ultrazohm/uz_per_wolfspeed_25kw_fm3/Meeting_Minutes(TemporarilyHere)/Meeting Minutes 30.01.25.docx

Questions:

- For the 3.3V LDO, the specific model that we need is TPS7A2033PDBVR
  - But I just used a generic model TPS7A20 for the Altium schematic and footprint. Is this okay?? How will the manufactuerers know it’s the 3.3V output specific model? Through our schematic?
  - NVM i got the 3.3V version through Ultrarian Library
- Decoupling capacitor also needed for 2.5VOCM right?
- Also for the 3.3V – 5V rail increase feedback resistor
  - Calculations – R1=6k6 R2=10k but 6k6 resistors not available
  - So did 6k8 and 10k as 10k3 resistors also not available. Is this okay?

ToDos:

- Make sure all the same F capacitors are the same model
- Make sure all the same R resistors are the same model
- Final check to make sure if possible same model components are used

Meeting Minutes

Capacitance

- General rule of thumb – all ICs add like 100nF in the input
- Our power
  - 100nF and add 1uF in the input ✅ 1uF first and then the 100nF
- For all of the components
  - Add capacitace for all the components
- Change all the 0.1uF to 100nF ✅
- E96 resistor line

Feedback for Op amps

- 6k65 0.1% and 10k 0603 package size
  - On DBeaver
    - Find 0603 package size resistor, change all the parameters for 6k65 and 0.1% ✅
      - Take parameters from https://jlcpcb.com/partdetail/Yageo-RT0603BRD076K65L/C861536 ✅
    - And then it will appear on Altium ✅
  - Change the 10k resistors to 0.1% as well ✅

Clean up the connector sheet – readable ✅

Shortcut to see what everything is connected to – alt + click.

2 layer PCB or 4 layer PCB look at what is better

- 4 layer seems likely
- https://jlcpcb.com/capabilities/pcb-capabilities

Ideally, return current flows back in the same way it came – just on a different layer

Ideally current passes through all the capacitors – place vias in a way that this happens

Make sure all layers have a similar amount of copper – to prevent bending

For PCB layout, for the specific ICs, look at the data sheets for inspiration

ToDos:

- Rooms feature to layout pcb
  - For vias 10mil uaually quite big
- Ideally set the rules looking at the jlcpcb capabilities
  - Github rules for the jlc rules
    - https://github.com/ayberkozgur/jlcpcb-design-rules-stackups/tree/master/design-rules/altium
    - Import 4layer-1oz.RUL (https://github.com/ayberkozgur/jlcpcb-design-rules-stackups/blob/master/design-rules/altium/4layer-1oz.RUL) rules
- Also check all components and make sure they are available in JLCPCB/LCSC
  - Price as well
  - If not chose something similar that is available
