ultrazohm/uz_per_wolfspeed_25kw_fm3/Meeting_Minutes(TemporarilyHere)/Midterm Presentation/MidtermPresentation.docx

Thesis Topic:

Interfacing a Two-Level Silicon Carbide Inverter to a Rapid Control Prototyping Platform

Topics to Cover:

- Wolfspeed 2-Level Silicon Carbide Inverter
  - Explanation
    - 800V level
      - Background on market technology
    - Why is Wolfspeed developing this
    - Why do we want to connect Ultrazohm
- Ultrazohm
  - Very briefly as everyone is probably quite familiar with it
- Outline Goal: To interface the Wolfspeed inverter with Ultrazohm - instead of the TI controller card
- Steps Taken until now:
  - Block diagram - identifying the signals the control card is getting from the inverter in the first place
    - We don’t include RSLV_PWM, 3-phase voltage conditioning and SIN/COS signals
      - FIGURE OUT WHY!
    - For all of the signals we determines requirements (such as frequency bandwidth, voltage levels, current levels)
  - LTspice simulations of all the important signal pathways
    - To determine voltage & current levels
      - Ex. There is a bias of 1.68V in the current conditioning because of external 3.3V source
    - Fully Differential Op amps used to do differential analog signaling
      - Because current conditioning is the most important for control - WHY??
    - Defining different voltage levels needed on the interface board
  - Altium
    - Schematic design
      - Power - LDO for 3.3V level, Voltage references for 2.5V and 1.7V level - why did we not also use a voltage reference for the 3.3V level?
        - Making sure that the current budget is kept in mind and fulfilled - 5V 1A input (from the inverter - check again to make sure the correct component that is supplying this)
        - Current pull of
          - Op amp
          - Receivers/Transmitters & dual inverter
          - AND IC
          - Etc.
      - Overcurrent detection - x2 IC of 3 pairs of AND gates - so in the end there is only one signal coming out from the 6 inputs
      - OpAmps with bias
        - Adjusting feedback to the 5V TTL level of the connected analog card - CHECK AND MAKE SURE
      - Decoupling capacitors
      - Ferrite Beads
      - LEDs for indication that it is working
    - PCB Layout
      - Layout finished under review

Next Steps:

- Ordering PCB
- Soldering components - WHAT COMPONENTS WILL I HAVE TO SOLDER ON?
  - Receivers/transmitters
  - Etc.
- Signal Test PCB
  - To test the integrity of the signals
    - We will have another PCB with the connectors signals separated in such a way that we can measure it
- Hook up to Wolfspeed Inverter and coupled motor in the Lab to Test if the interface works!
