ultrazohm/uz_per_wolfspeed_25kw_fm3/Altium_HotKeys.docx

Altium Hotkeys:

- C-C – Validate
- Messages – shows you all the errors
- T-M -> suppress all the errors

During polygon placement:

- Space bar changes the orientation of the vertices
- Change corner angles using Shift + Space
  - Supported corner types:
    - 45 degrees – only use this
    - Rounded 45
    - 90 degrees
    - Rounded 90
- Right mouse button click 2 times to complete polygon
- Tab to go to polygon properties

SHIFT + F -> find similar objects

CTRL + SHIFT + Scroll to change layers

SHIFT + S to toggle transparency
