ultrazohm/uz_per_wolfspeed_25kw_fm3/TI Edge Connector/Edge_connector_check.docx

TOP

1 3 5 … 55 57 119

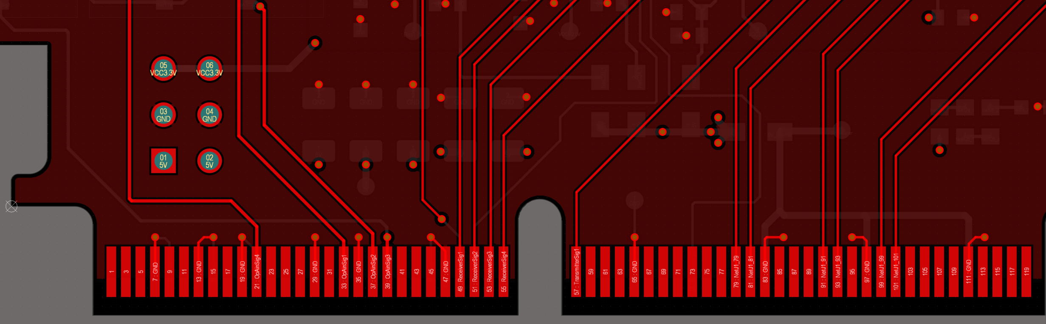
[picture p13: figure]

1 3 5 … 55 57 119

BOTTOM

120 118 … 58 56 2

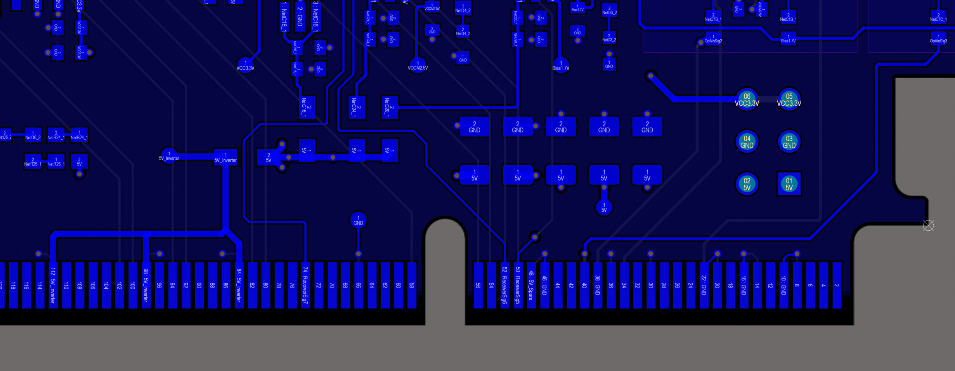
[picture p14: figure]

120 118 … 58 56 2

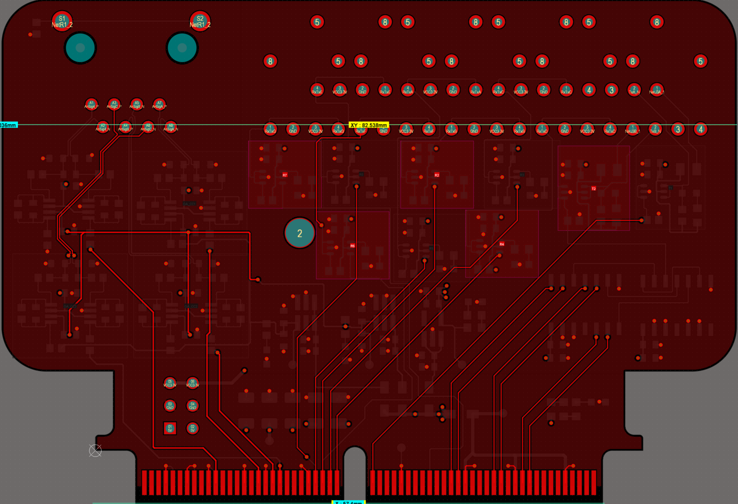
[picture p15: figure]
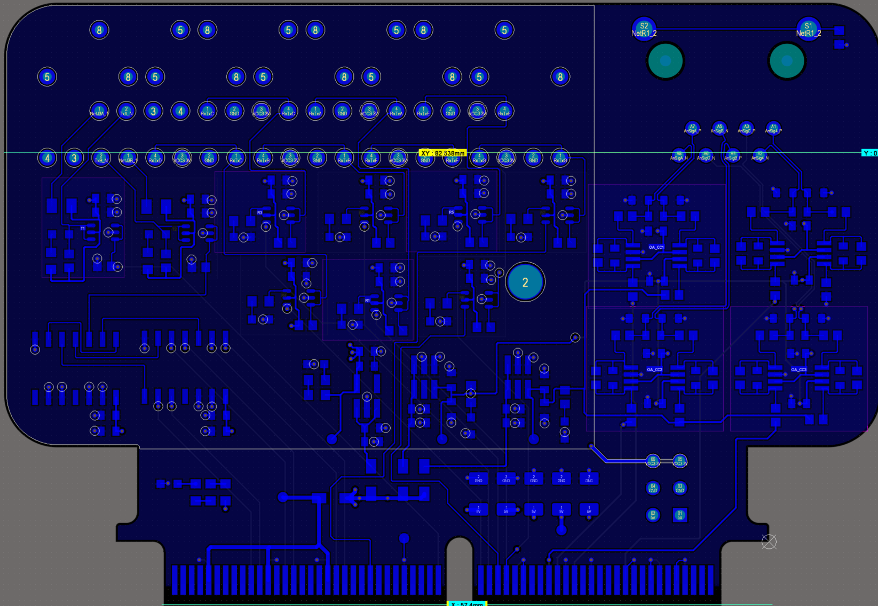
[picture p16: figure]
