ultrazohm/uz_per_wolfspeed_25kw_fm3/Meeting_Minutes(TemporarilyHere)/ToDos_for_051224.pdf

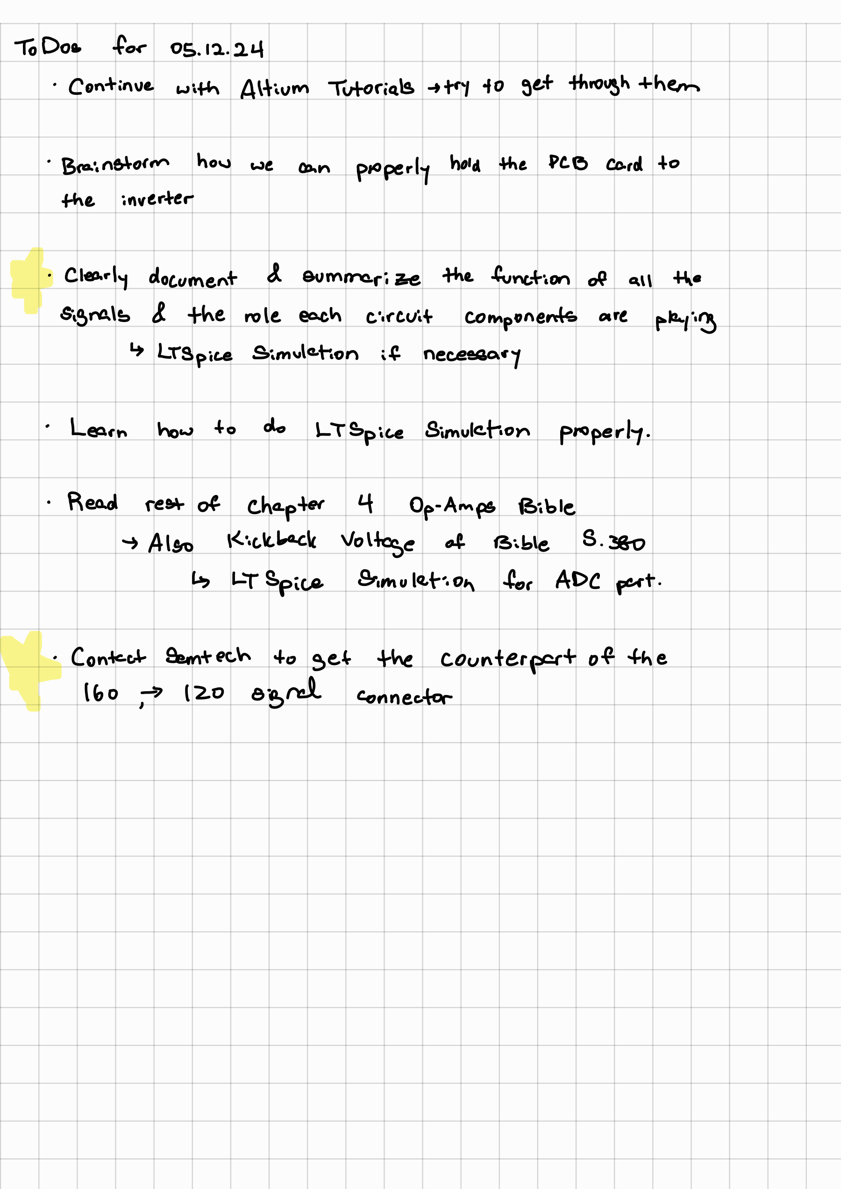
[picture p17: page 1]
