ultrazohm/uz_per_wolfspeed_25kw_fm3/Meeting_Minutes(TemporarilyHere)/ToDos_for_141124.pdf

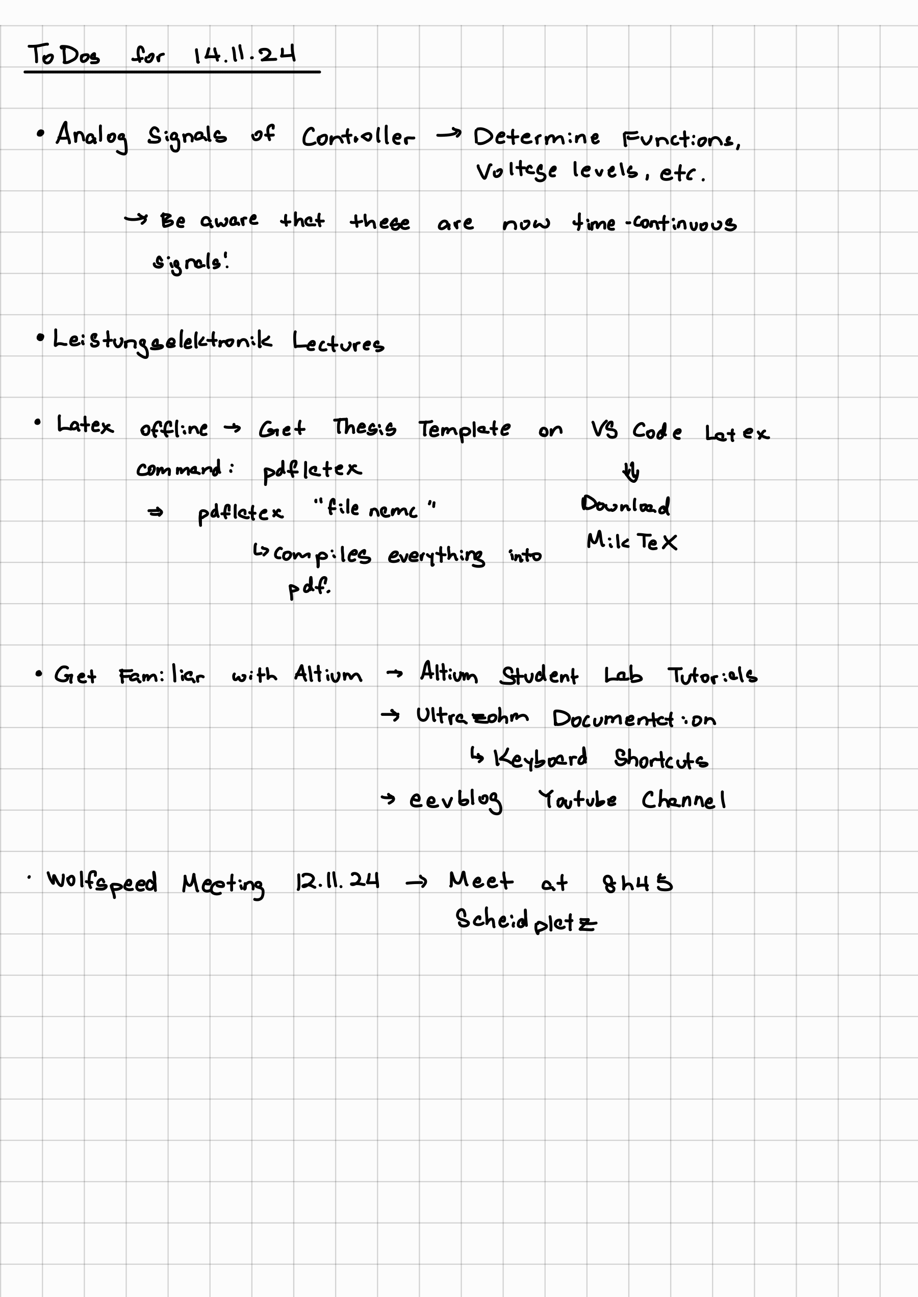
[picture p18: page 1]
