ultrazohm/uz_per_wolfspeed_25kw_fm3/Meeting_Minutes(TemporarilyHere)/ToDos_for_211124.pdf

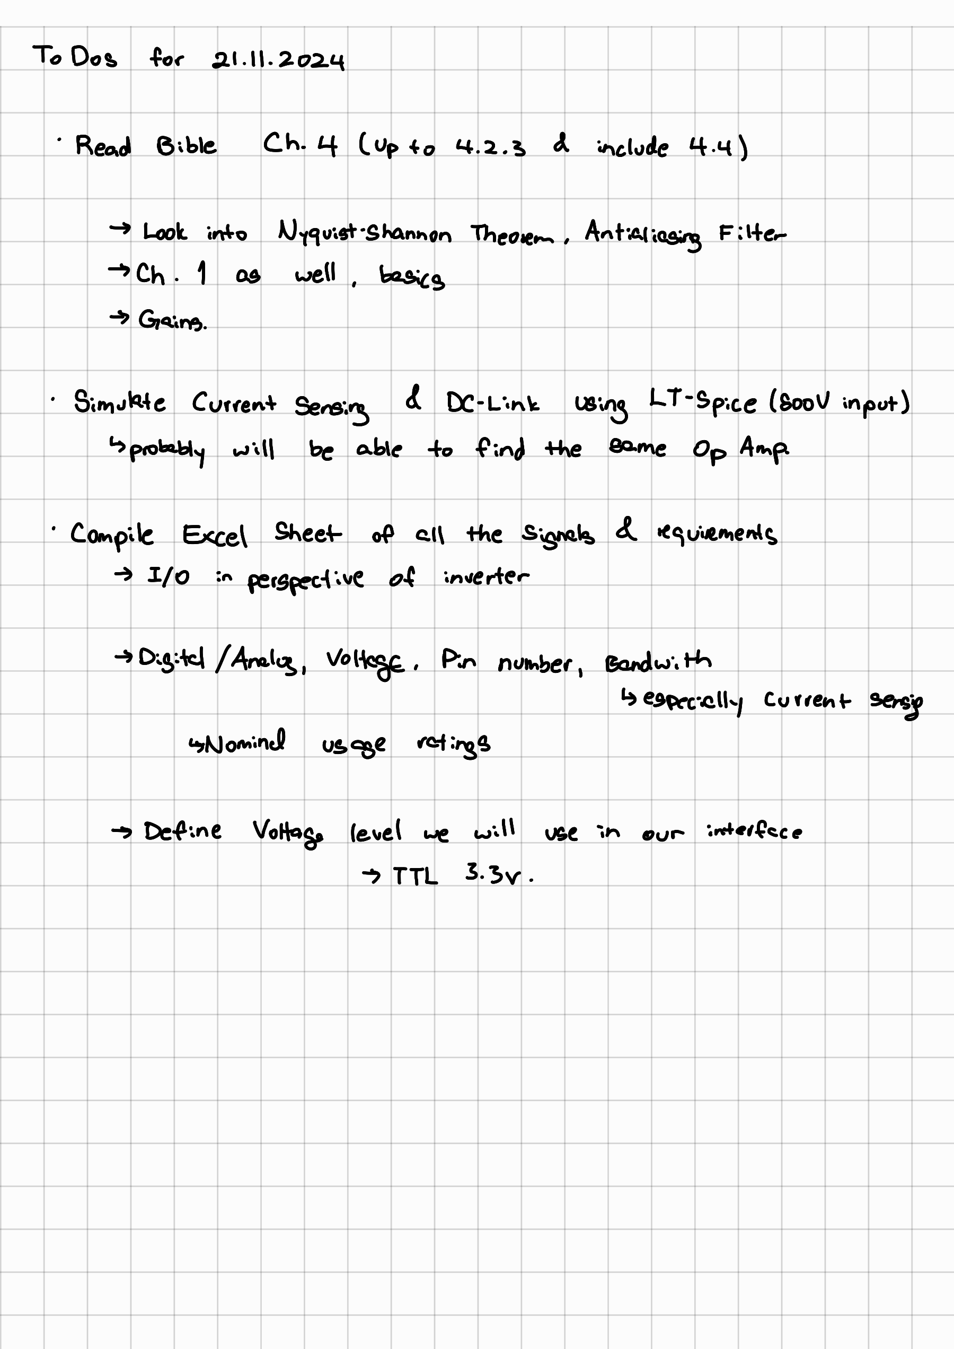
[picture p19: page 1]
