ultrazohm/uz_per_wolfspeed_25kw_fm3/Meeting_Minutes(TemporarilyHere)/ToDos_for_281124.pdf

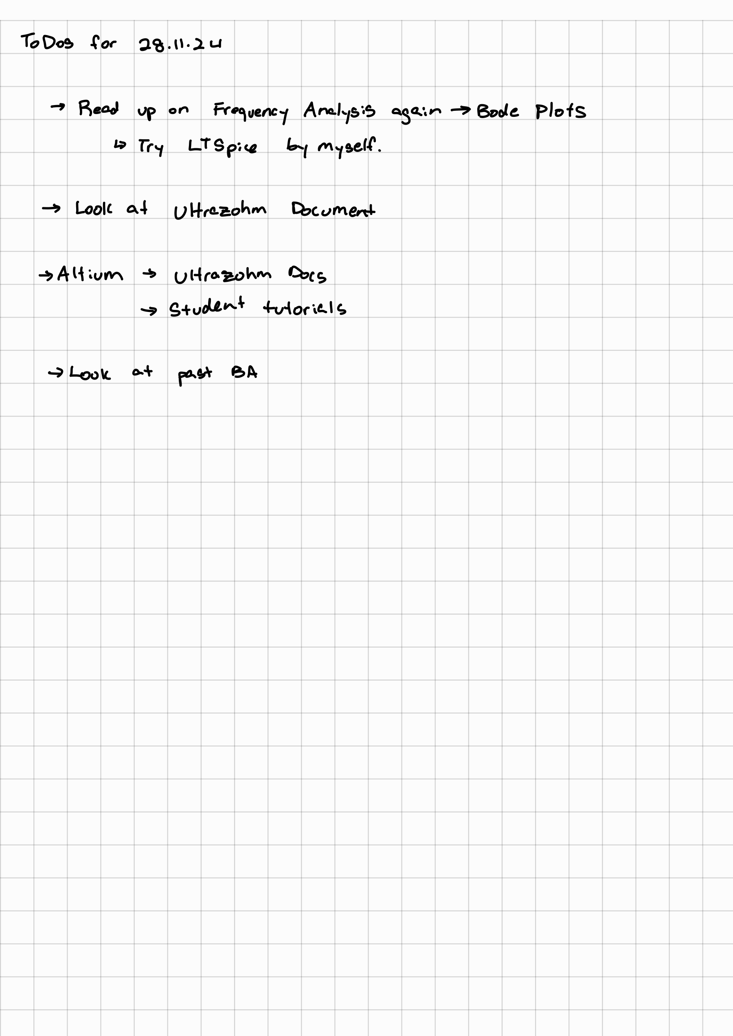
[picture p20: page 1]
