ultrazohm/uz_per_wolfspeed_25kw_fm3/Meeting_Minutes(TemporarilyHere)/InterfacePowerDesign.xlsx

Voltage Level | Purpose | Part Name | Rated Power (W) | Rated Current | Quiescent Current | Total Pulled Current
5V | Current Conditioning | THS4561DGKT Fully Differential OpAmp |  |  | 775uA | 2mA
 | Current Conditioning | THS4561DGKT Fully Differential OpAmp |  |  |  | 2mA
 | Current Conditioning | THS4561DGKT Fully Differential OpAmp |  |  |  | 2mA
 | DC Voltage Conditioning | THS4561DGKT Fully Differential OpAmp |  |  |  | 2.5mA
2.5V | VOCM | THS4561DGKT |  |  |  | 16.2nA
 | VOCM | THS4561DGKT |  |  |  | 16.2nA
 | VOCM | THS4561DGKT |  |  |  | 16.2nA
 | VOCM | THS4561DGKT |  |  |  | 16.2nA
1.65V | Bias | THS4561DGKT |  |  |  | 368nA
 | Bias | THS4561DGKT |  |  |  | 368nA
 | Bias | THS4561DGKT |  |  |  | 368nA
3.3V | Optical Reciever1 |  |  |  | 10mA | max. 25mA | High Level Supply Current: max 6.3mA at 5.25Vcc
 | Optical Reciever2 |  |  |  |  | max. 25mA
 | Optical Reciever3 |  |  |  |  | max. 25mA
 | Optical Reciever4 |  |  |  |  | max. 25mA
 | Optical Reciever5 |  |  |  |  | max. 25mA
 | Optical Reciever6 |  |  |  |  | max. 25mA
 | Optical Reciever7 |  |  |  |  | max. 25mA
 | Dual Inverter1 |  |  |  | 10u | max 16mA -> high level output current at V_cc =3V
 | Dual Inverter2 |  |  |  |  | max 16mA | I_cc max 10 uA
 | Dual Inverter3 |  |  |  |  | max 16mA
 | Dual Inverter4 |  |  |  |  | max 16mA
 | Dual Inverter5 |  |  |  |  | max 16mA
 | Dual Inverter6 |  |  |  |  | max 16mA
 | Dual Inverter7 |  |  |  |  | max 16mA
 | Receiver Circuit 1
 | Receiver Circuit 2
 | Receiver Circuit 3
 | Receiver Circuit 4
 | Receiver Circuit 5
 | Receiver Circuit 6
 | Receiver Circuit 7
 | Optical Transmitter 1 |  |  |  | 33mA Transmitter + inverter | max. 80mA (continuous forward current I_Fdc)
 | Optical Transmitter 2 |  |  |  |  | max. 80mA
 | Dual Inverter 1 |  |  |  |  | max 16mA
 | Dual Inverter 2 |  |  |  |  | max 16mA
 | AND Gate Overcurrent1 |  |  |  |  | 20.1u
 | AND Gate Overcurrent2 |  |  |  |  | 10.2u
