ultrazohm/uz_per_wolfspeed_25kw_fm3/Altium/Project Outputs for uz_per_wolfspeed_25kw_FM3/Rev04/BOM_JLC/BOM_JLC_uz_per_wolfspeed_25kw_FM3_jlc_Rev04.xlsx

Name | Designator | Footprint | LCSC Part Number
10 uF | C1, C2, C3, C4, C5 | C_1206 | C13585
56 pF | C6A, C6B, C6C, C12A, C12B, C12C, C48, C54 | C_0603 | C39148
100 pF | C7A, C7B, C7C, C9A, C9B, C9C, C49, C51 | C_0603_TE | C14858
2.2 nF | C8A, C8B, C8C, C50 | C_0603 | C93190
100 nF | C10A, C10B, C10C, C11A, C11B, C11C, C13A, C13B, C13C, C13D, C13E, C13F, C13G, C15A, C15B, C28, C29, C30, C31, C37, C38, C41, C42, C45, C46, C52, C53, C55, C57, C59, C61, C62 | C_0603 | C14663
1 µF | C14A, C14B, C14C, C14D, C14E, C14F, C14G, C16A, C16B, C32, C33, C34, C35, C36, C39, C40, C43, C44, C47, C56, C58, C60, C63 | C_0603 | C29936
C0603C104K3RACTU | C17, C18 | FP-C0603C-CF-IPC_B
CL10C560JB8NNNC | C19, C21, C22, C24, C25, C27 | FP-C0603C-CF-IPC_B
C0603C472K3RAC7867 | C20, C23, C26 | FP-C0603C-CF-IPC_B
150060RS75000 | D1A, D1B, D1C, D1D, D1E, D1F, D1G, D3, D4, D5, D6 | WL-SMCW_0603 | C2286
150060GS75000 | D2A, D2B | WL-SMCW_0603 | C965804
LED Red | D7 | LEDM2012X80N
LTC6992CS6-2#TRMPBF | IC1 | SOT95P280X100-6N | C581035
HSEC8-TI-160-01-XX-DV-A-BL-CARD | J1 | HSEC8-TI-160-SAMTEC-Connector
HFBR-2521Z | J2A, J2C, J2E | HFBRx5XX
HFBR-1521Z | J3A | HFBRx5XX
600Ω | L1, L2, L3, L4 | WE-CBF_0805_High Current | C98308
0R | R1 | RES 0603_1608 | C21189
10k | R2A, R2B, R2C, R7A, R7B, R7C, R8A, R8B, R8C, R8D, R8E, R8F, R8G, R11A, R11B, R13A, R13B, R33, R38, R39, R41, R42 | RES 0603_1608 | C860067, C25804
6k65 | R3A, R3B, R3C, R5A, R5B, R5C, R34, R36 | RES 0603_1608 | C861536
49R9 | R4A, R4B, R4C, R6A, R6B, R6C, R28, R35, R37 | RES 0603_1608 | C160046
680R | R9A, R9B, R9C, R9D, R9E, R9F, R9G, R12A, R12B, R26, R27, R29, R30, R31, R32 | R_0603_N | C23228
56R | R10A, R10B | RES_2012X06N | C17437
ERJ-3EKF49R9V | R14, R15, R19, R20, R21, R22, R23, R24, R25 | FP-MCR03-IPC_B
110R | R16, R18 | R_0603_TE | C705717
887R | R17 | R_0603_TE | C47115921
220R | R40 | RES 0603_1608
68k | R43 | RES 0603_1608
182k | R44 | RES 0603_1608 | C203368
976k | R45 | RES 0603_1608 | C162980
MMBT3904 | T1 | SOT95P280X145-3N | C20526
THS4561IDGKT | U1A, U1B, U1C, U10 | SOP65P490X110-8N | C2860980
Dual Inverter | U2A, U2B, U2C, U2D, U2E, U2F, U2G, U3A, U3B, U11 | SN74LVC2GU04DCKR | C116660
TLV3502AID | U4, U5, U6 | FP-D0008A-IPC_B
TPS7A2033PDBVR | U7 | DBV0005A-IPC_A | C2862740
REF35170QDBVR | U8 | DBV0006A-IPC_A | C20345634
REF35250QDBVR | U9 | DBV0006A-IPC_A | C6265005
SN74HCS08DR | U12, U13 | SOIC127P600X175-14N | C2868021
SN74LVC1G74DCTR | U14 | MSOP-8 | C840104
R-RJ45R10P-B000 | X1 | R-RJ45R10P-B000 | C386758
2.54-2*3 | X2, X3 | SAMTEC_TSW-103-05-G-D | C5116479
