ultrazohm/uz_per_wolfspeed_25kw_fm3/Altium/step/assembly/Clamp.SLDPRT

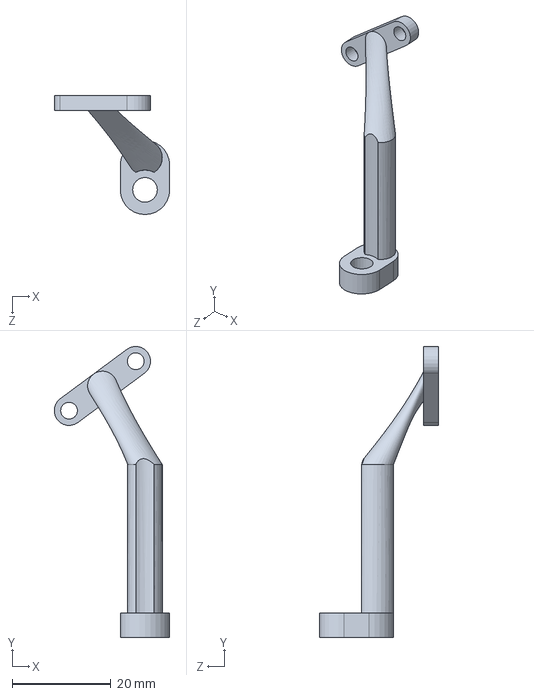
[picture p21: CAD file, 2026-07-08]
Altium/step/assembly/Clamp.SLDPRT
23.4 x 58.9 x 24.1 mm
