ultrazohm/uz_per_wolfspeed_25kw_fm3/Altium/step/stl/BothClamps.3mf

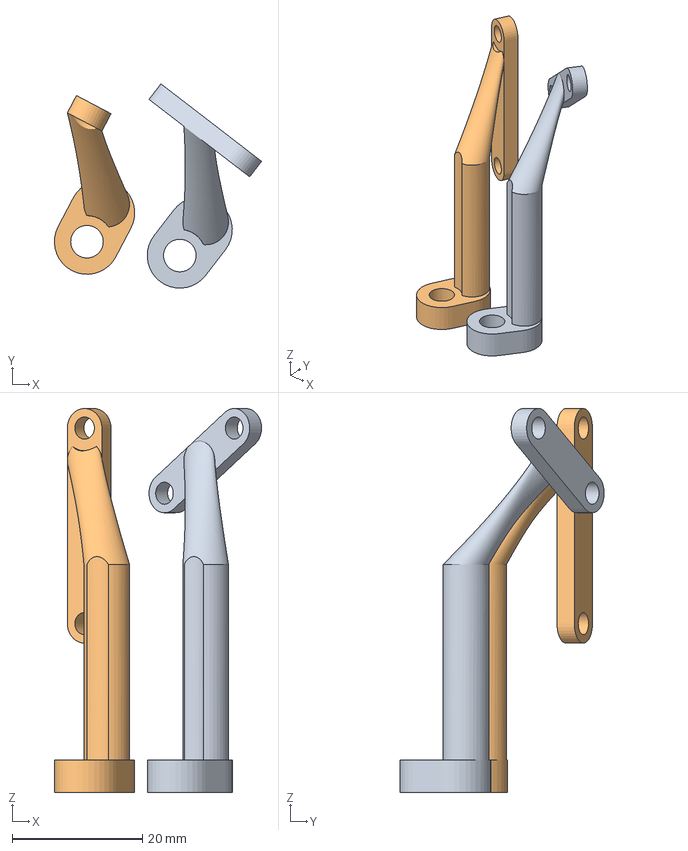
[picture p22: CAD file, 2026-07-08]
Altium/step/stl/BothClamps.3mf
31.8 x 31.3 x 58.9 mm
Clamp.STL
Clamp_long - Kopie.STL
