ultrazohm/uz_per_wolfspeed_25kw_fm3/PCB_Mounting_3d/PCB_Mounting_plus2mm.step

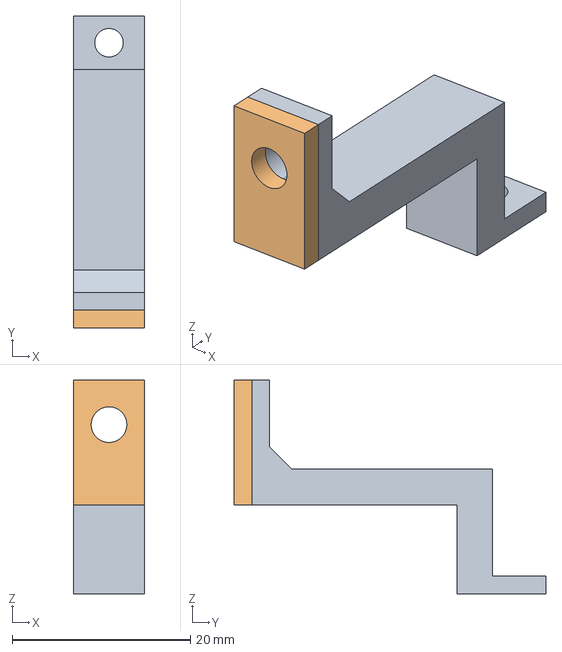
[picture p23: CAD file, 2026-03-10]
PCB_Mounting_3d/PCB_Mounting_plus2mm.step
8.00 x 35.0 x 24.0 mm
PCB_Mounting
