ultrazohm/uz_per_wolfspeed_25kw_fm3/Altium/step/assembly/Clamp_long - Kopie.SLDPRT

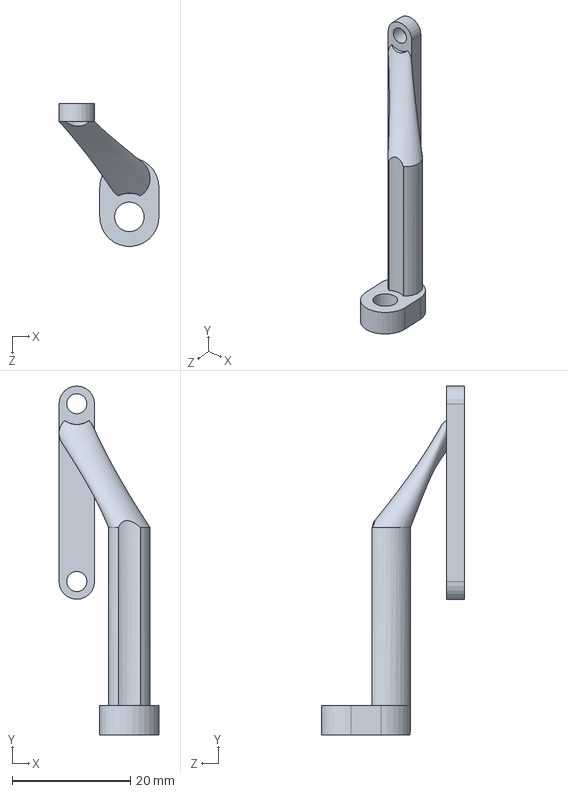
[picture p24: CAD file, 2026-07-08]
Altium/step/assembly/Clamp_long - Kopie.SLDPRT
16.9 x 58.9 x 24.1 mm
