ultrazohm/uz_per_wolfspeed_25kw_fm3/Altium/step/stl/Clamp.STL

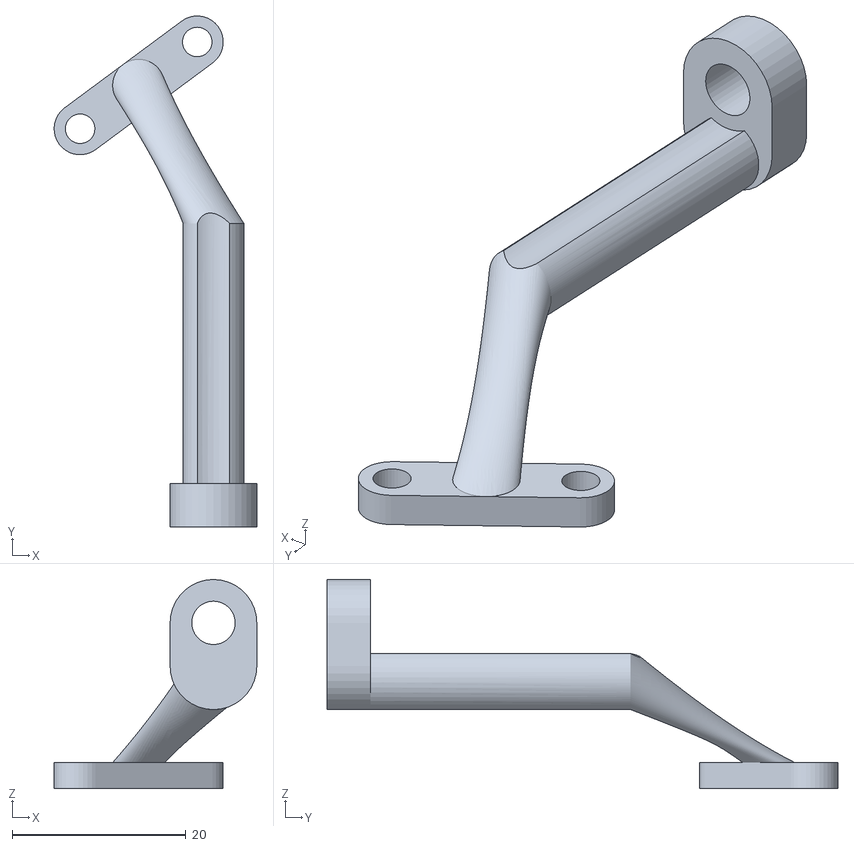
[picture p25: CAD file, 2026-07-08]
Altium/step/stl/Clamp.STL
23.4 x 58.9 x 24.1
