ultrazohm/uz_per_wolfspeed_25kw_fm3/PCB_Mounting_3d/PCB_Mounting.STEP

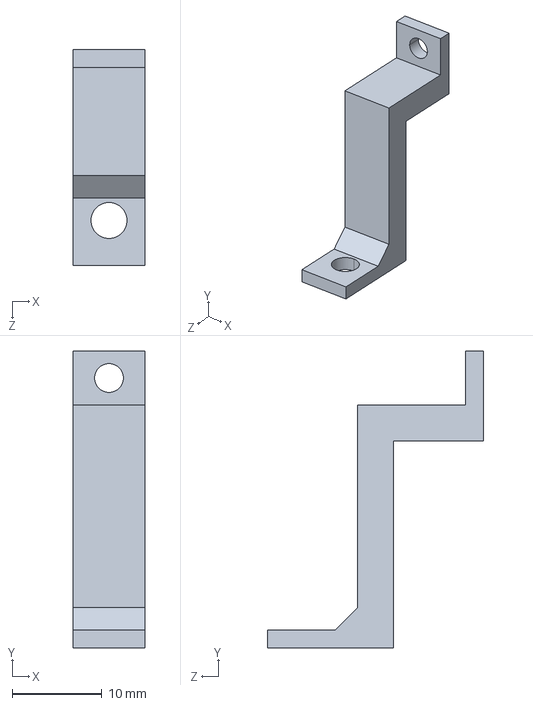
[picture p26: CAD file, 2026-01-27]
PCB_Mounting_3d/PCB_Mounting.STEP
8.00 x 33.0 x 24.0 mm
