ultrazohm/uz_per_wolfspeed_25kw_fm3/(list of files, cad)

Other CAD files:
Altium/step/stl/Clamp_long - Kopie.STL
PCB_Mounting_3d/PCB_Mounting.step.STL
PCB_Mounting_3d/PCB_Mounting_TEST.SLDPRT
PCB_Mounting_3d/PCB_Mounting_plus2mm.FCStd
PCB_Mounting_3d/PCB_Mounting_plus2mm.STL
