ultrazohm/uz_per_wolfspeed_25kw_fm3/Meeting_Minutes(TemporarilyHere)/LabAnalogSignalTEST_13.03.2025.docx

Analog Singal Test

- Soldered on: VDC voltage conditioning path with fully differential op amp
- On PCB test board: analog input signal incoming from the “inverter” coming through pin 100 (due to the Verschiebung due to differences in schematics/footprint

Things to keep in mind:

- For the fully differential op amp, make sure not to use too much solder paste as the pads are very close together
  - In the first bake we had shorted pathways

Test 1

Issue:

- No 2.5V Common Mode, Common mode displaying to be 5V - BAD
- 5/3.3 = 1.515151 Gain can be seen – GOOD!

Trouble Shooting

- Looked at the board under the microscope
  - For the OpAmp, 5V and 2.5V CM pads were connected

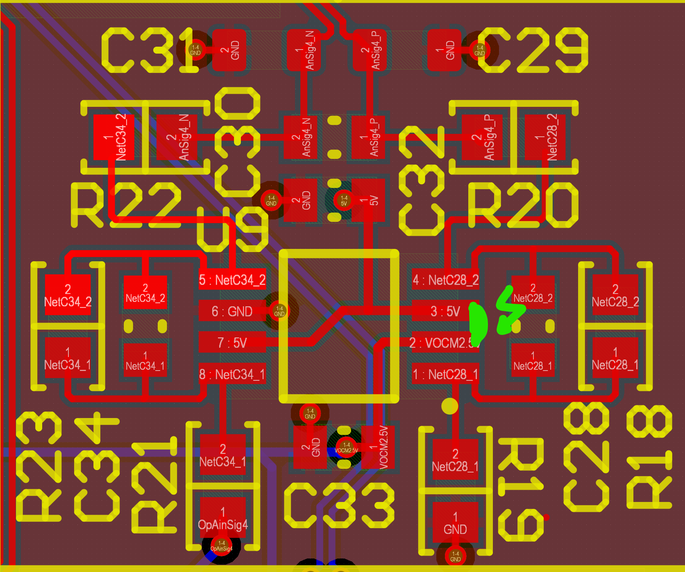
[picture p27: figure]

- Using heat gun, and solder wick tried to remove the excess solder
- Did not work – Accidentally burnt the op amp – one leg fell off

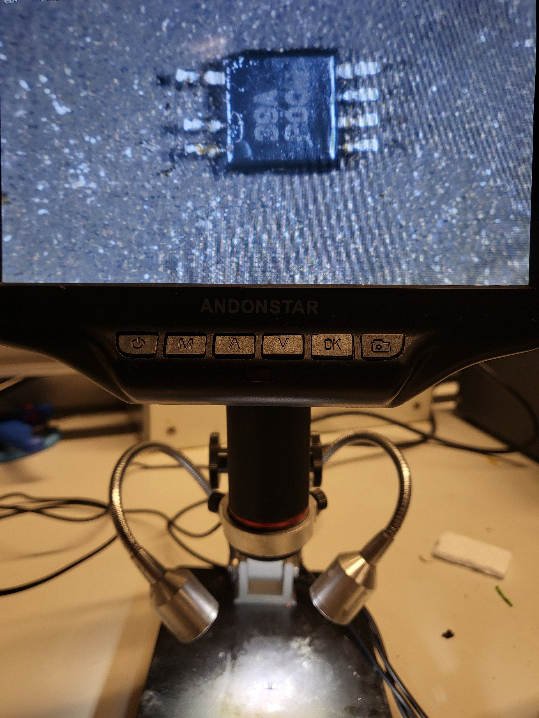
[picture p28: figure]

Soldered on a new Op Amp

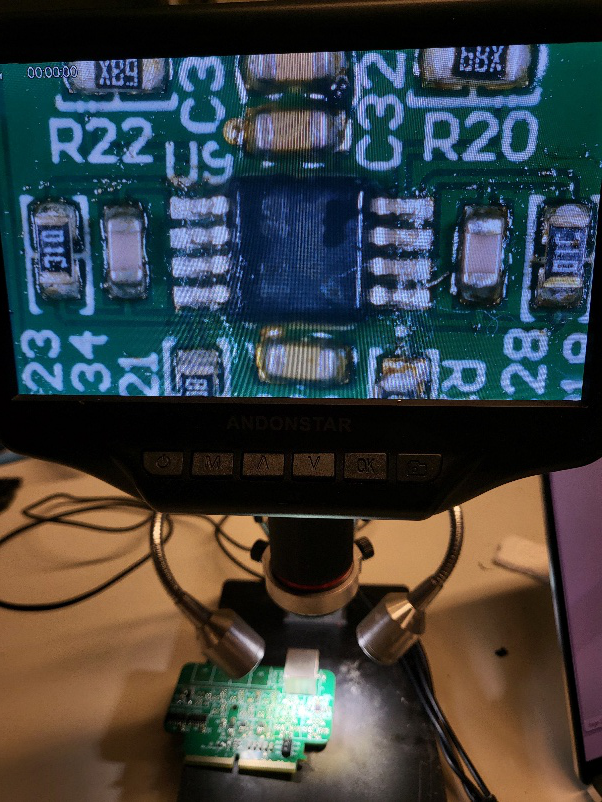
[picture p29: figure]

Test 2:

Setup

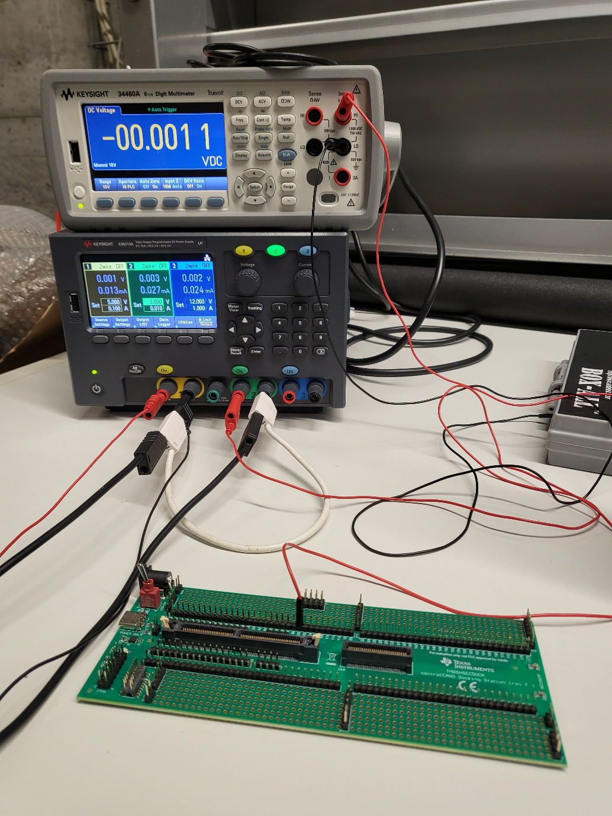
[picture p30: figure]

Multimeter on top

DC Power Supply on the bottom

PCB test board

We want to test the VDC Analog Signal

- Input of 2V at 0.010A at pin 100 (due to the footprint issue)
- 5V supply at 0.1A directly into the board itself

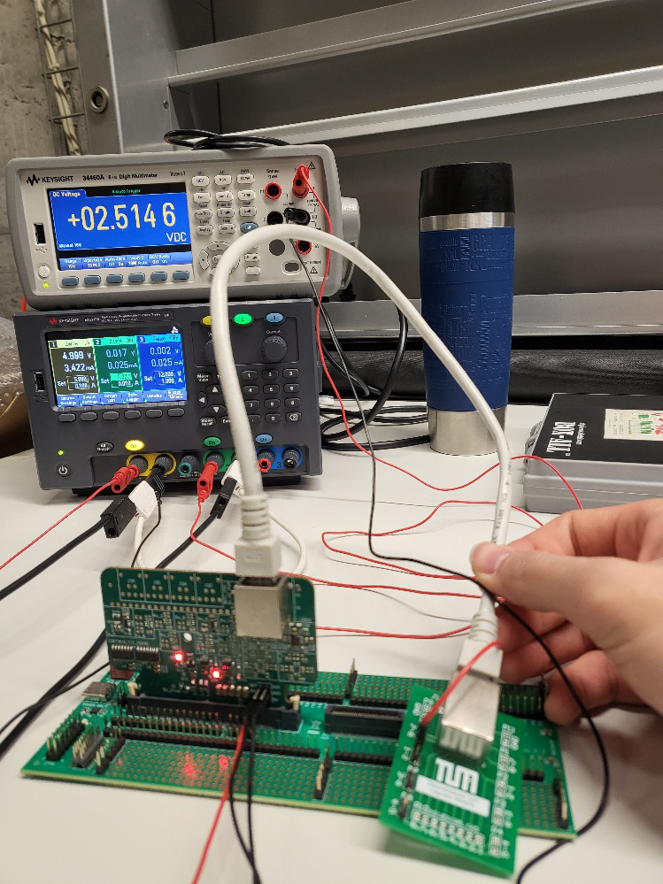
[picture p31: figure]

Ethernet port breakout board – pins 1 and 2 were for the VDC voltage conditioning differential signal

In picture above, measuring only with 5V supply to the board, no analog signal going though

- 2.5V is displayed for both output ethernet pins – GOOD!
- One pin set to GND, other set to breakout board
- For oth pins 2.5V when the analog signal has no current

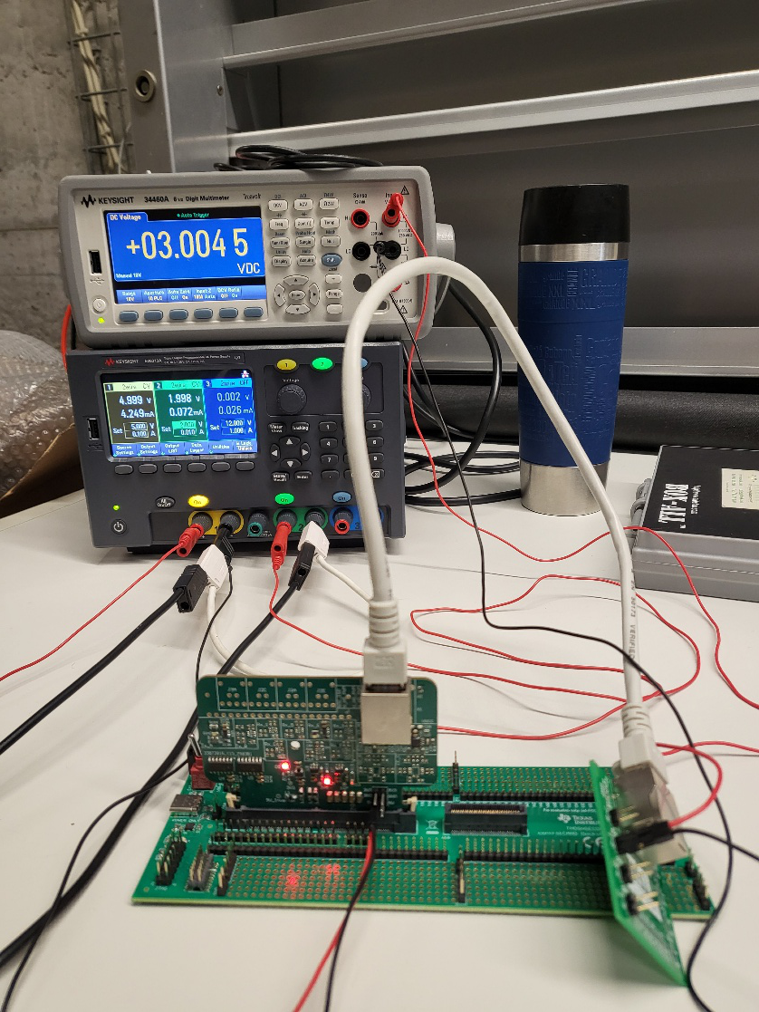
[picture p32: figure]

Measuring the differential signal with the analog signal on (can see on green light in the power supply

For 1.998V input, we get output of 3V

- Gain = 1.501....
- Expected gain : 5V/3.3V = 1.5151515.....

Input signal voltage (V) | Differential output (V) | Positive output (V) | Negative output (V)
0 | 24.5m | 2.513 | 2.489
1.004 | 1.510 | 3.256 | 1.746
2.005 | 3.014 | 4.008 | 0.9949
2.504 | 3.765 | 4.384 | 0.619
3.003 | 4.516 | 4.759 | 0.2432
3.503 | 4.923 | 4.952 | 28.55mV
4.004 | 4.922 | 4.951 | 29.03mV
4.503 | 4.921 | 4.951 | 29.51mV

Current Conditioning (fully differential op amp with 1.7V input bias)

Pin 88 for analog signal – DOUBLE CHECK!

Without any analog signal supplied (only 5V supply for op amp)

Expected: both input and output pins are at common mode 2.5V – right??

Reality:

Negative output pin

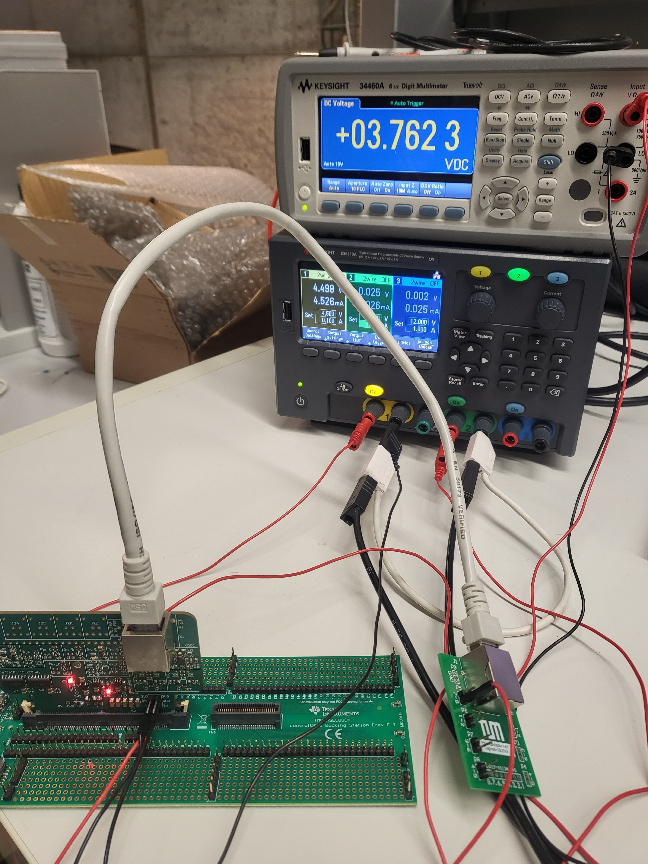
[picture p33: figure]

Positive output pin

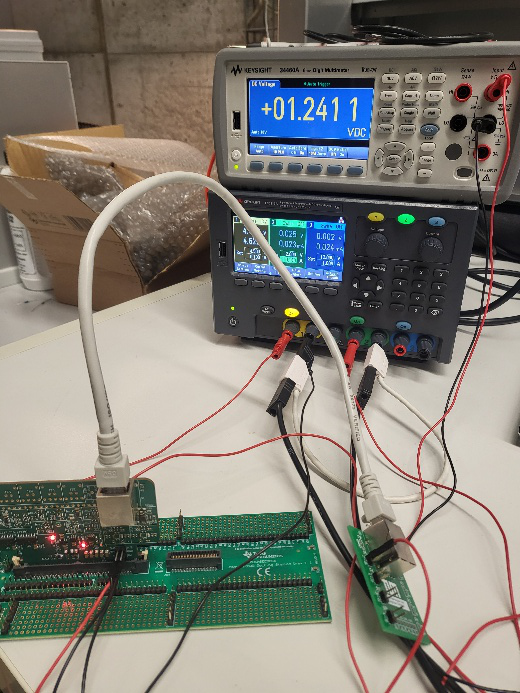
[picture p34: figure]

Differential

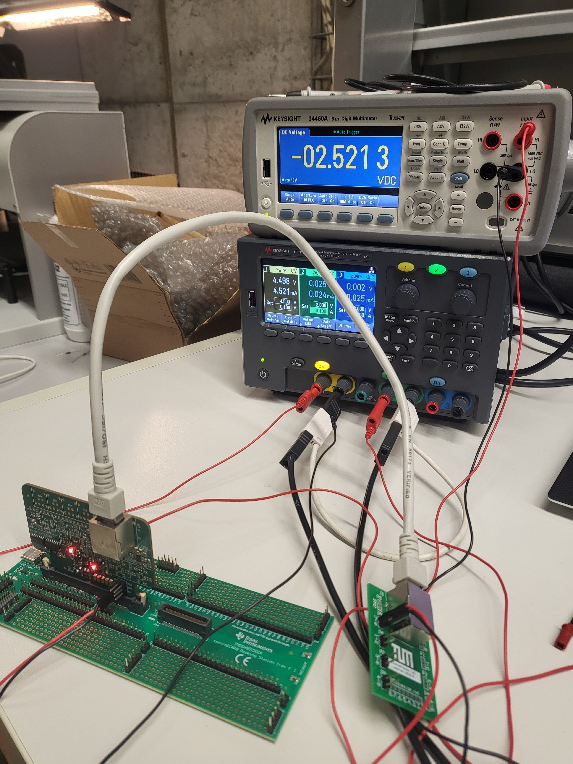
[picture p35: figure]

With Analog signal – 1.998V -0.005mA

Negative output pin

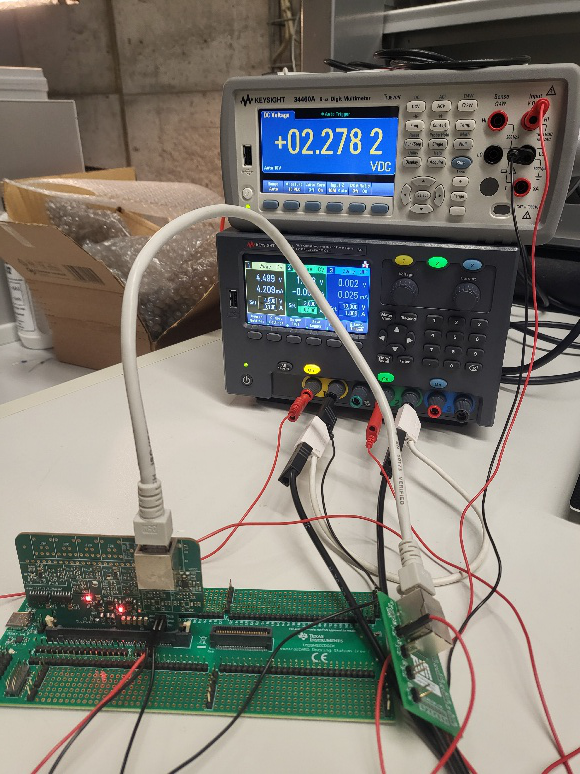
[picture p36: figure]

Positive output pin

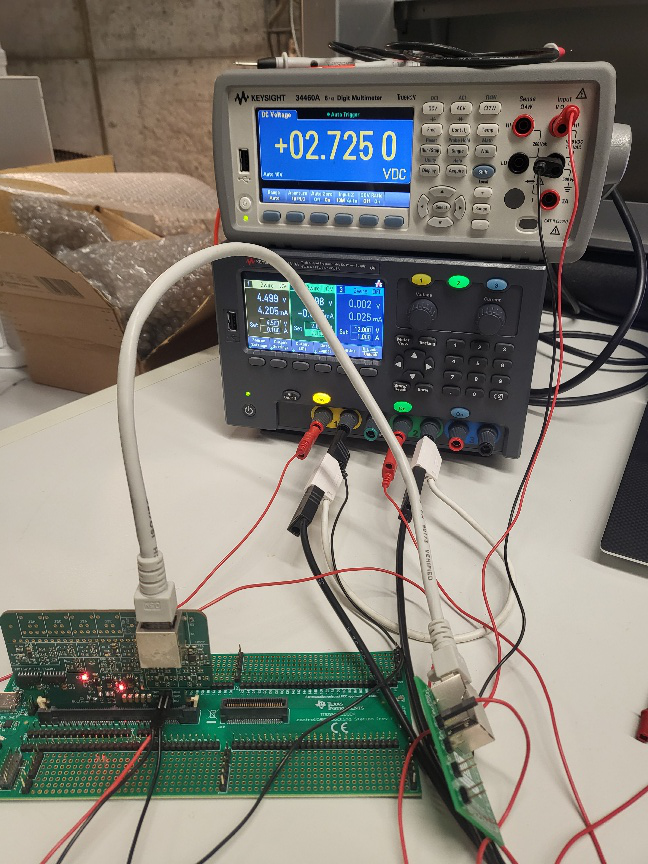
[picture p37: figure]

Differential

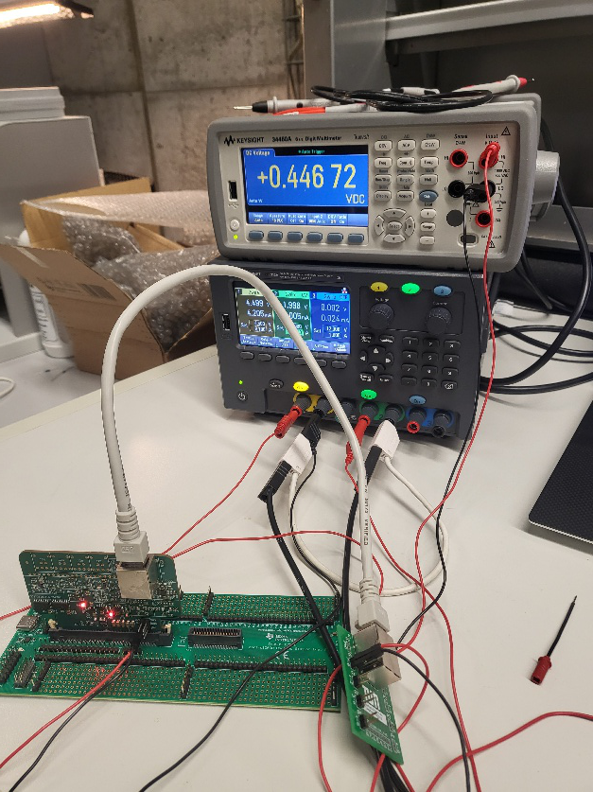
[picture p38: figure]

Gain: 0.446/1.998 = 0.2232 - wrong

Expected Gain:

I DUNNO THINK ABOUT THIS – input signal has 1.7V bias as well so we have to input 1.7V to get the zero value in the differential output!

Table

Input signal voltage (V) | Differential output (V) | Positive output (V) | Negative output (V)
0 | 2.52 | 1.240 | 3.763
1.703 | 0.00452 | 2.503 | 2.499
1.804 | 0.155 | 2.579 | 2.424
1.905 | 0.306 | 2.655 | 2.348
2.005 | 0.457 | 2.730 | 2.273
2.105 | 0.608 | 2.805 | 2.198
2.203 | 0.756 | 2.879 | 2.123
2.303 | 0.907 | 2.955 | 2.048
2.404 | 1.057 | 3.030 | 1.973
2.504 | 1.208 | 3.105 | 1.897
2.604 | 1.359 | 3.181 | 1.822
2.704 | 1.510 | 3.256 | 1.747
2.803 | 1.658 | 3.330 | 1.672
2.903 | 1.809 | 3.406 | 1.597
3.003 | 1.959 | 3.481 | 1.522
3.103 | 2.110 | 3.556 | 1.446
3.203 | 2.261 | 3.632 | 1.371
3.303 | 2.412 | 3.707 | 1.296
3.502 | 2.711 | 3.857 | 1.146
4.004 | 3.464 | 4.233 | 0.769
4.503 | 4.216 | 4.609 | 0.393
5.002 | 4.924 | 4.954 | 30.3mV
