ultrazohm/uz_per_wolfspeed_25kw_fm3/Wolfspeed Inverter Files/CRD25DA12N-FMC_Schematic/CRD25DA12N-FMC V1.1 (07-2023) - Schematic.pdf

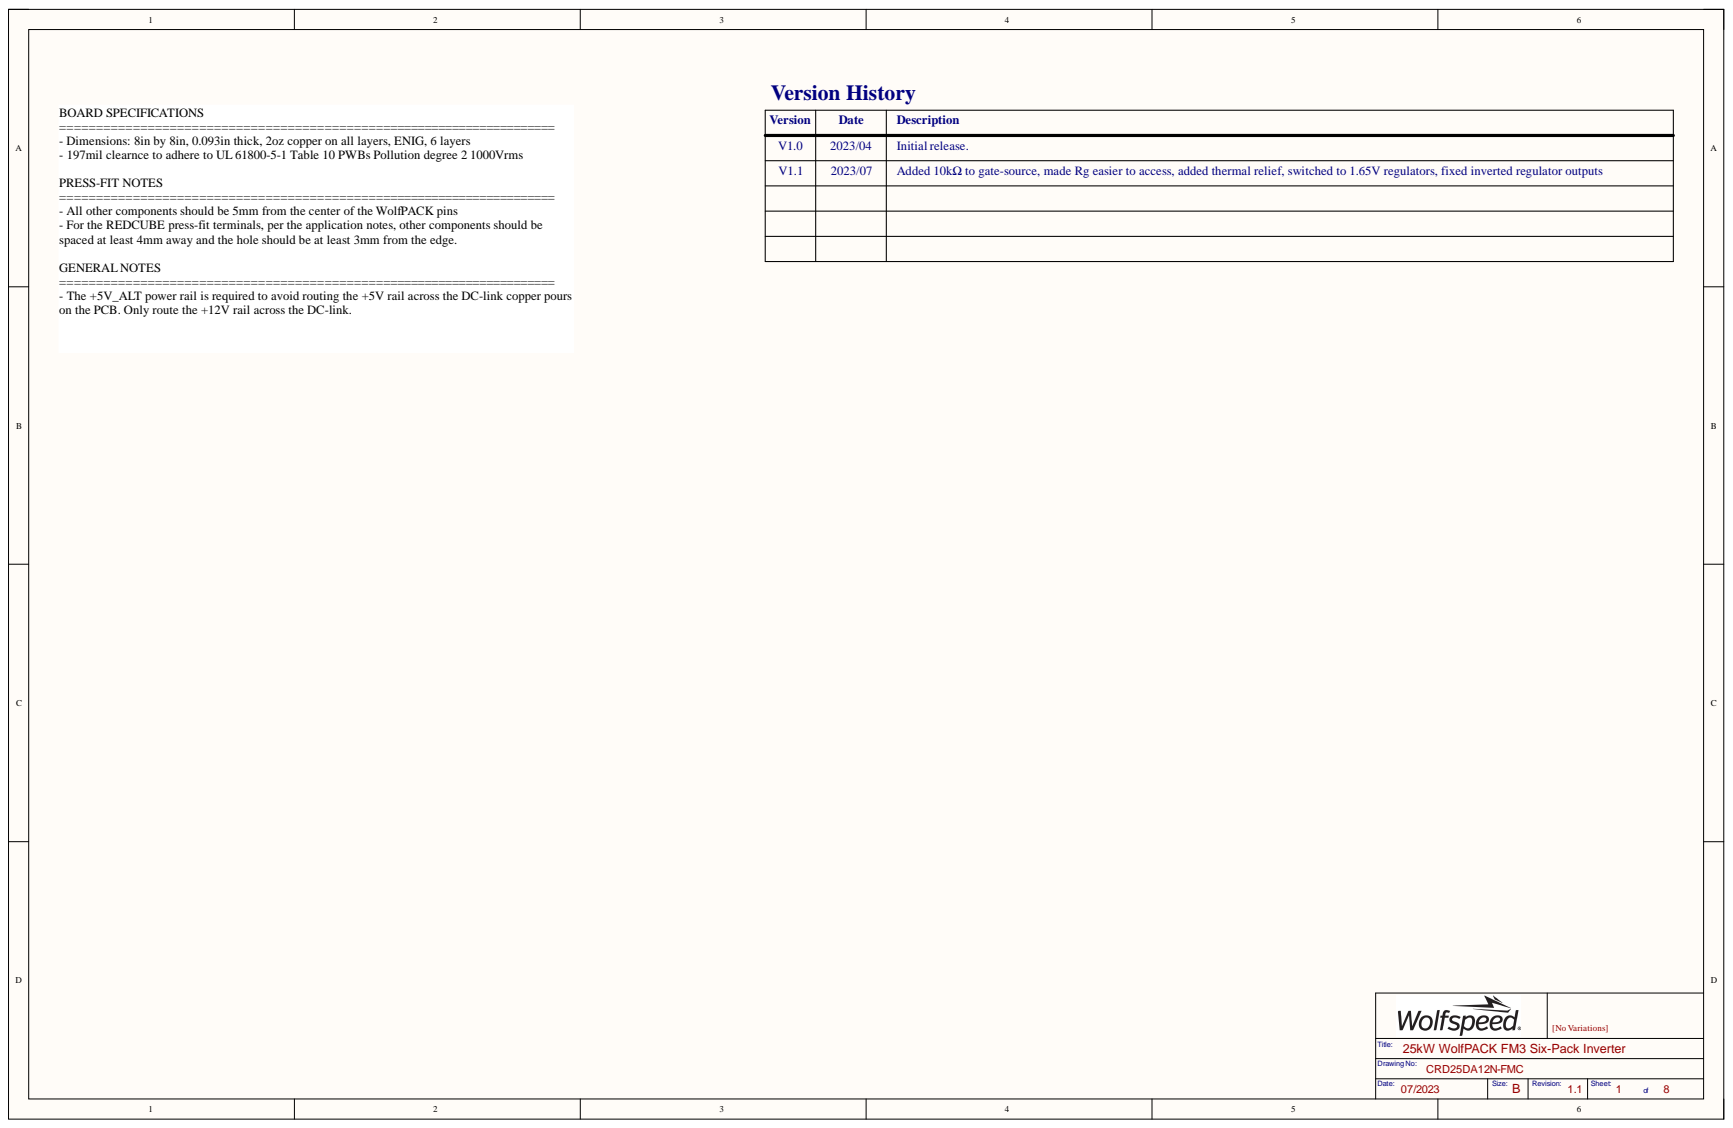
[picture p39: page 1]

BOARD SPECIFICATIONS
- Dimensions: 8in by 8in, 0.093in thick, 2oz copper on all layers, ENIG, 6 layers
- 197mil clearnce to adhere to UL 61800-5-1 Table 10 PWBs Pollution degree 2 1000Vrms

V1.0 | 2023/04 | Initial release.

PRESS-FIT NOTES
- All other components should be 5mm from the center of the WolfPACK pins
- For the REDCUBE press-fit terminals, per the application notes, other components should be
spaced at least 4mm away and the hole should be at least 3mm from the edge.

V1.1 | 2023/07 | Added 10kΩ to gate-source, made Rg easier to access, added thermal relief, switched to 1.65V regulators, fixed inverted regulator outputs

GENERAL NOTES
- The +5V_ALT power rail is required to avoid routing the +5V rail across the DC-link copper pours
on the PCB. Only route the +12V rail across the DC-link.

Title:
25kW WolfPACK FM3 Six-Pack Inverter

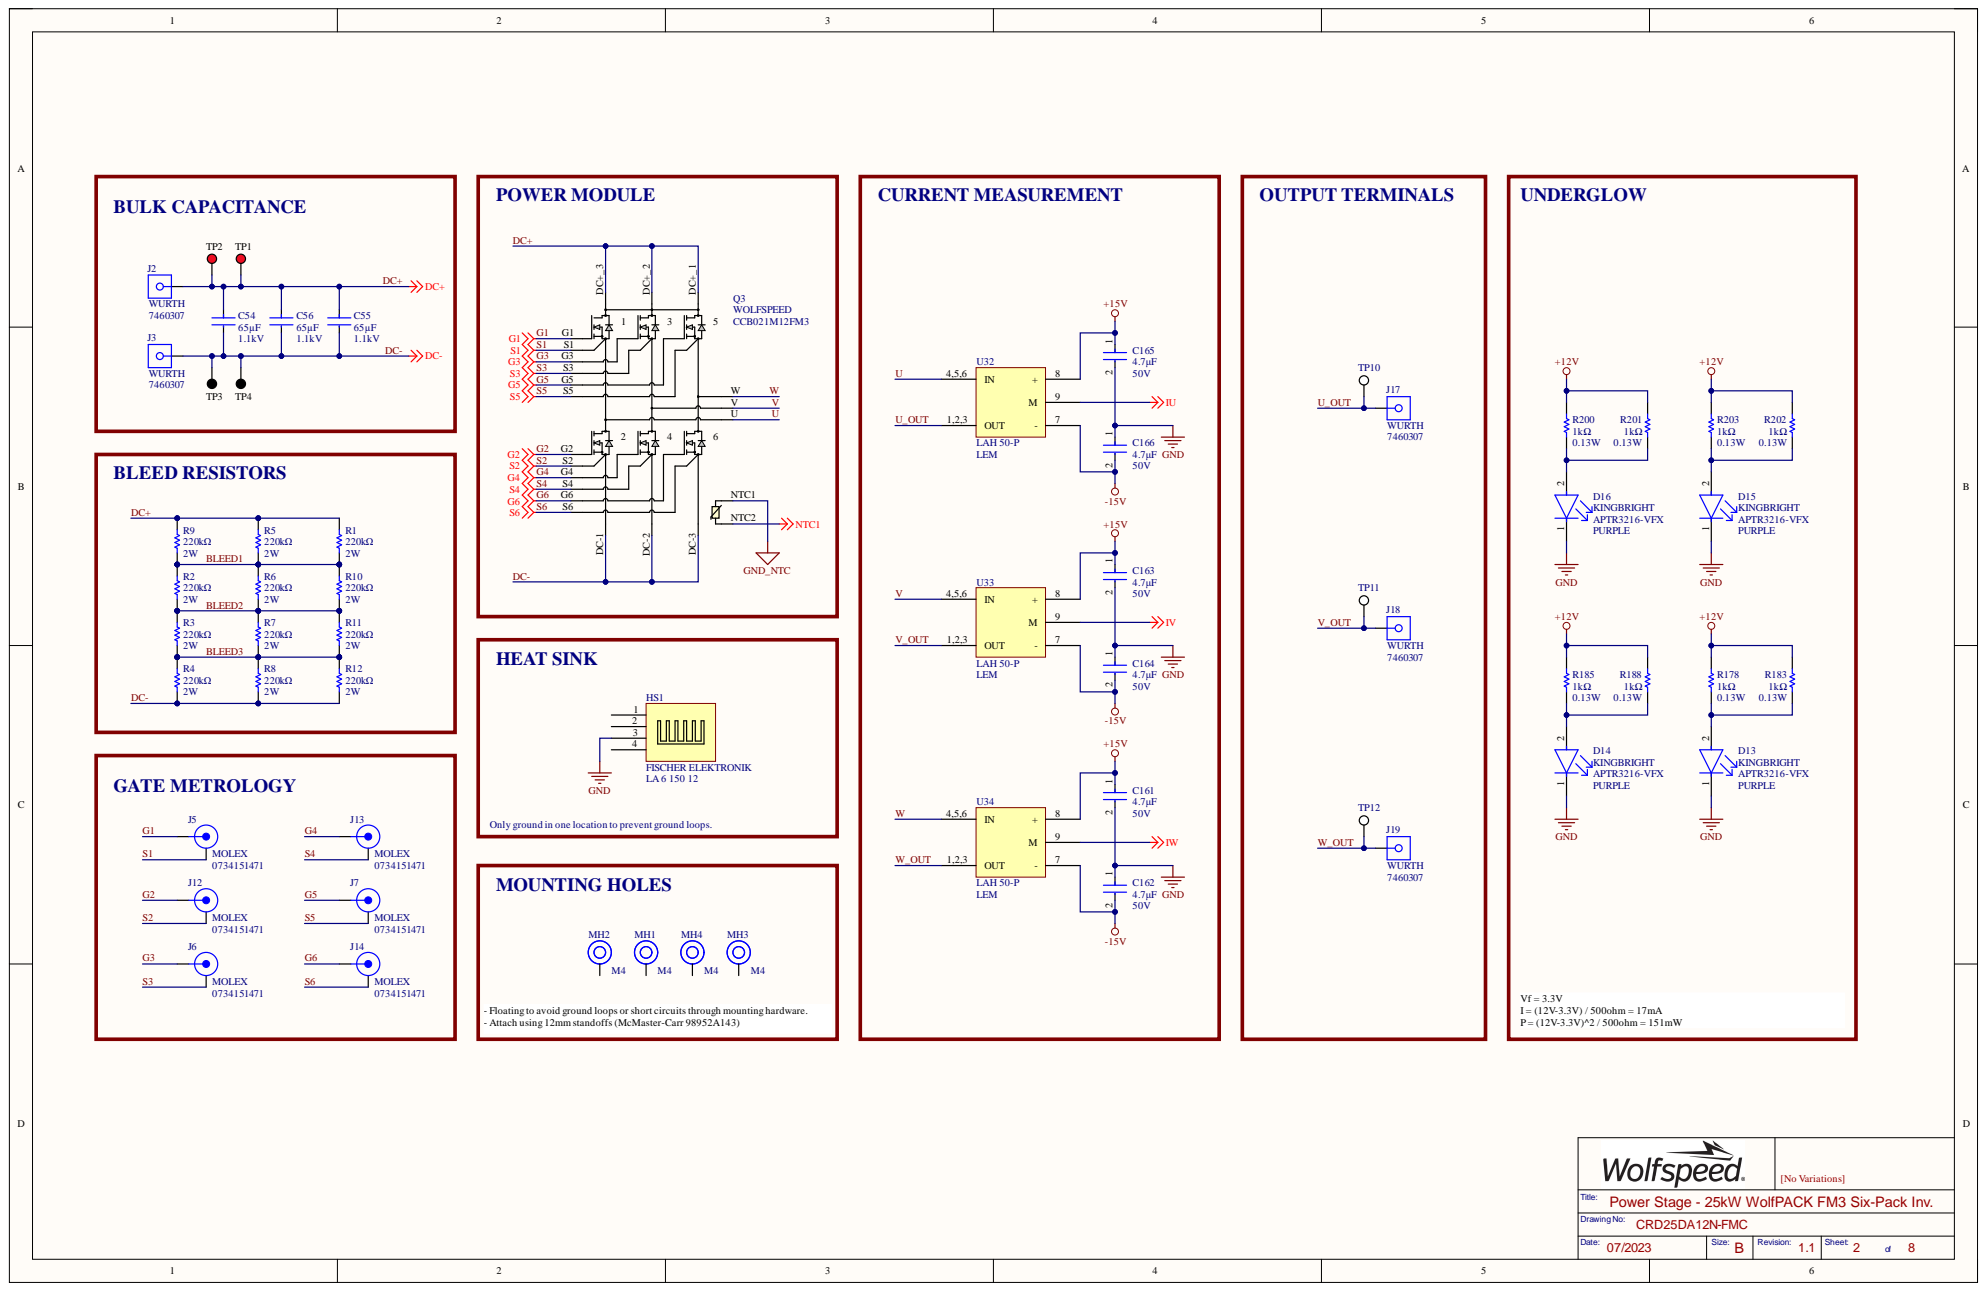
[picture p40: page 2]

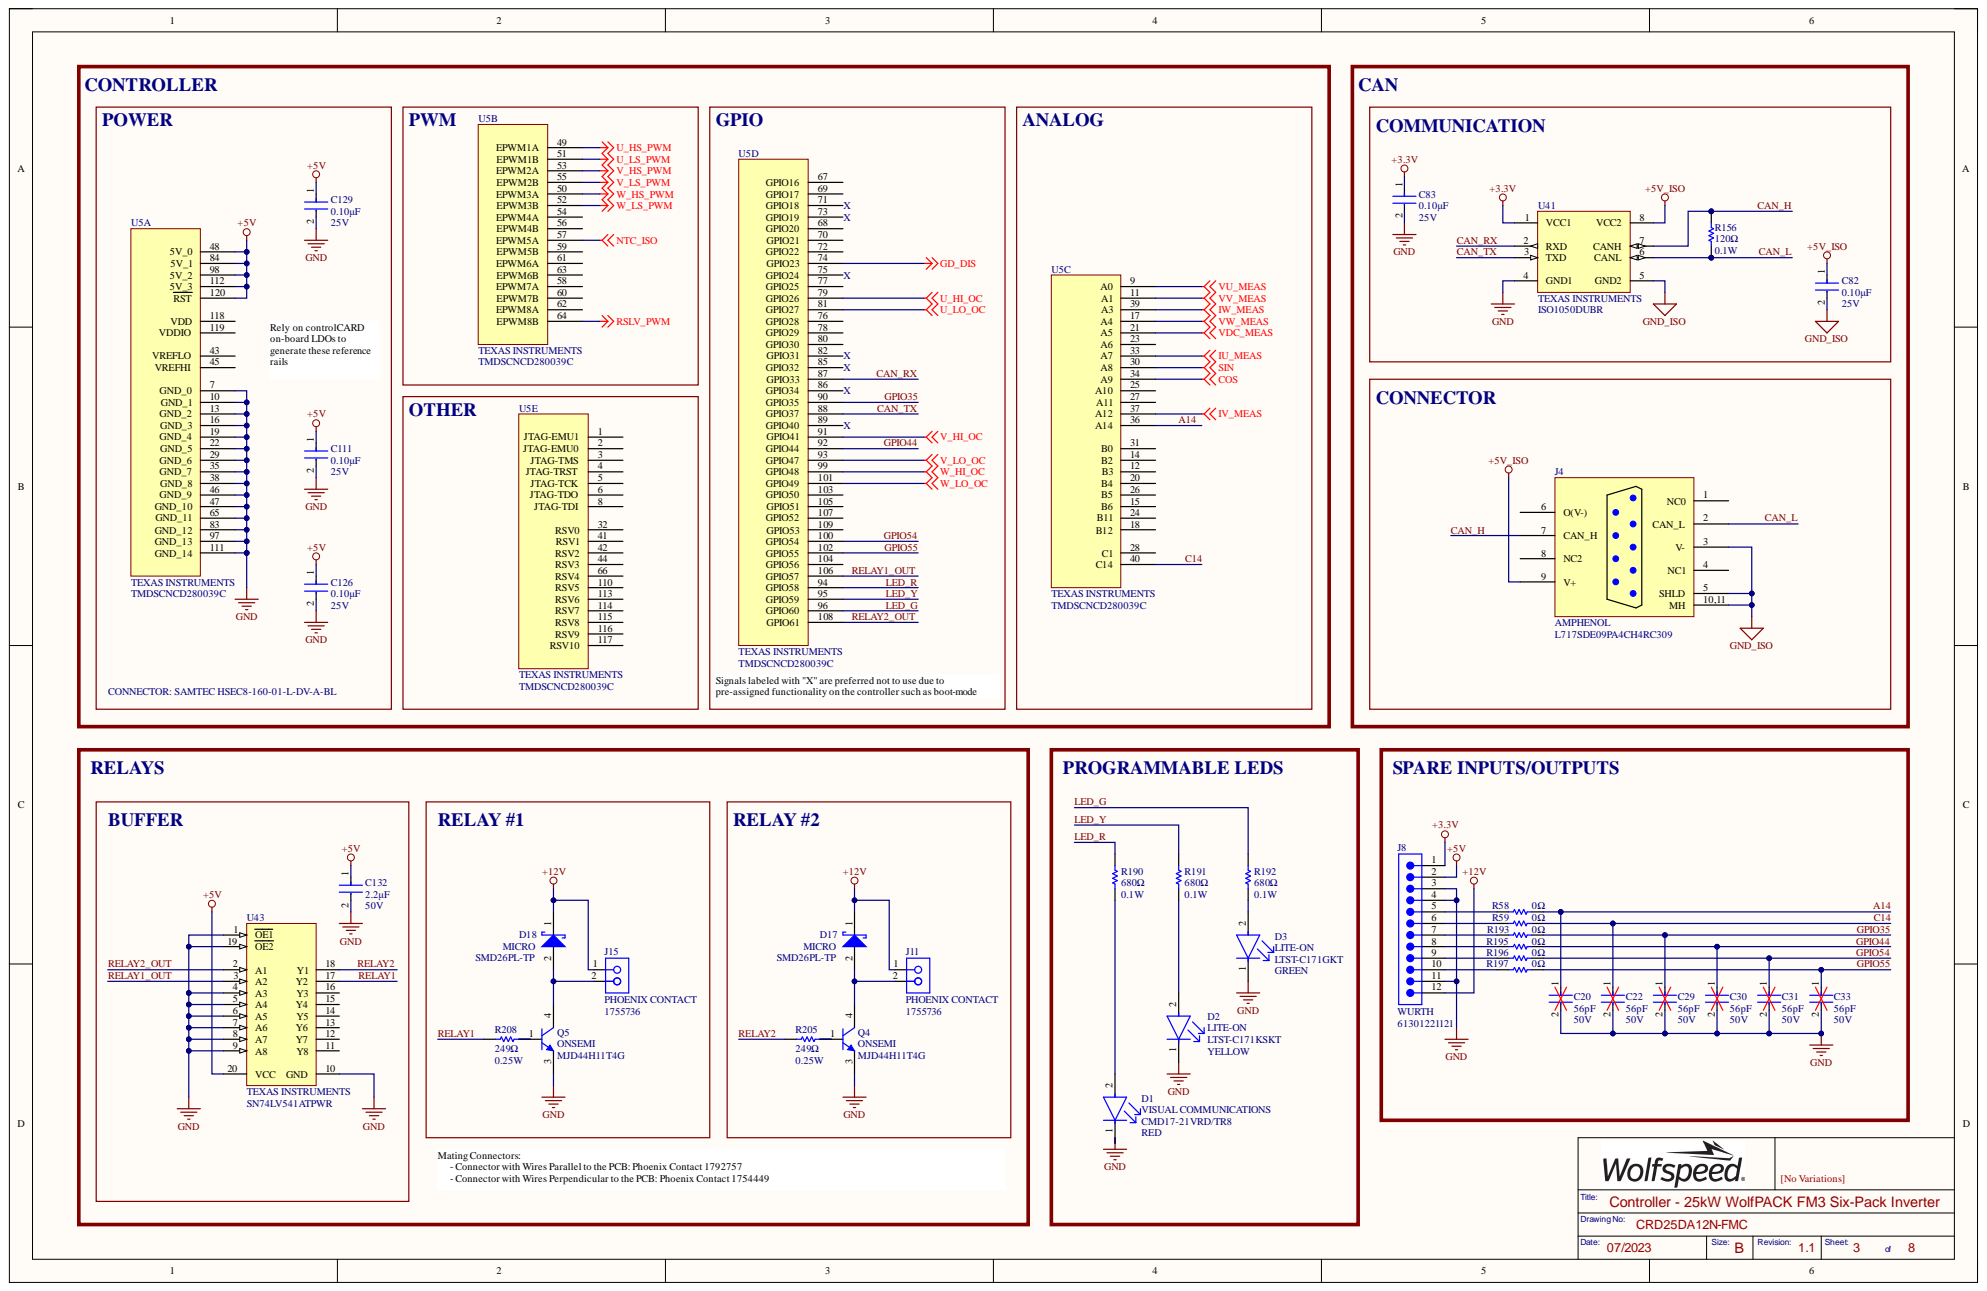
[picture p41: page 3]

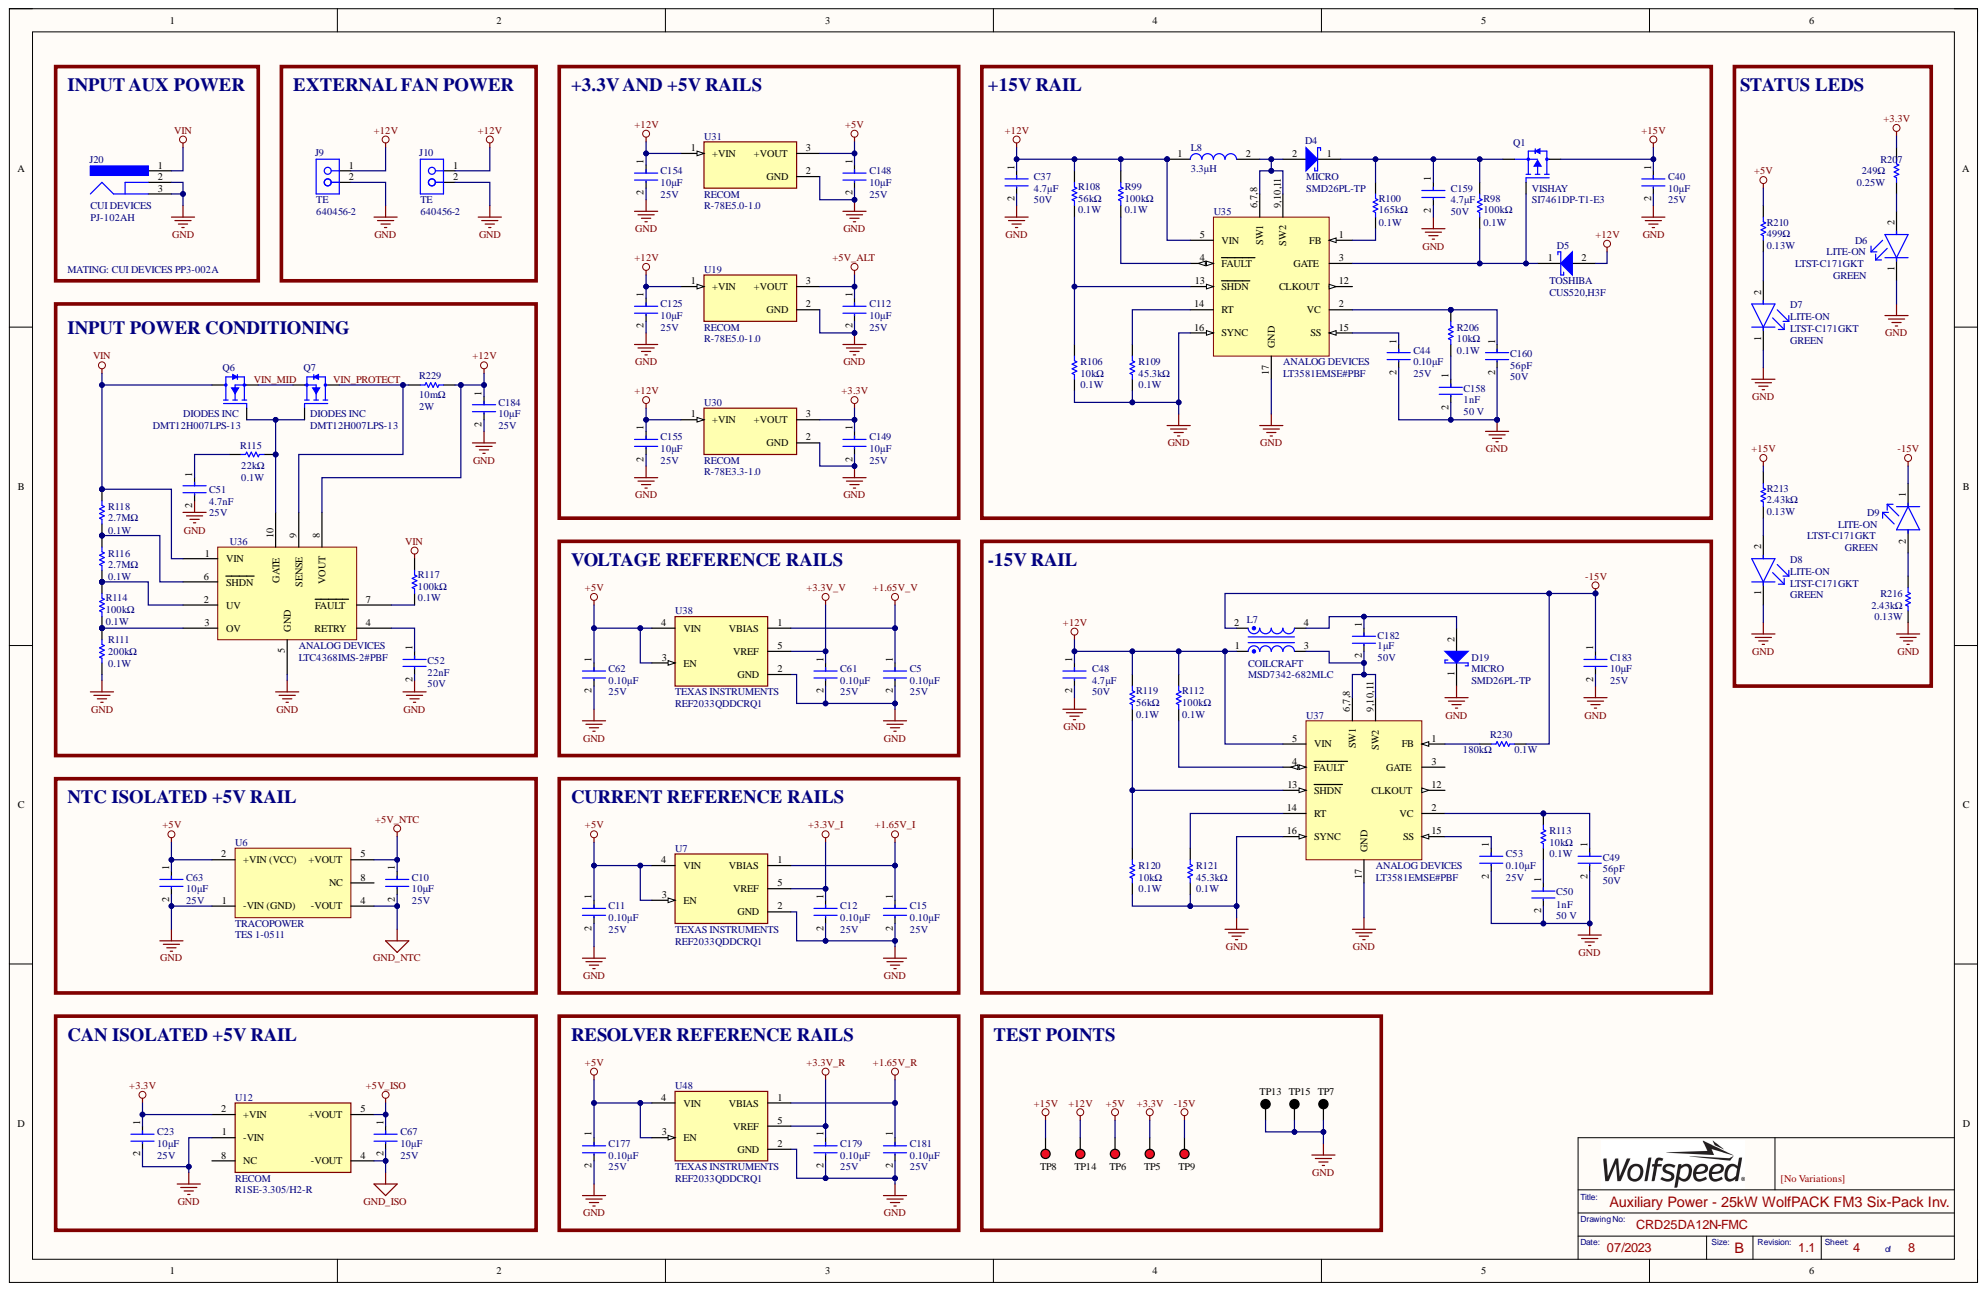
[picture p42: page 4]

R 1 1 4 | 2
1 0 0 k Ω | | 4

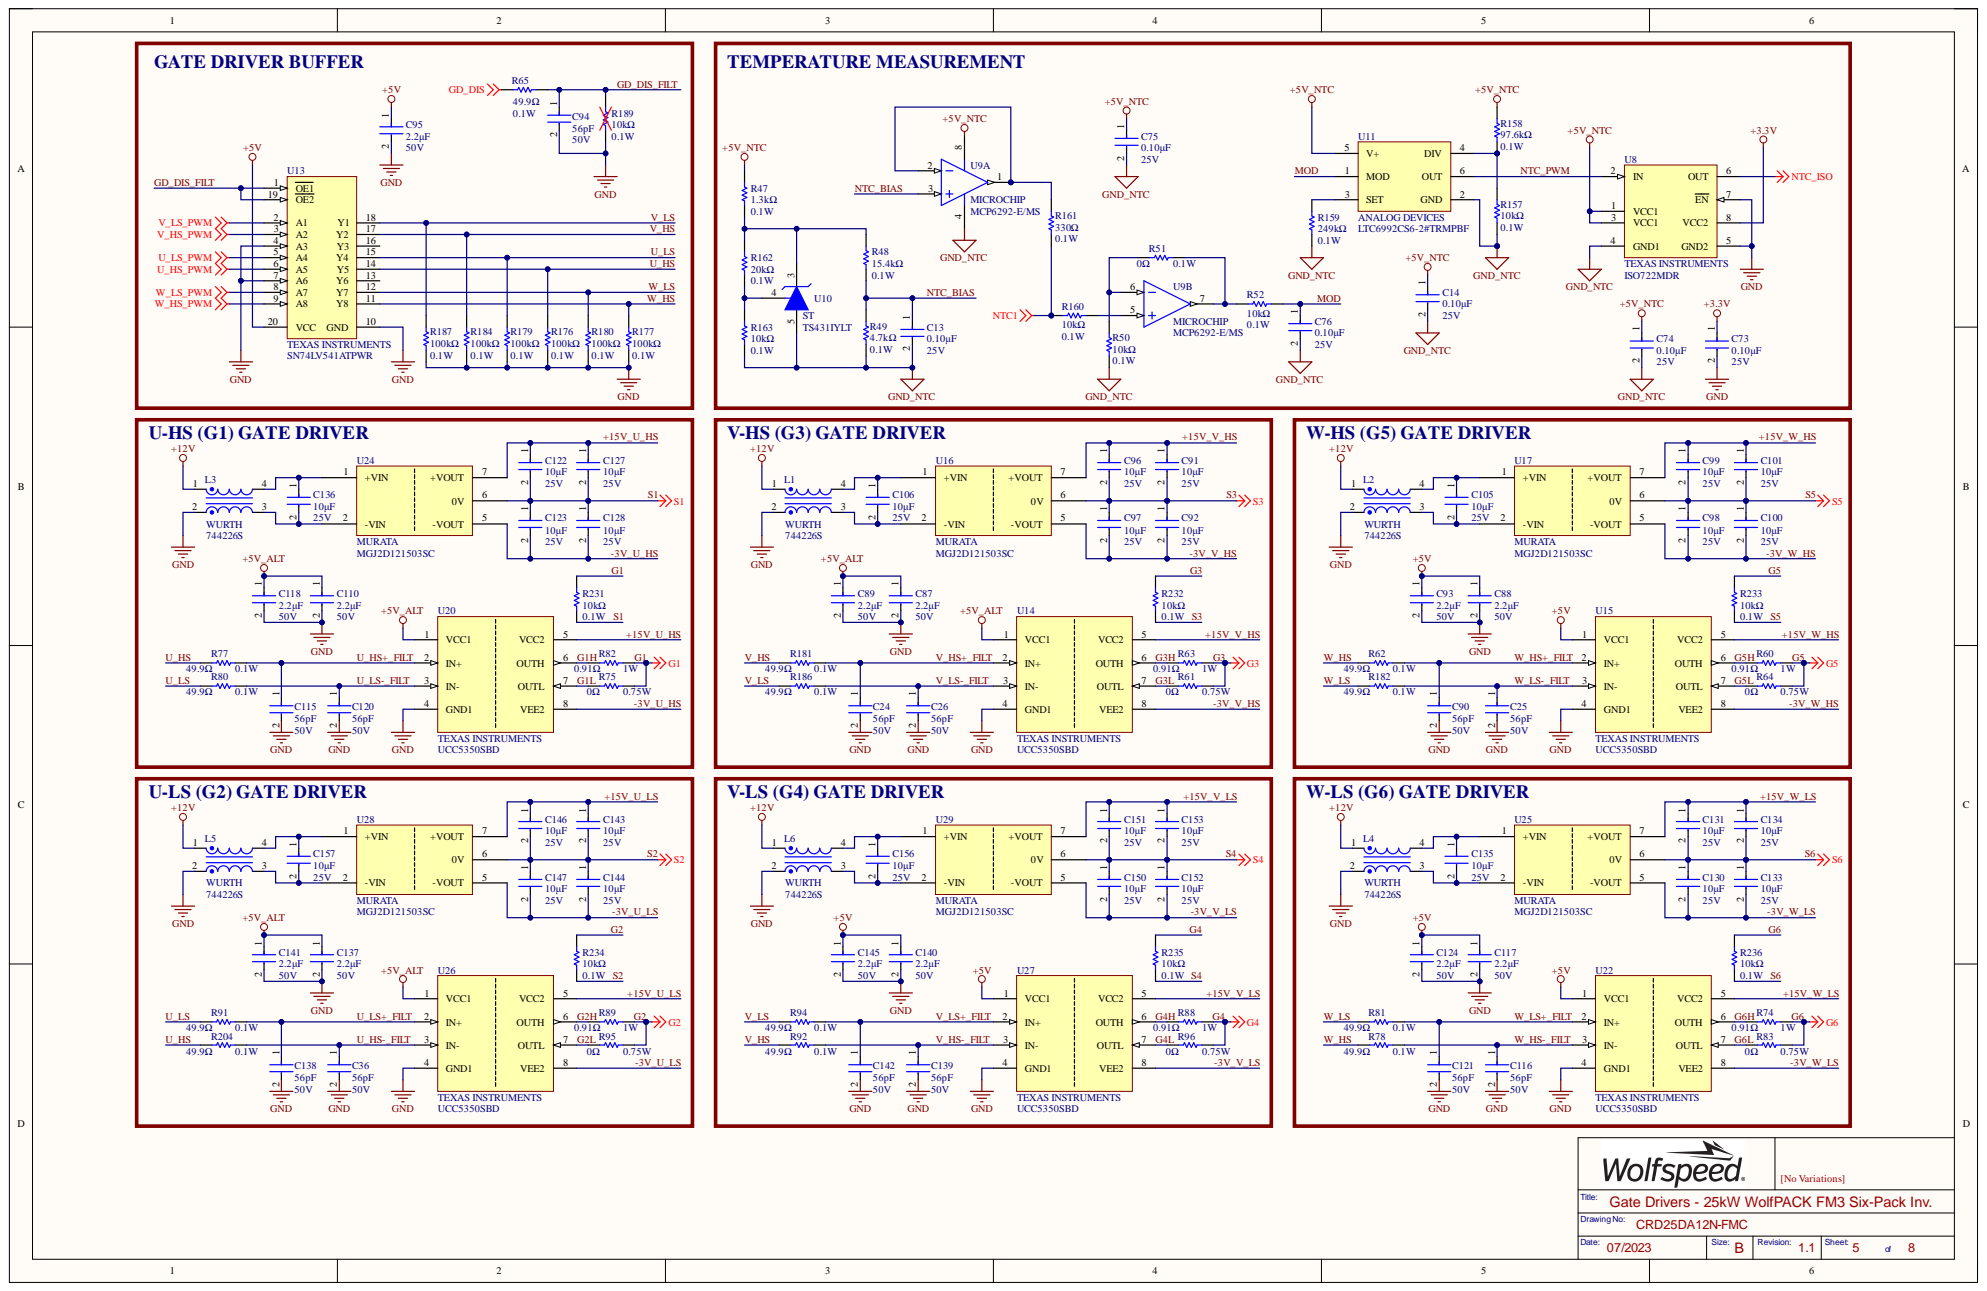
[picture p43: page 5]

Title:
Gate Drivers - 25kW WolfPACK FM3 Six-Pack Inv.

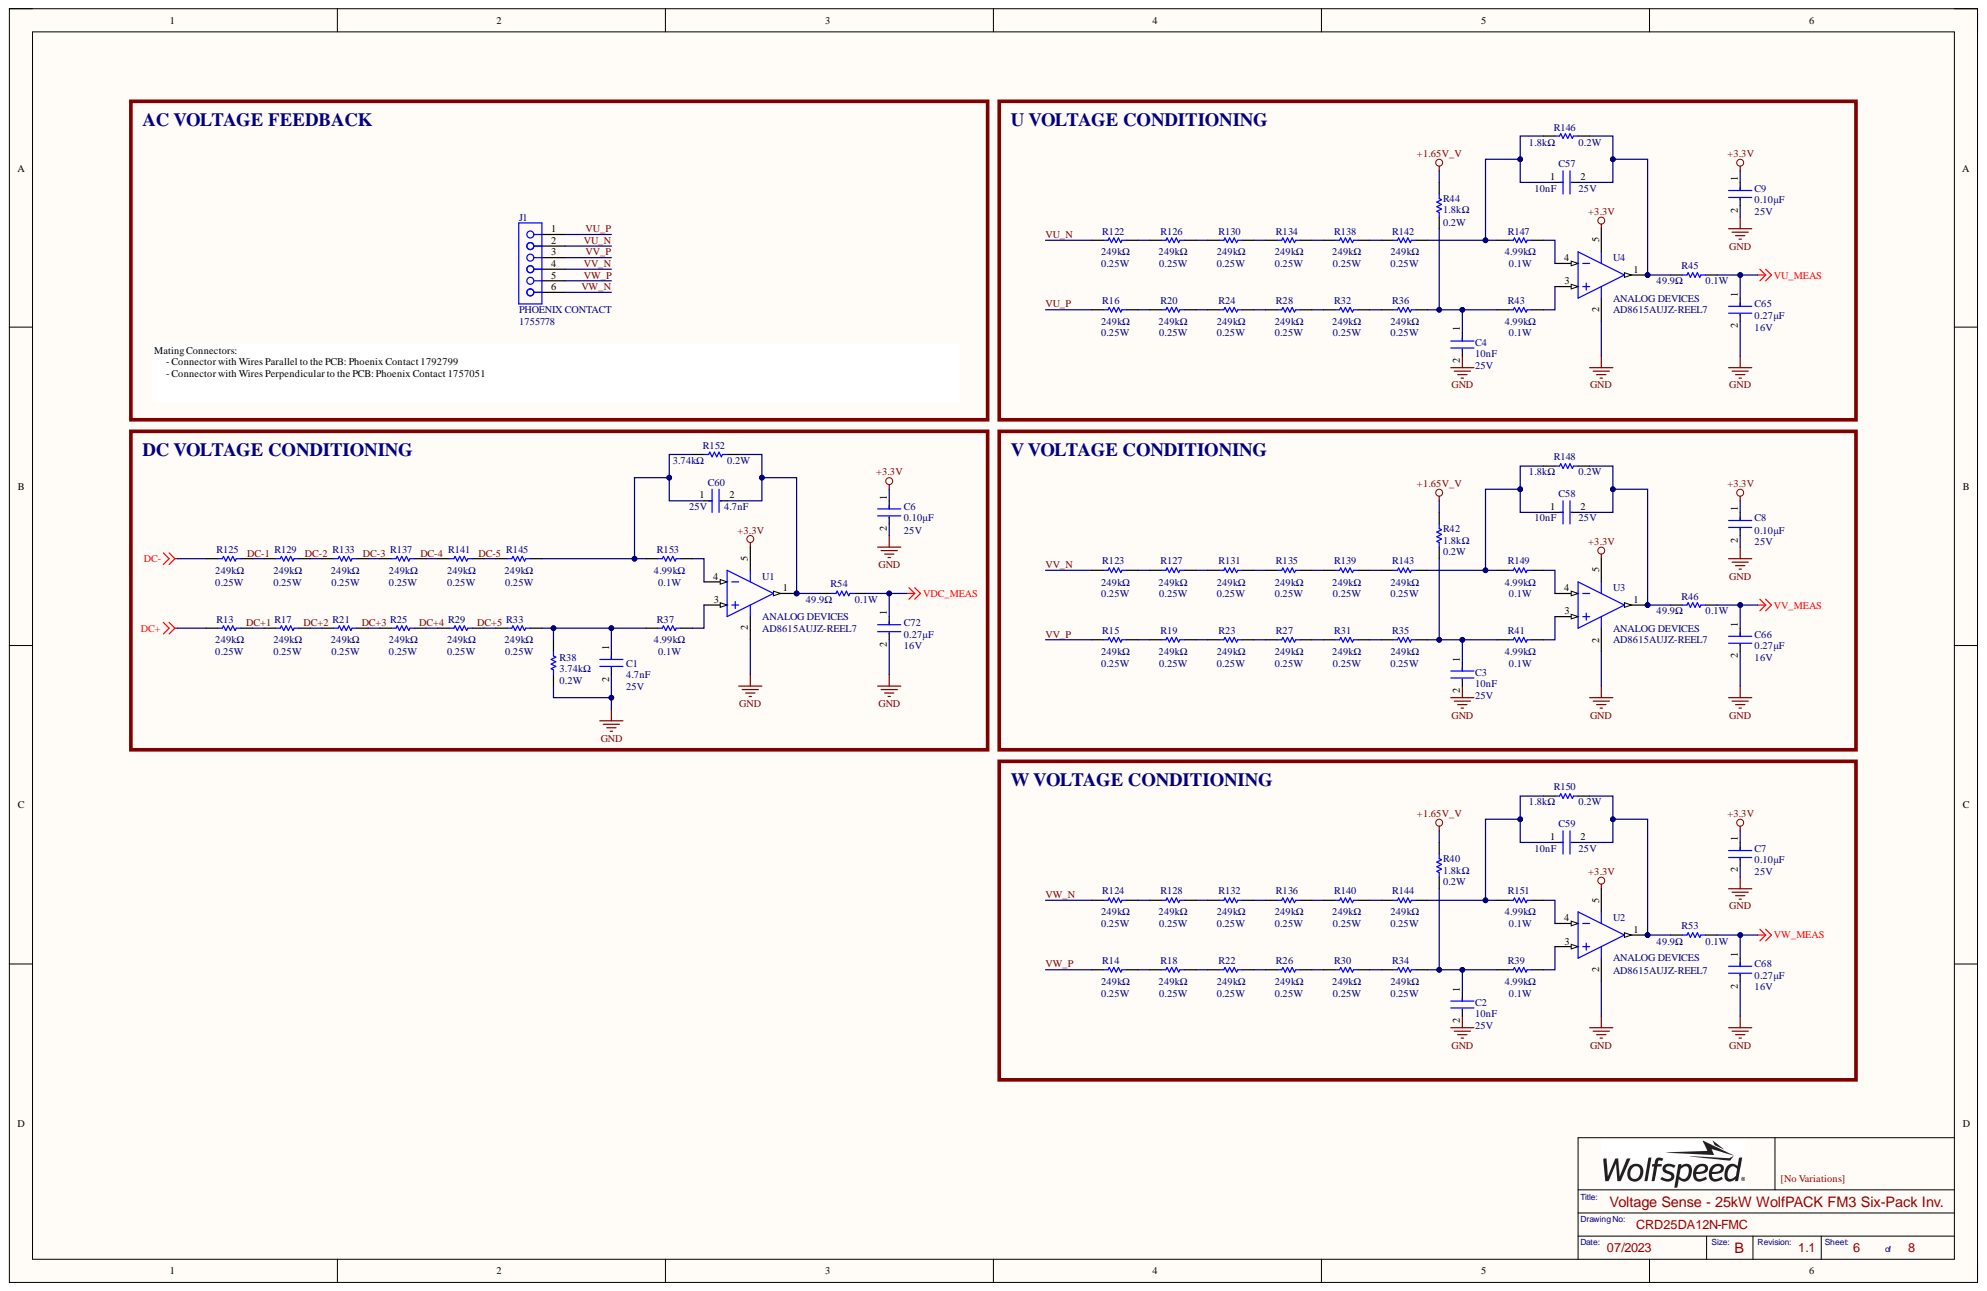
[picture p44: page 6]

MatingConnectors:
- Connector with Wires Parallel to the PCB: Phoenix Contact 1792799
- Connector with Wires Perpendicular to the PCB: Phoenix Contact 1757051

Title:
Voltage Sense - 25kW WolfPACK FM3 Six-Pack Inv.

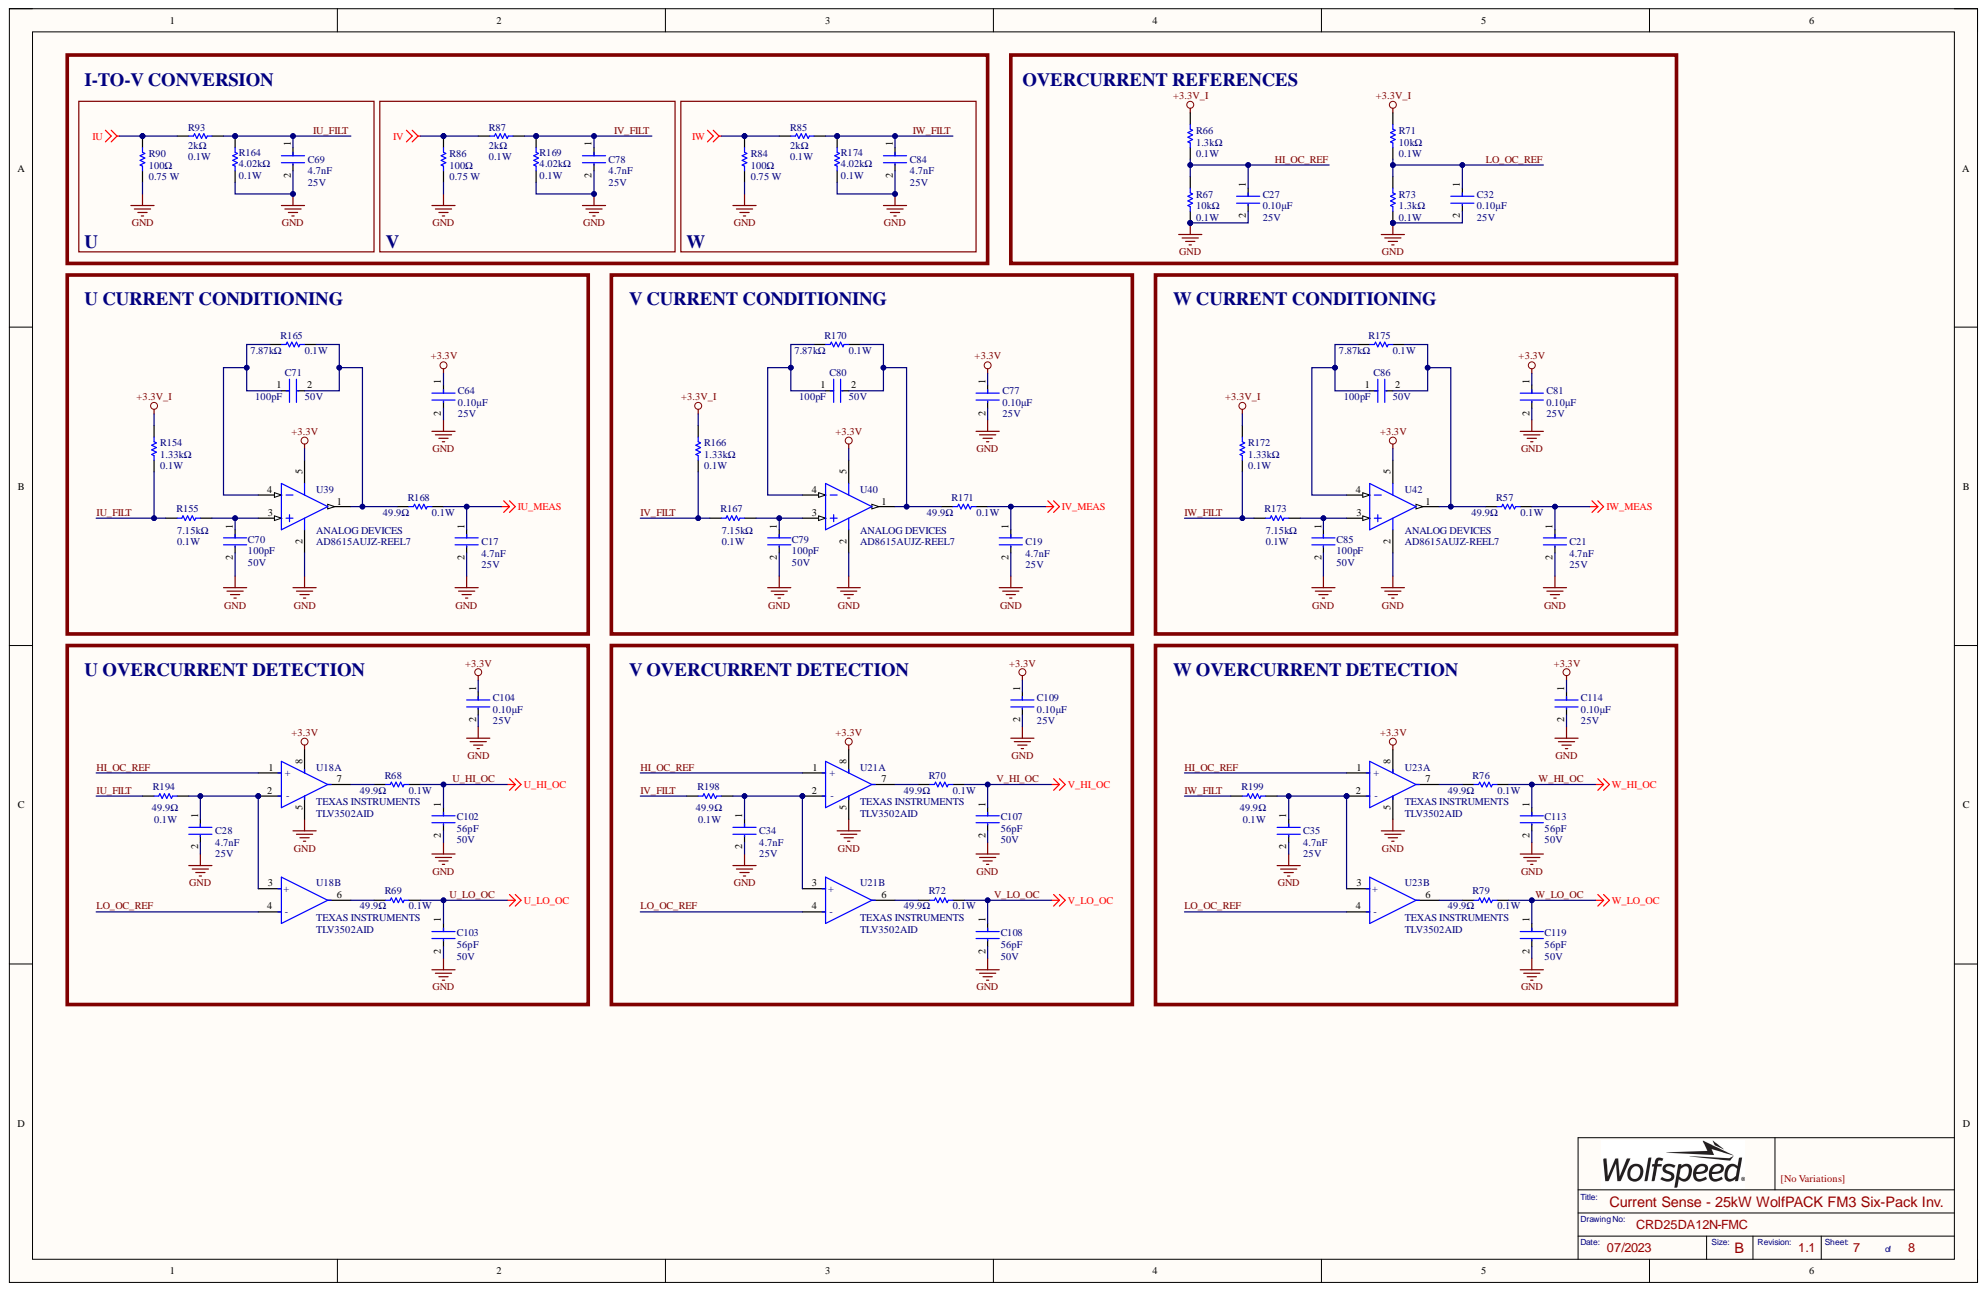
[picture p45: page 7]

Title:
Current Sense - 25kW WolfPACK FM3 Six-Pack Inv.

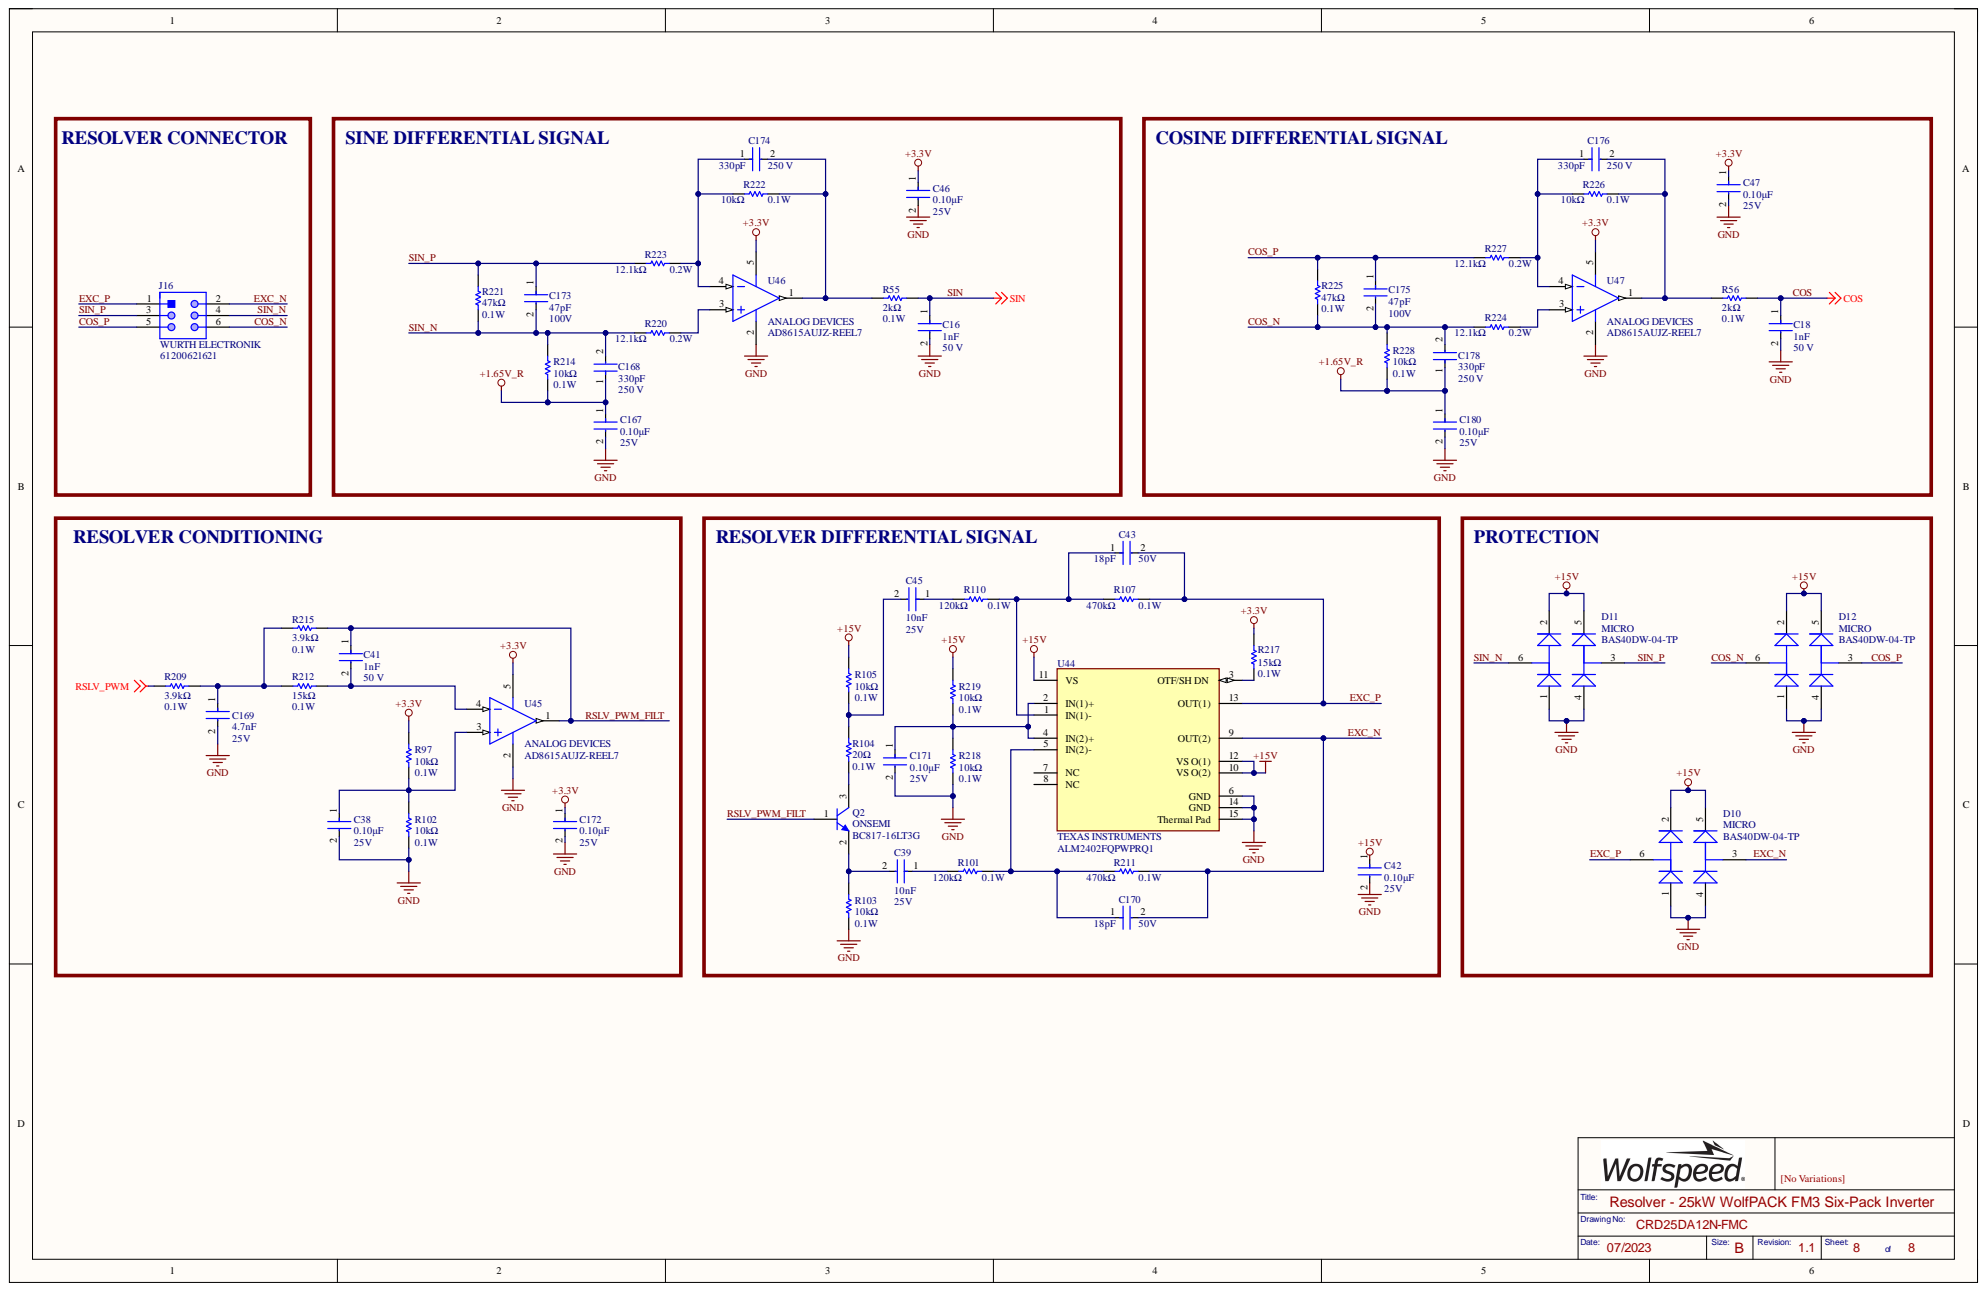
[picture p46: page 8]

IN(1)- 1 | EXC_N

Title:
Resolver - 25kW WolfPACK FM3 Six-Pack Inverter
