ultrazohm/uz_per_wolfspeed_25kw_fm3/Wolfspeed Inverter Files/CRD25DA12N-FMC_Schematic/CRD25DA12N-FMC V1.2 (01-2024) - Schematic.pdf

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
D | D
C | C
B | B
A | A

Title:

Date: | Revision:

Drawing No:

of Sheet: 01/2024 | 1.2 | 1 | 8

### CRD25DA12N-FMC

## 25kW WolfPACK FM3 Six-Pack Inverter

B Size:

[No Variations]

## BOARD SPECIFICATIONS

## - Dimensions: 8in by 8in, 0.093in thick, 2oz copper on all layers, ENIG, 6 layers

## PRESS-FIT NOTES

## - All other components should be 5mm from the center of the WolfPACK pins

- For the REDCUBE press-fit terminals, per the application notes, other components should be spaced at least 4mm away and the hole should be at least 3mm from the edge.

## GENERAL NOTES

- The +5V_ALT power rail is required to avoid routing the +5V rail across the DC-link copper pours on the PCB. Only route the +12V rail across the DC-link.

# Version History

V1.0 | 2023/04 | Initial release.
V1.1 | 2023/07
Version | Date | Description
V1.2 | 2024/01

Added 10kΩ to gate-source, made Rg easier to access, added thermal relief, switched to 1.65V regulators, fixed inverted regulator outputs

RELAY1 controlled by GPIO44; GPIO57 routed to spare pin connector; Updated spare connector pinout to reflect GPIO changes; Moved DC-DC converters from controller for easier insert/remove; Reduced mounting hole annular ring; Moved components hidden by heat sink to topside; Silkscreen & copper pour clean up; Added option to float heatsink; Fixed resolver excitation circuit; Design rule improvements; Removed thermal relief from press-fit pins since no soldering; Improved pin notations in footprint silkscreens; Switched +/-15V regulation circuit to LM5157QRTERQ1; Added top

## layer copper islands to DC+/- terminals of module for improved thermals

Reduced number of unique BOM items by changing the following: 1) LED resistors, 2) input power conditioning resistors & RETRY capacitor, 3)

## NTC isolated supply

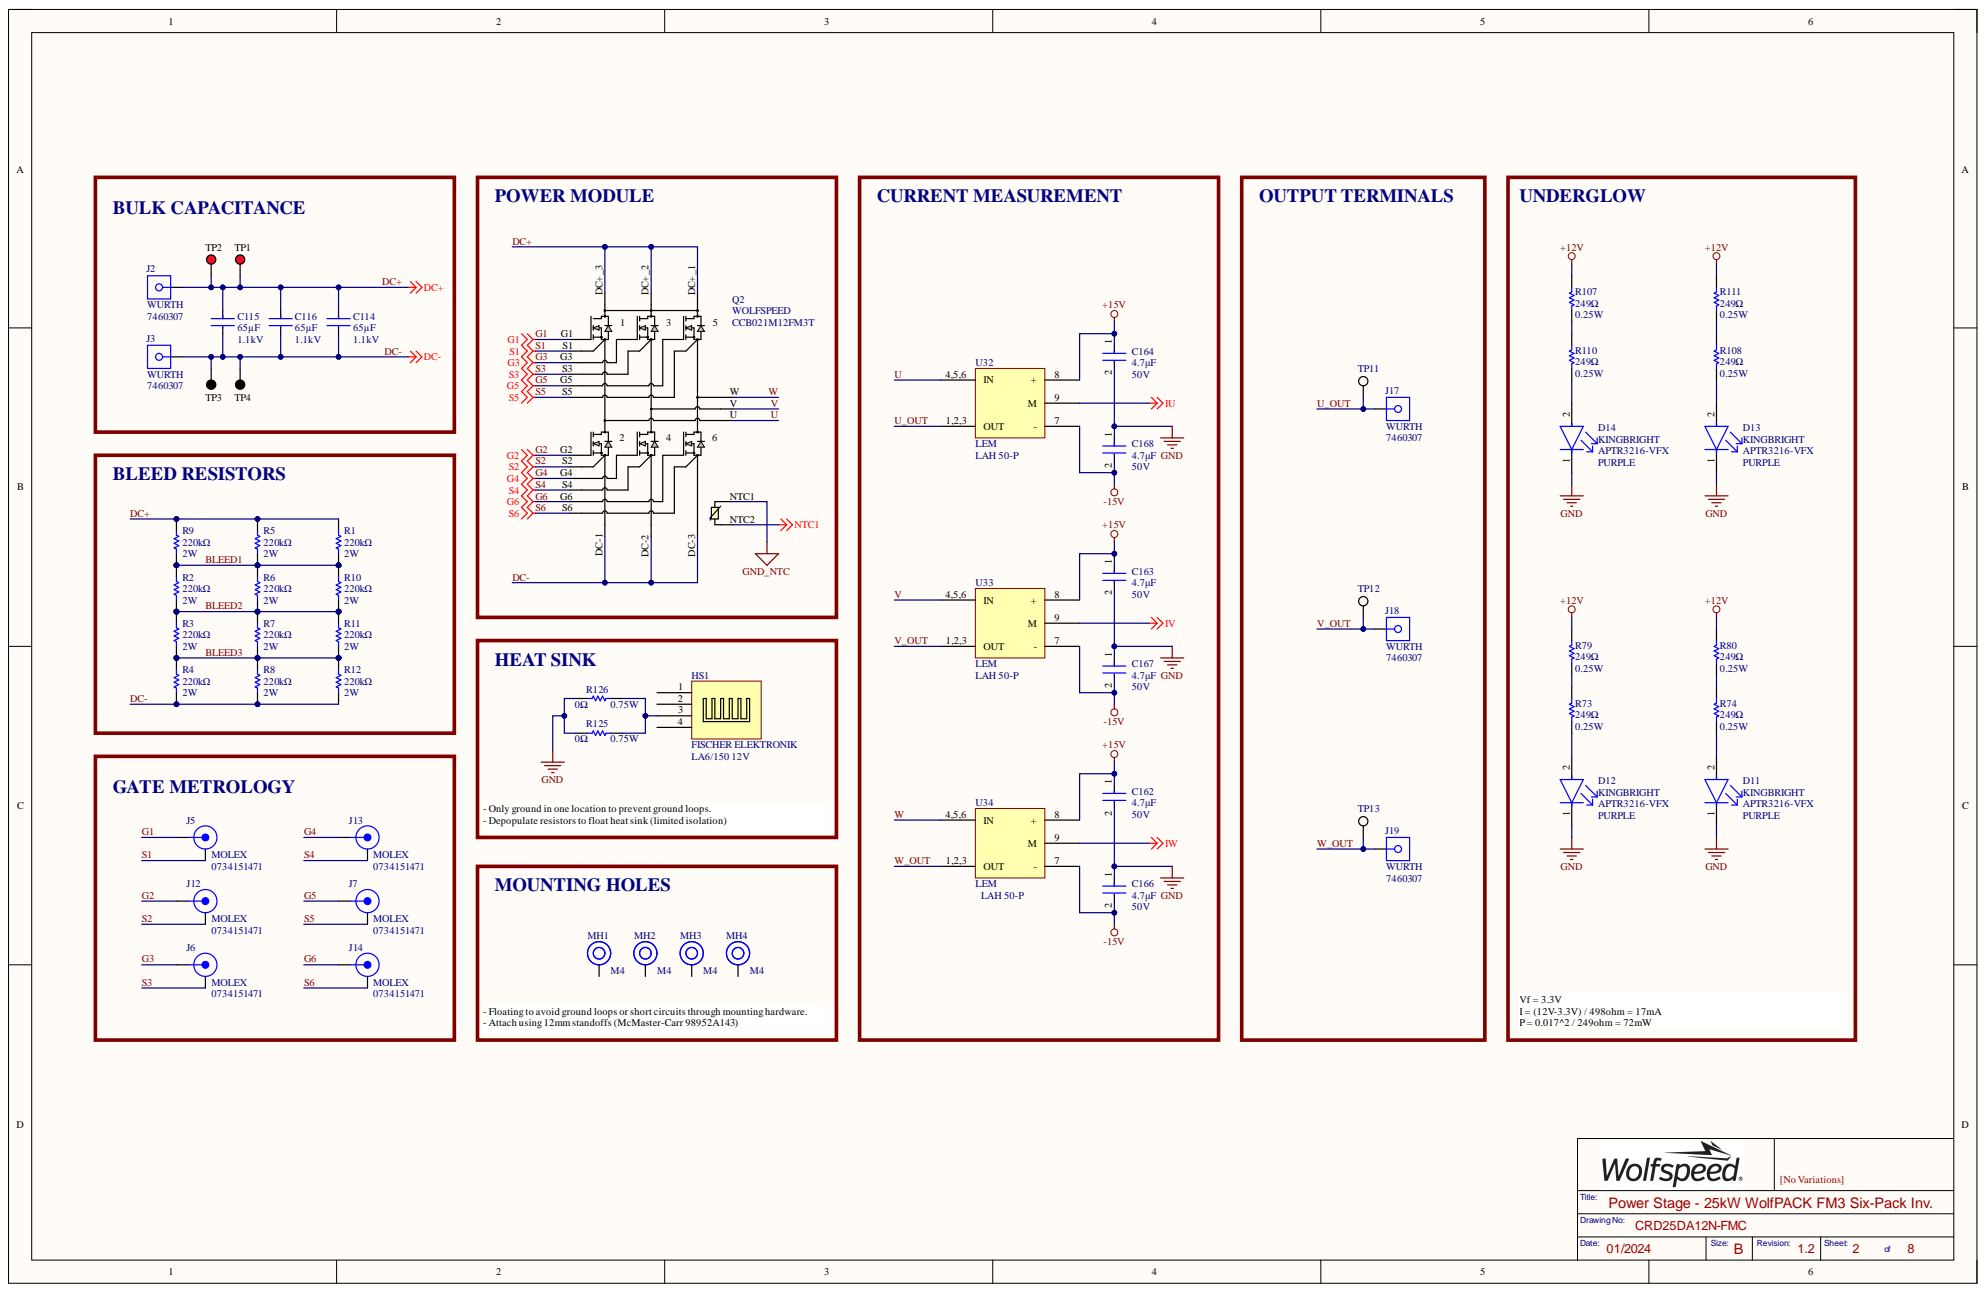
[picture p47: page 2]

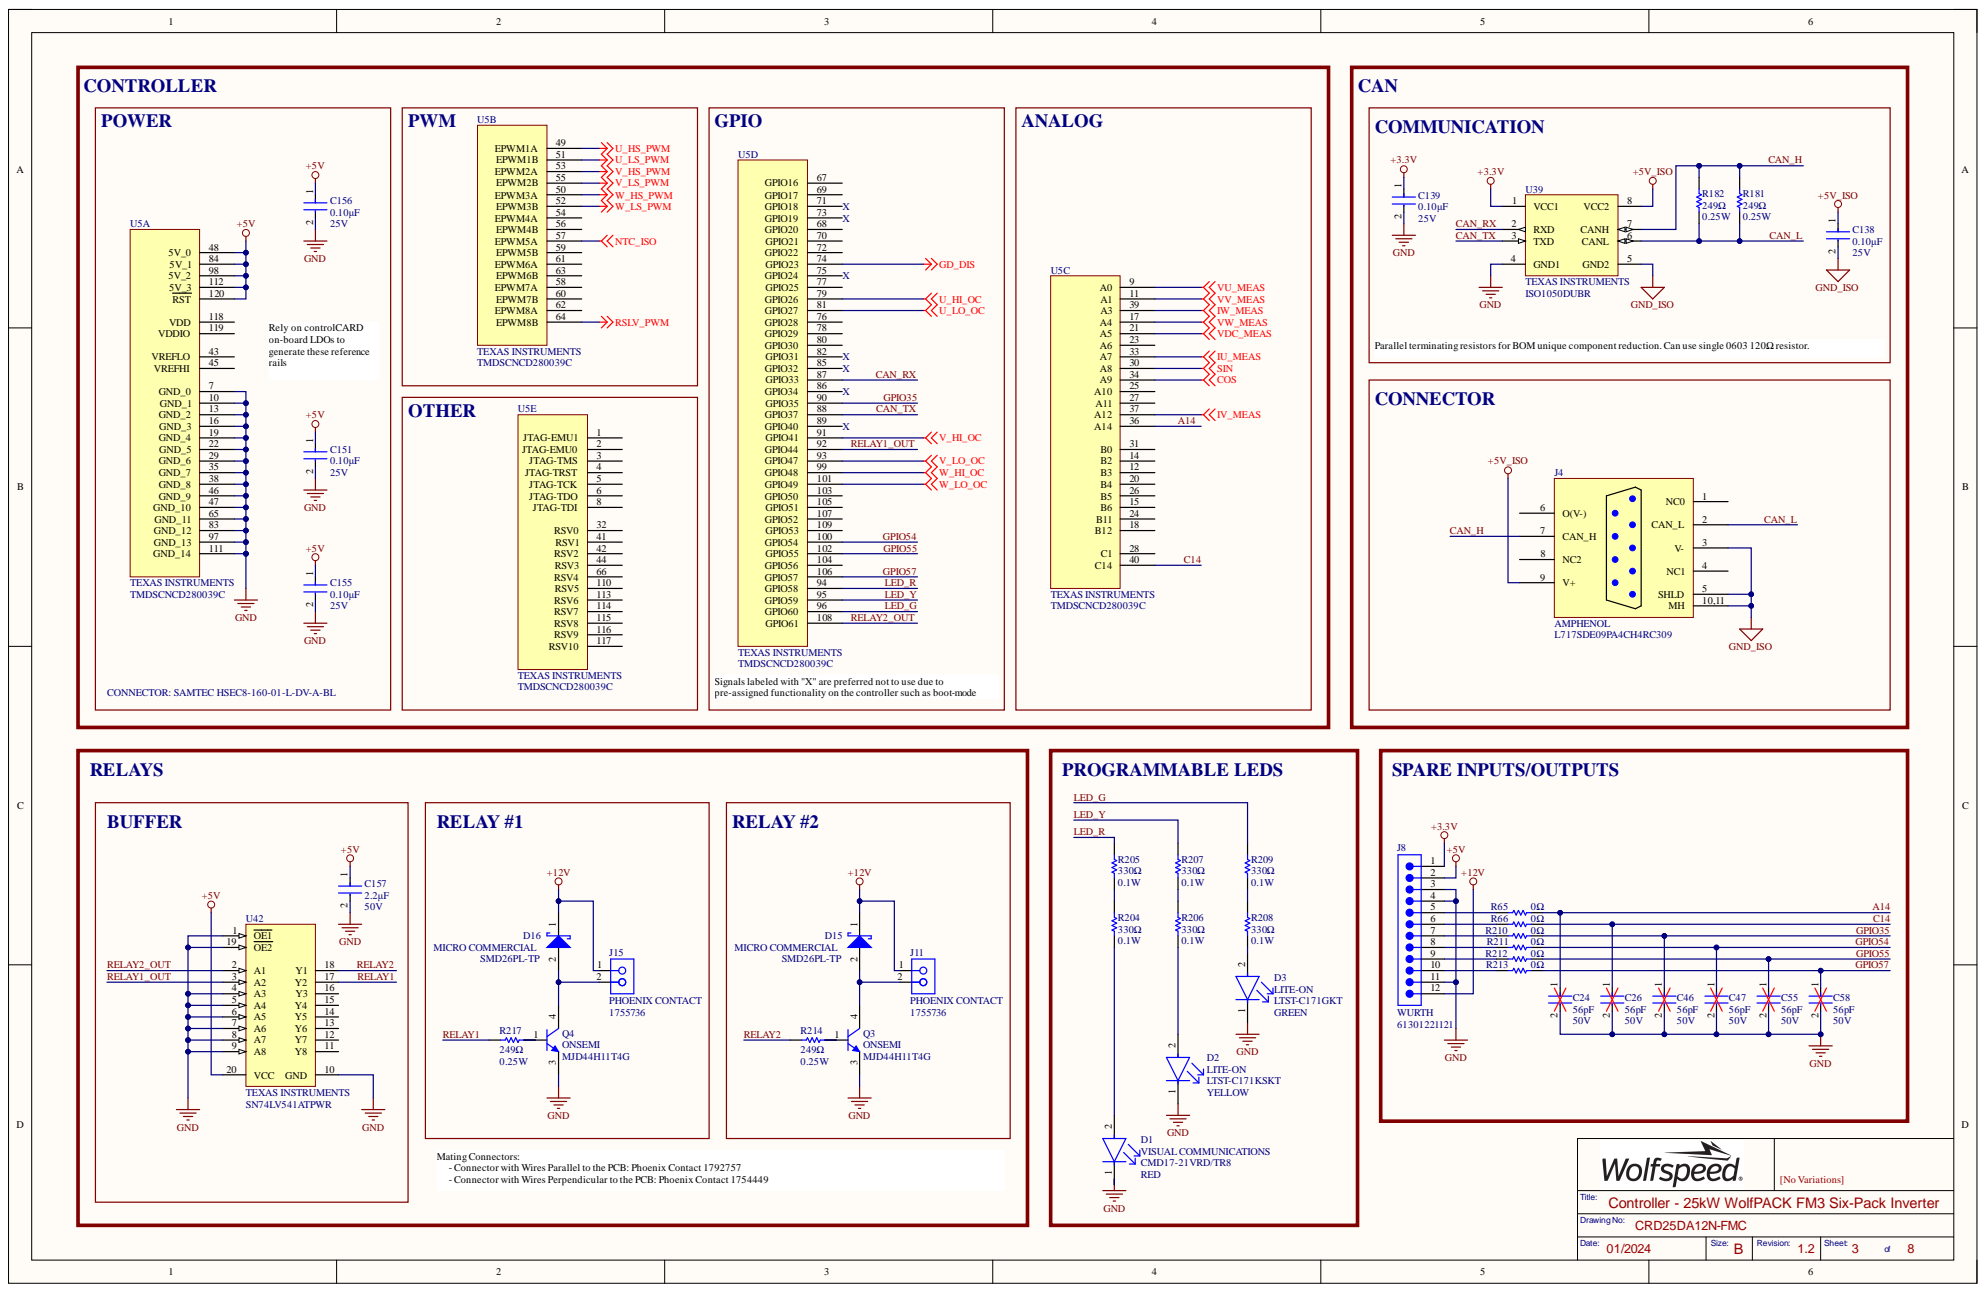
[picture p48: page 3]

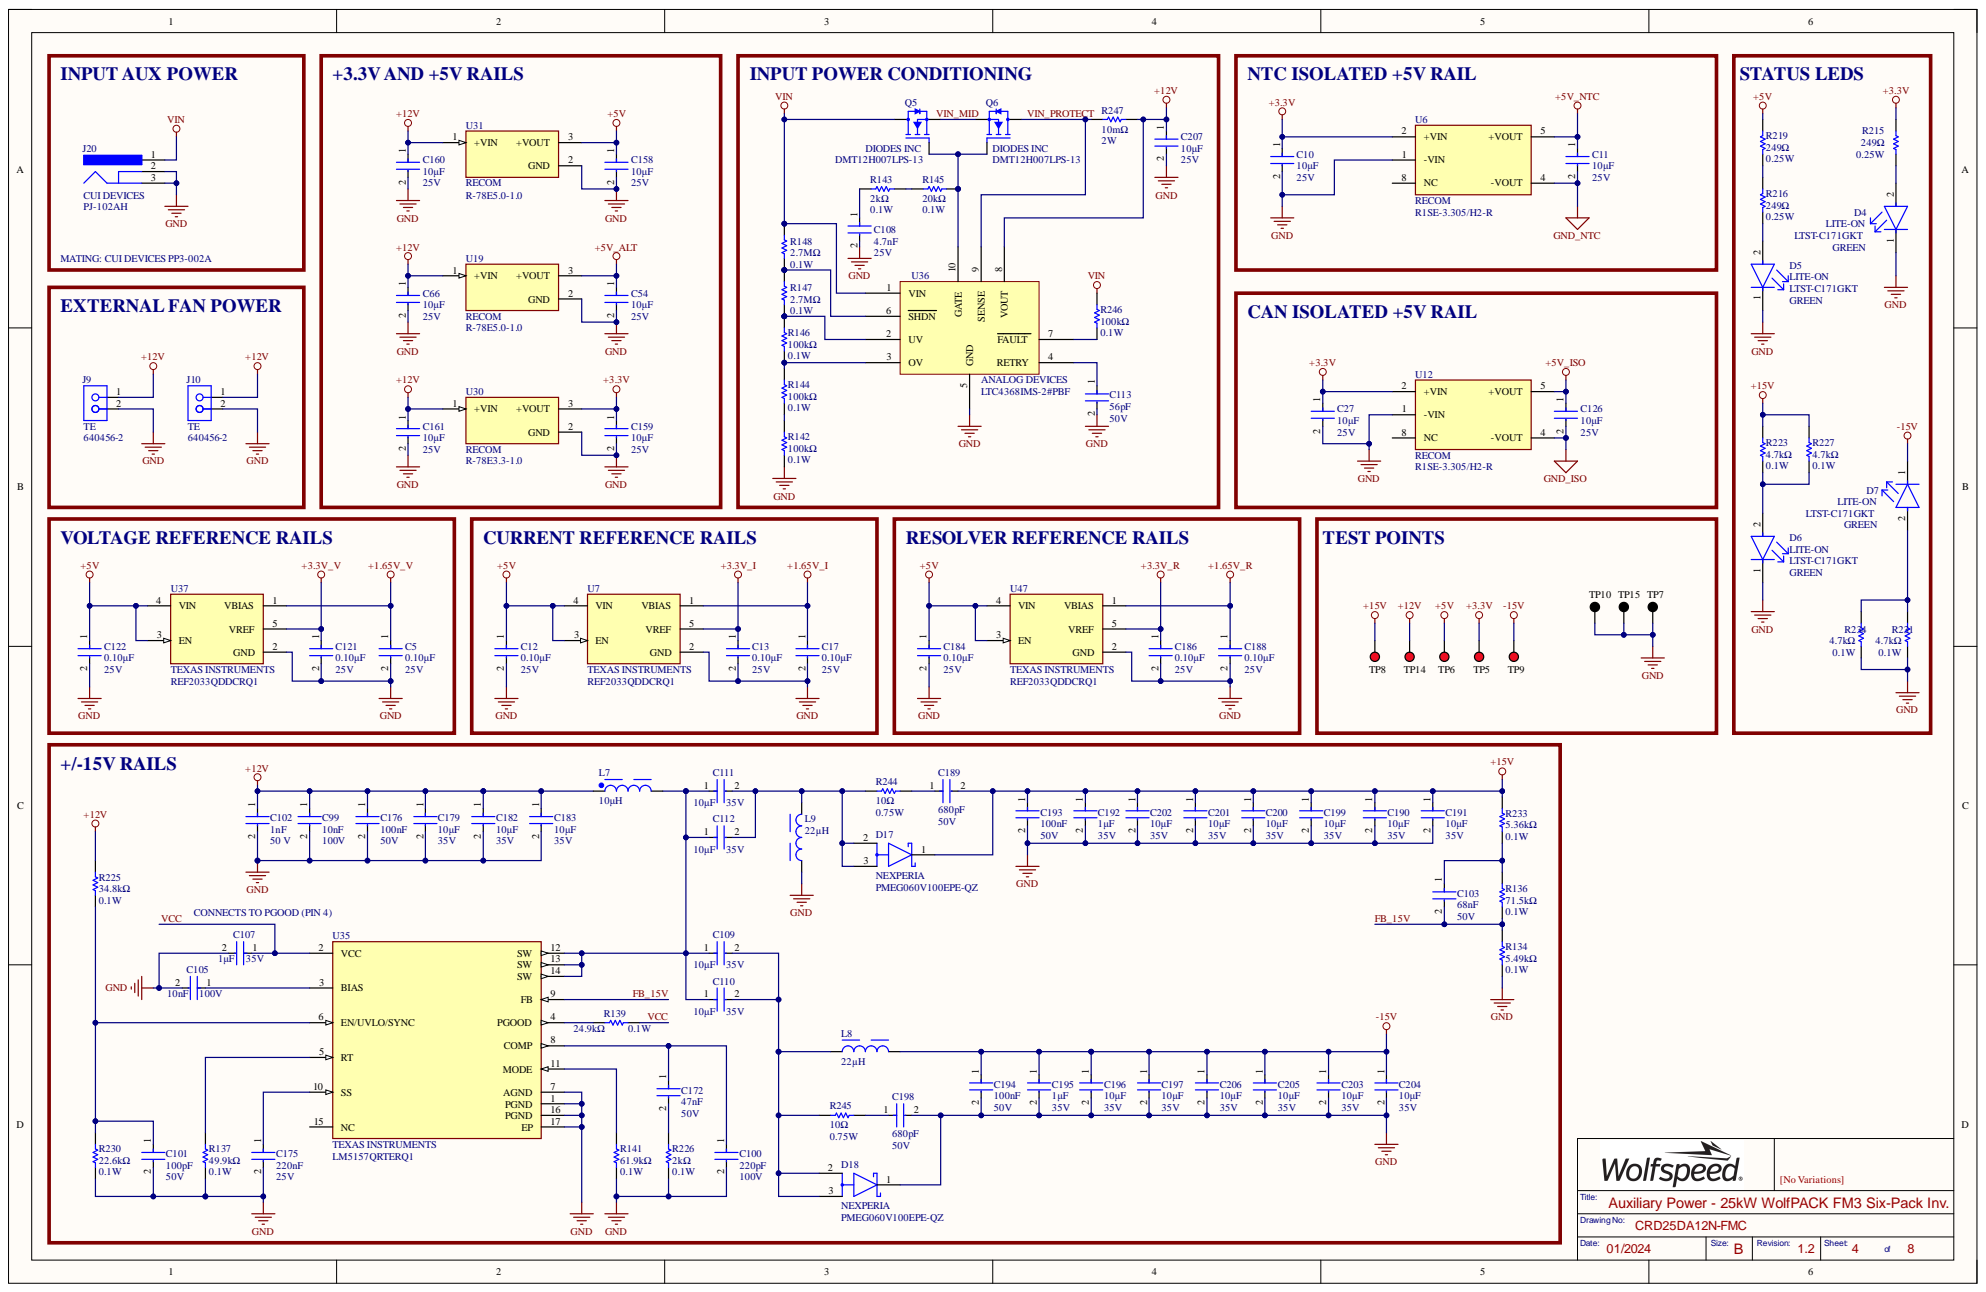
[picture p49: page 4]

CONNECTS TO PGOOD (PIN 4)

Title:
Auxiliary Power - 25kW WolfPACK FM3 Six-Pack Inv.

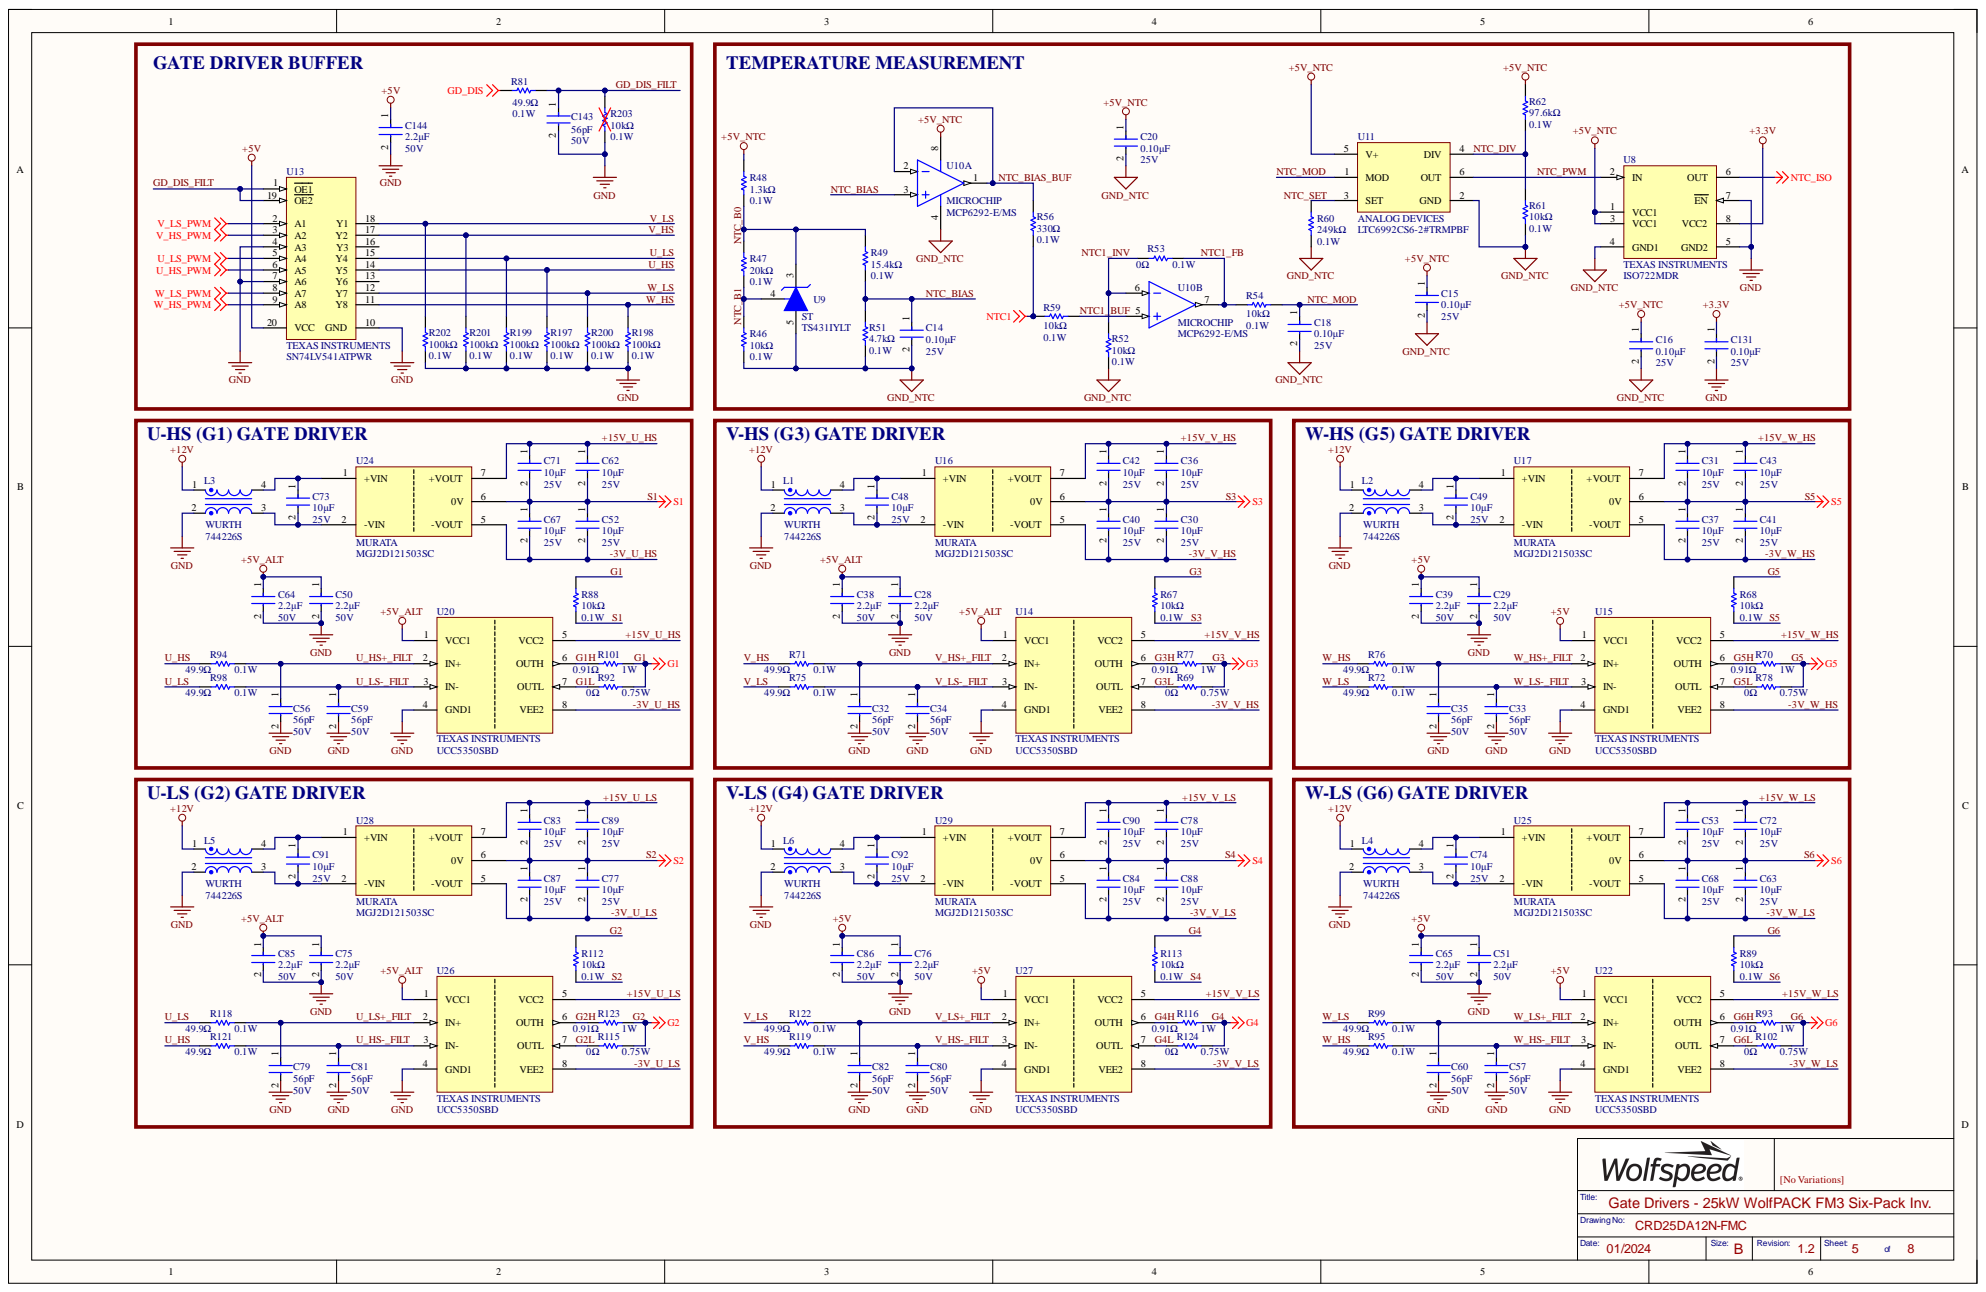
[picture p50: page 5]

+5V_NTC

A7 8 A8 9 VCC 20

Title:
Gate Drivers - 25kW WolfPACK FM3 Six-Pack Inv.

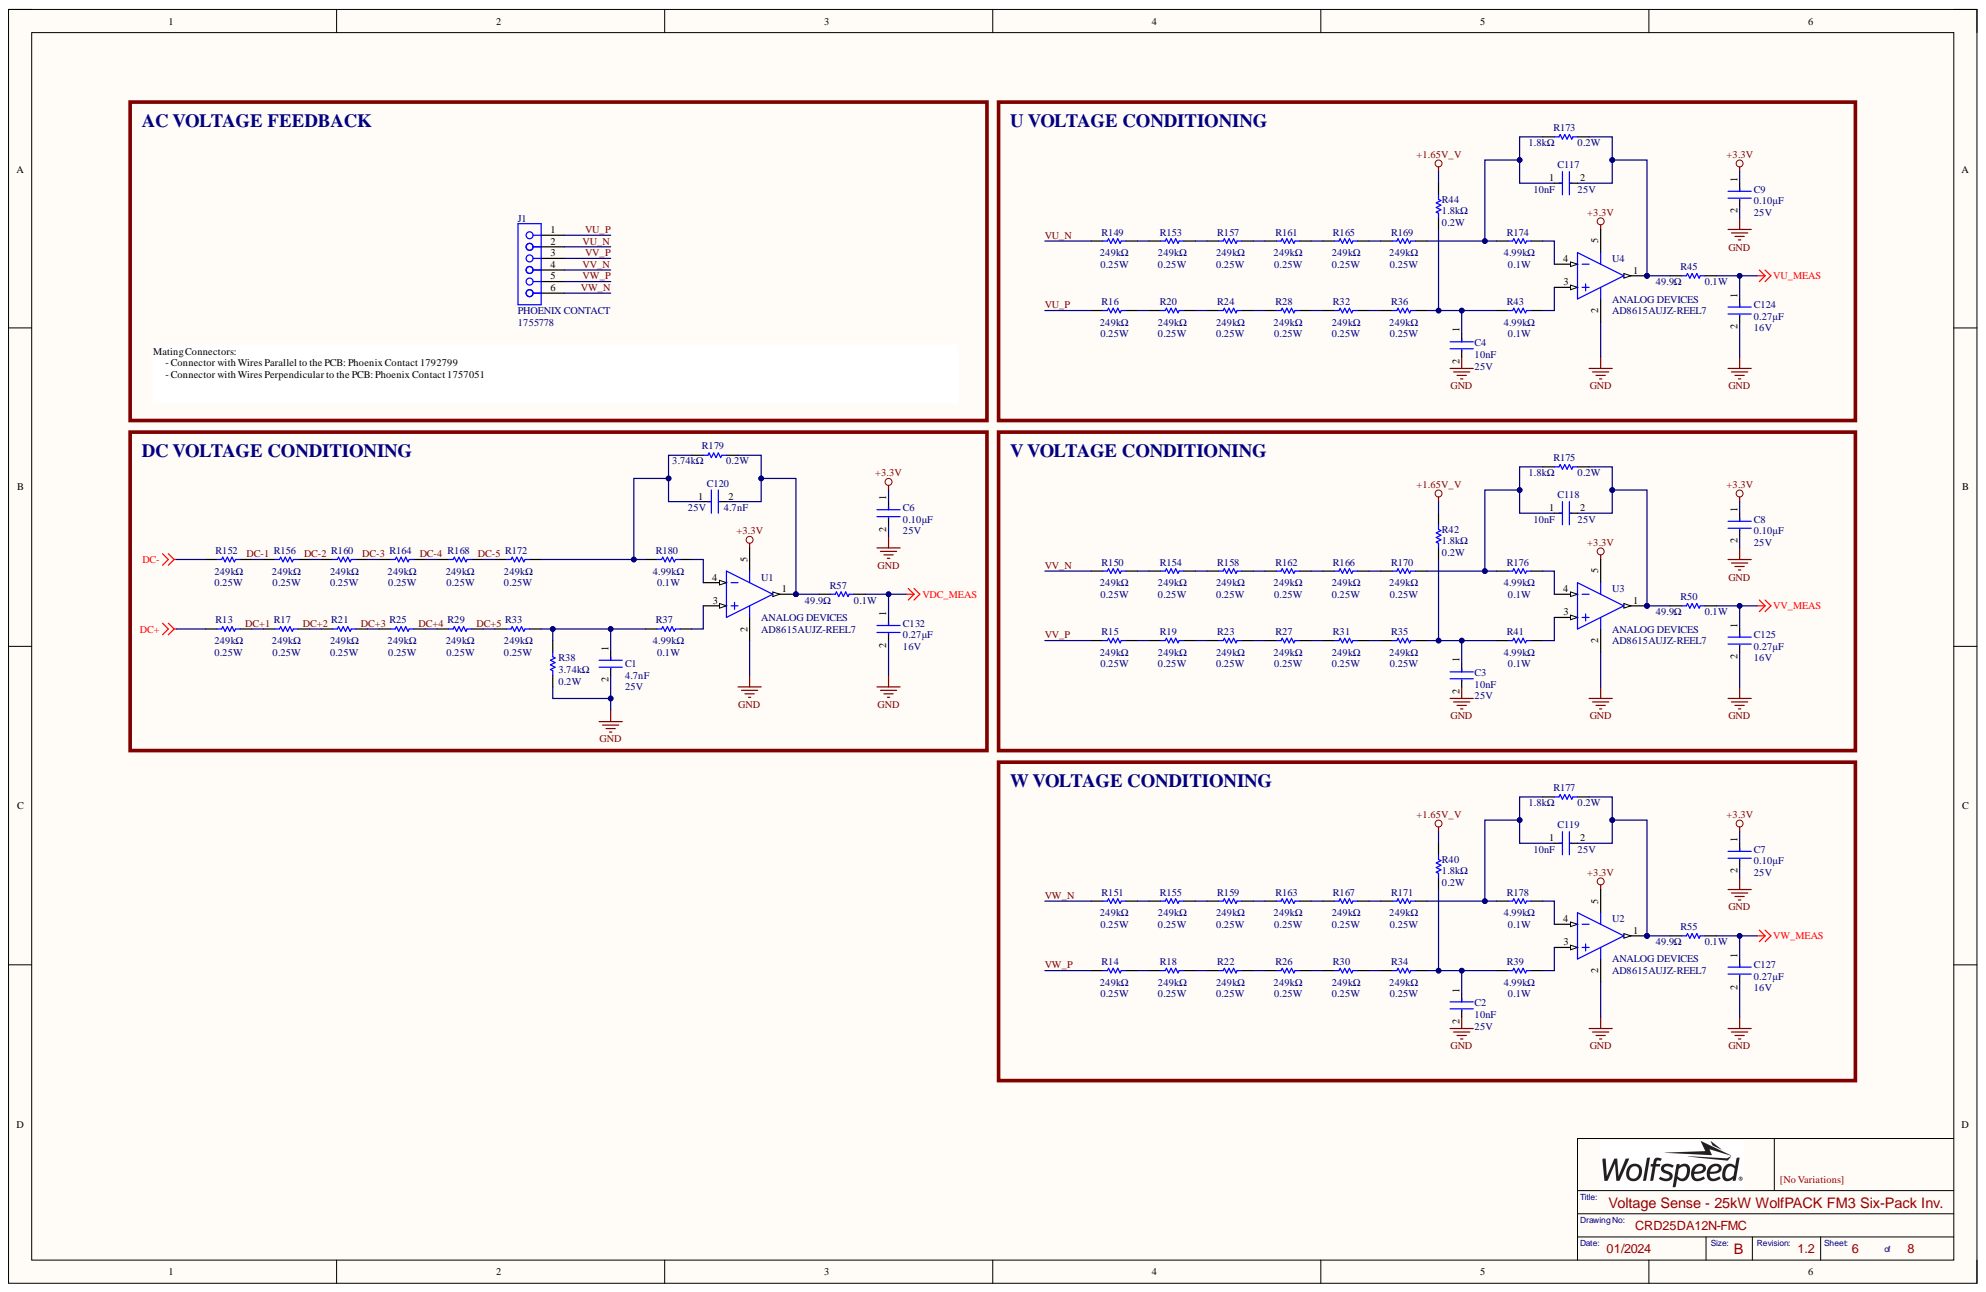
[picture p51: page 6]

MatingConnectors:
- Connector with Wires Parallel to the PCB: Phoenix Contact 1792799
- Connector with Wires Perpendicular to the PCB: Phoenix Contact 1757051

Title:
Voltage Sense - 25kW WolfPACK FM3 Six-Pack Inv.

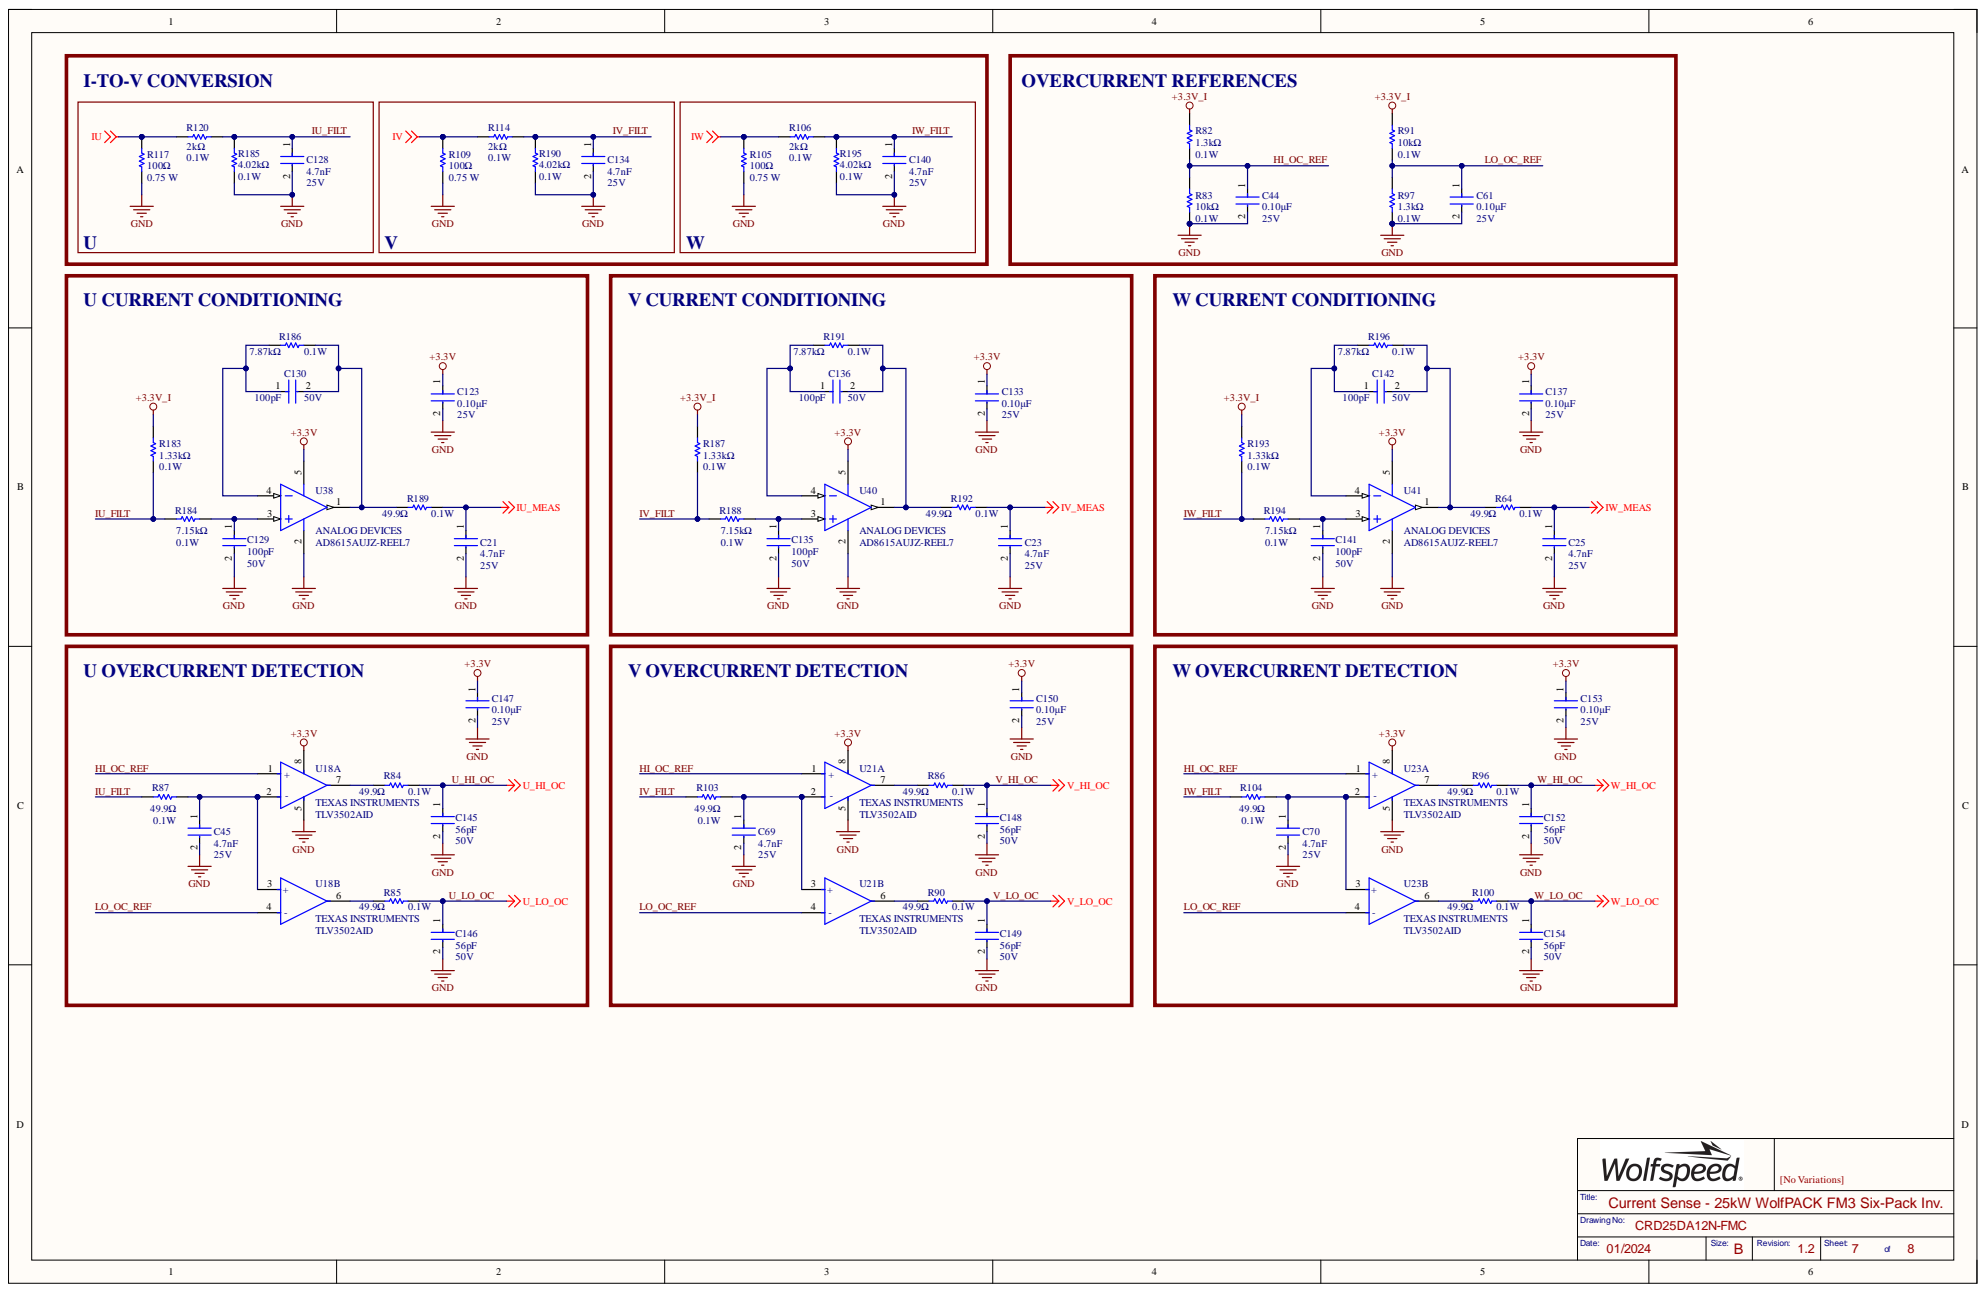
[picture p52: page 7]

Title:
Current Sense - 25kW WolfPACK FM3 Six-Pack Inv.

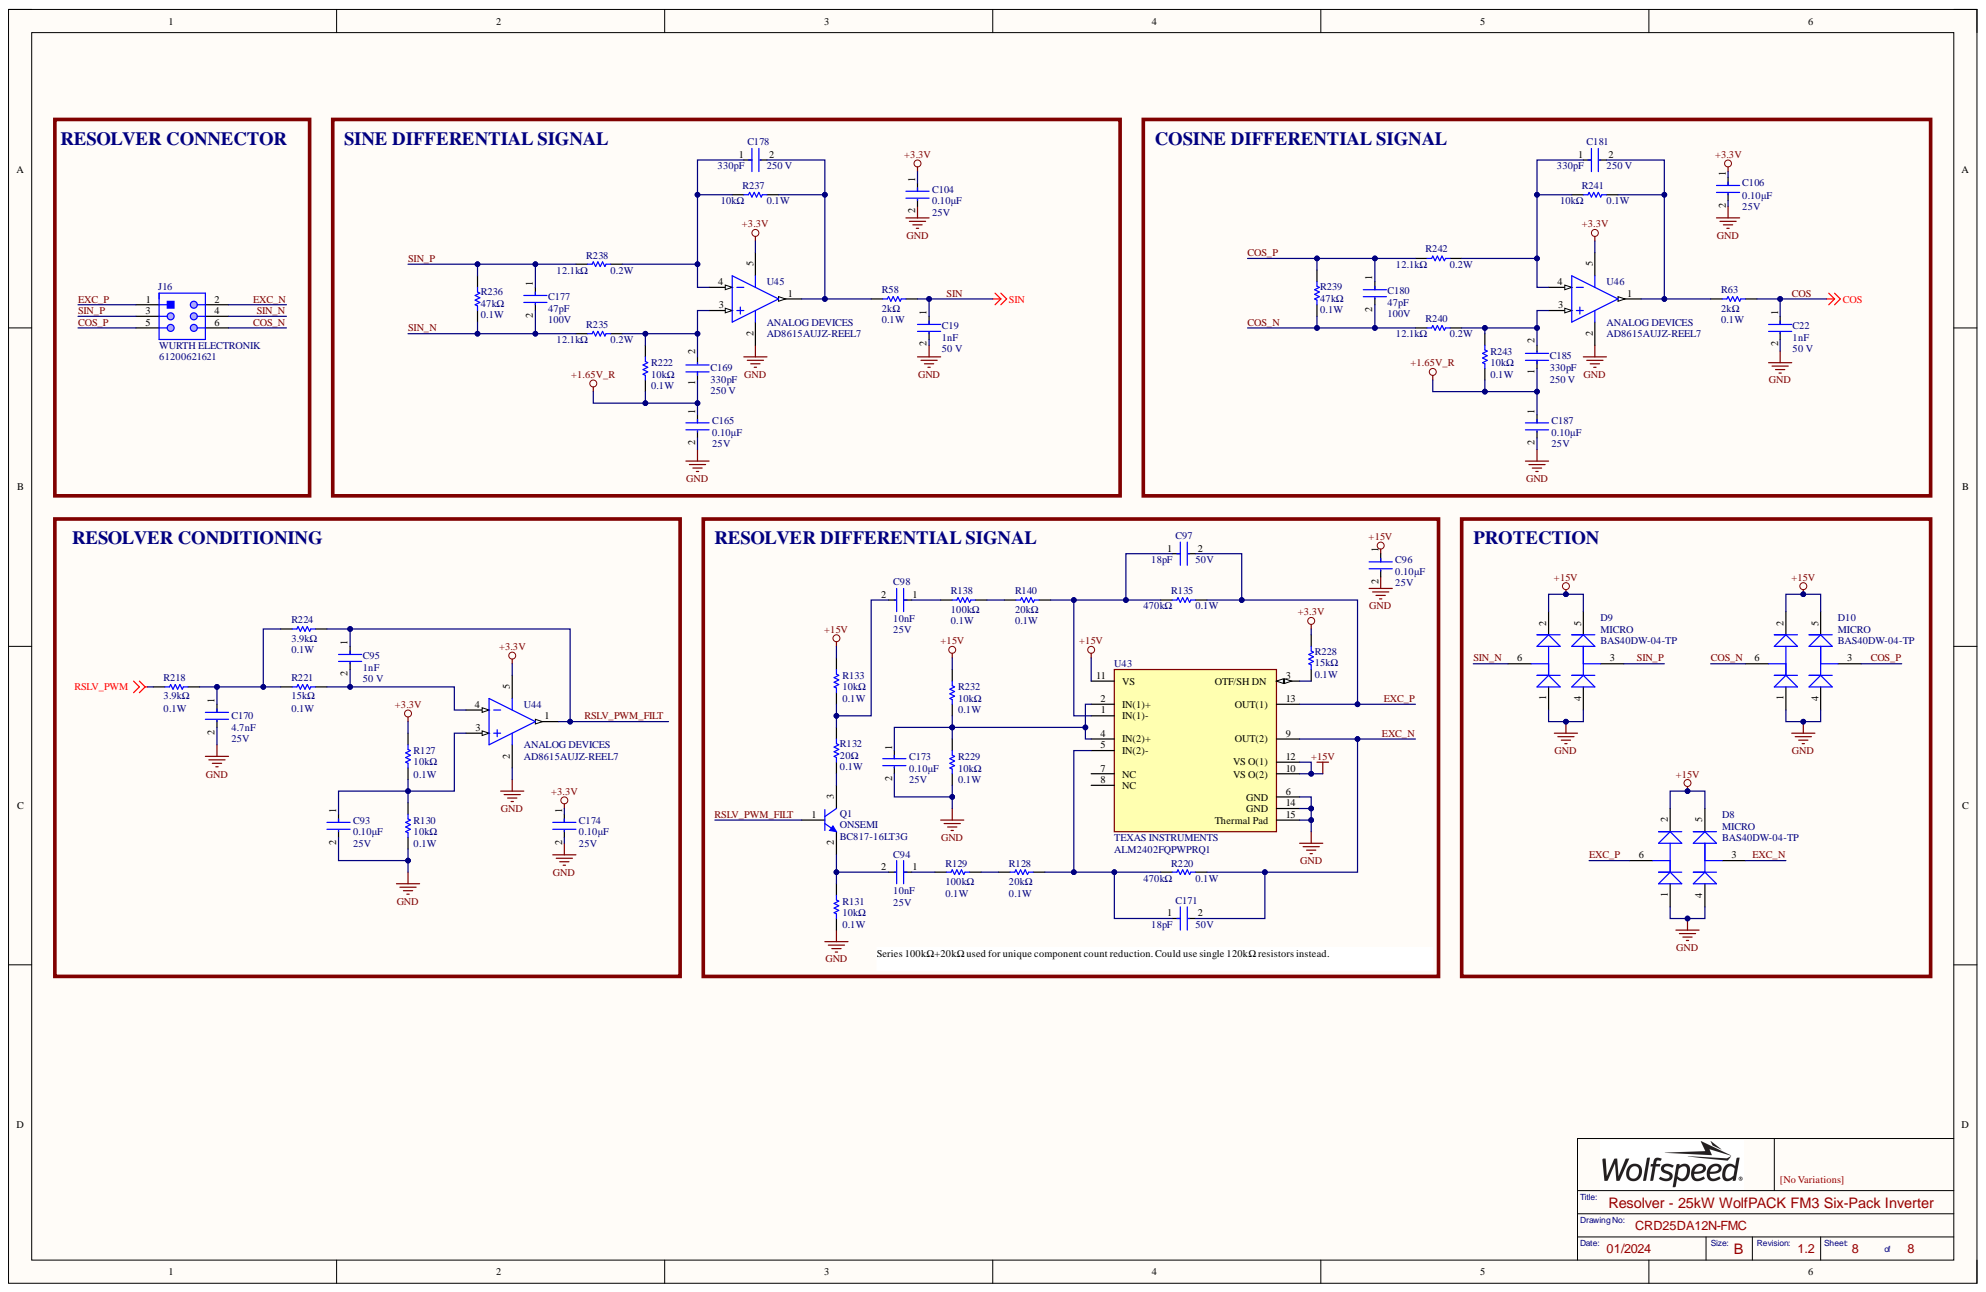
[picture p53: page 8]

Series 100kΩ+20kΩ used for unique component count reduction.Could use single 120kΩ resistors instead.

Title:
Resolver - 25kW WolfPACK FM3 Six-Pack Inverter
