ultrazohm/uz_per_wolfspeed_25kw_fm3/Wolfspeed Inverter Files/CRD25DA12N-FMC_Schematic/CRD25DA12N-FMC V2.0 (09-2024) - Schematic.pdf

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
D | D
C | C
B | B
A | A

Title:

Date: | Revision:

Drawing No:

of Sheet: 09/2024 | 2.0 | 1 | 9

### CRD25DA12N-FMC

## 25kW WolfPACK FM3 Six-Pack Inverter

B Size:

[No Variations]

## BOARD SPECIFICATIONS

## - Dimensions: 8in by 8in, 0.093in thick, 2oz copper on all layers, ENIG, 6 layers

## PRESS-FIT NOTES

## - All other components should be 5mm from the center of the WolfPACK pins

- For the REDCUBE press-fit terminals, per the application notes, other components should be spaced at least 4mm away and the hole should be at least 3mm from the edge.

## GENERAL NOTES

- The +5V_ALT power rail is required to avoid routing the +5V rail across the DC-link copper pours on the PCB. Only route the +12V rail across the DC-link.

# Version History

V1.0 | 2023/04 | Initial release.
V1.1 | 2023/07
Version | Date | Description
V1.2 | 2024/01

Added 10kΩ to gate-source, made Rg easier to access, added thermal relief, switched to 1.65V regulators, fixed inverted regulator outputs

Added: 1) ID pins, 2) CAN filter, 3) fan control, 4) CAN daisy-chain connector, 5) alternative NOPOP aux power connector (for powering from adapter board), 6) missing bias pin to -/+15V IC, 7) pull up/down resistors to spare GPIOs/ADCs, 8) creepage/clearange slots under gate drivers, 9) EPWM pins to the spare I/O connector, 10) ambient temperature measurement.

NTC switched from isolated PWM using ECAP to isolated op amp using ADC. CAN upgraded to CAN FD functionality. Switched spare ADCs to have DAC capability. Changed voltage/current sense circuit gains to better use ADC dynamic range. Removed overcurrent hardware (performing overcurrent in software). Changed some of the ADC mapping to better utilize ADCB and ADCC. Changed fan connector to avoid crimping requirement in assembly.

RELAY1 controlled by GPIO44; GPIO57 routed to spare pin connector; Updated spare connector pinout to reflect GPIO changes; Moved DC-DC converters from controller for easier insert/remove; Reduced mounting hole annular ring; Moved components hidden by heat sink to topside; Silkscreen & copper pour clean up; Added option to float heatsink; Fixed resolver excitation circuit; Design rule improvements; Removed thermal relief from press-fit pins since no soldering; Improved pin notations in footprint silkscreens; Switched +/-15V regulation circuit to LM5157QRTERQ1; Added top

## layer copper islands to DC+/- terminals of module for improved thermals

Reduced number of unique BOM items by changing the following: 1) LED resistors, 2) input power conditioning resistors & RETRY capacitor, 3)

## NTC isolated supply

# BLOCK DIAGRAM

V2.0 2024/09

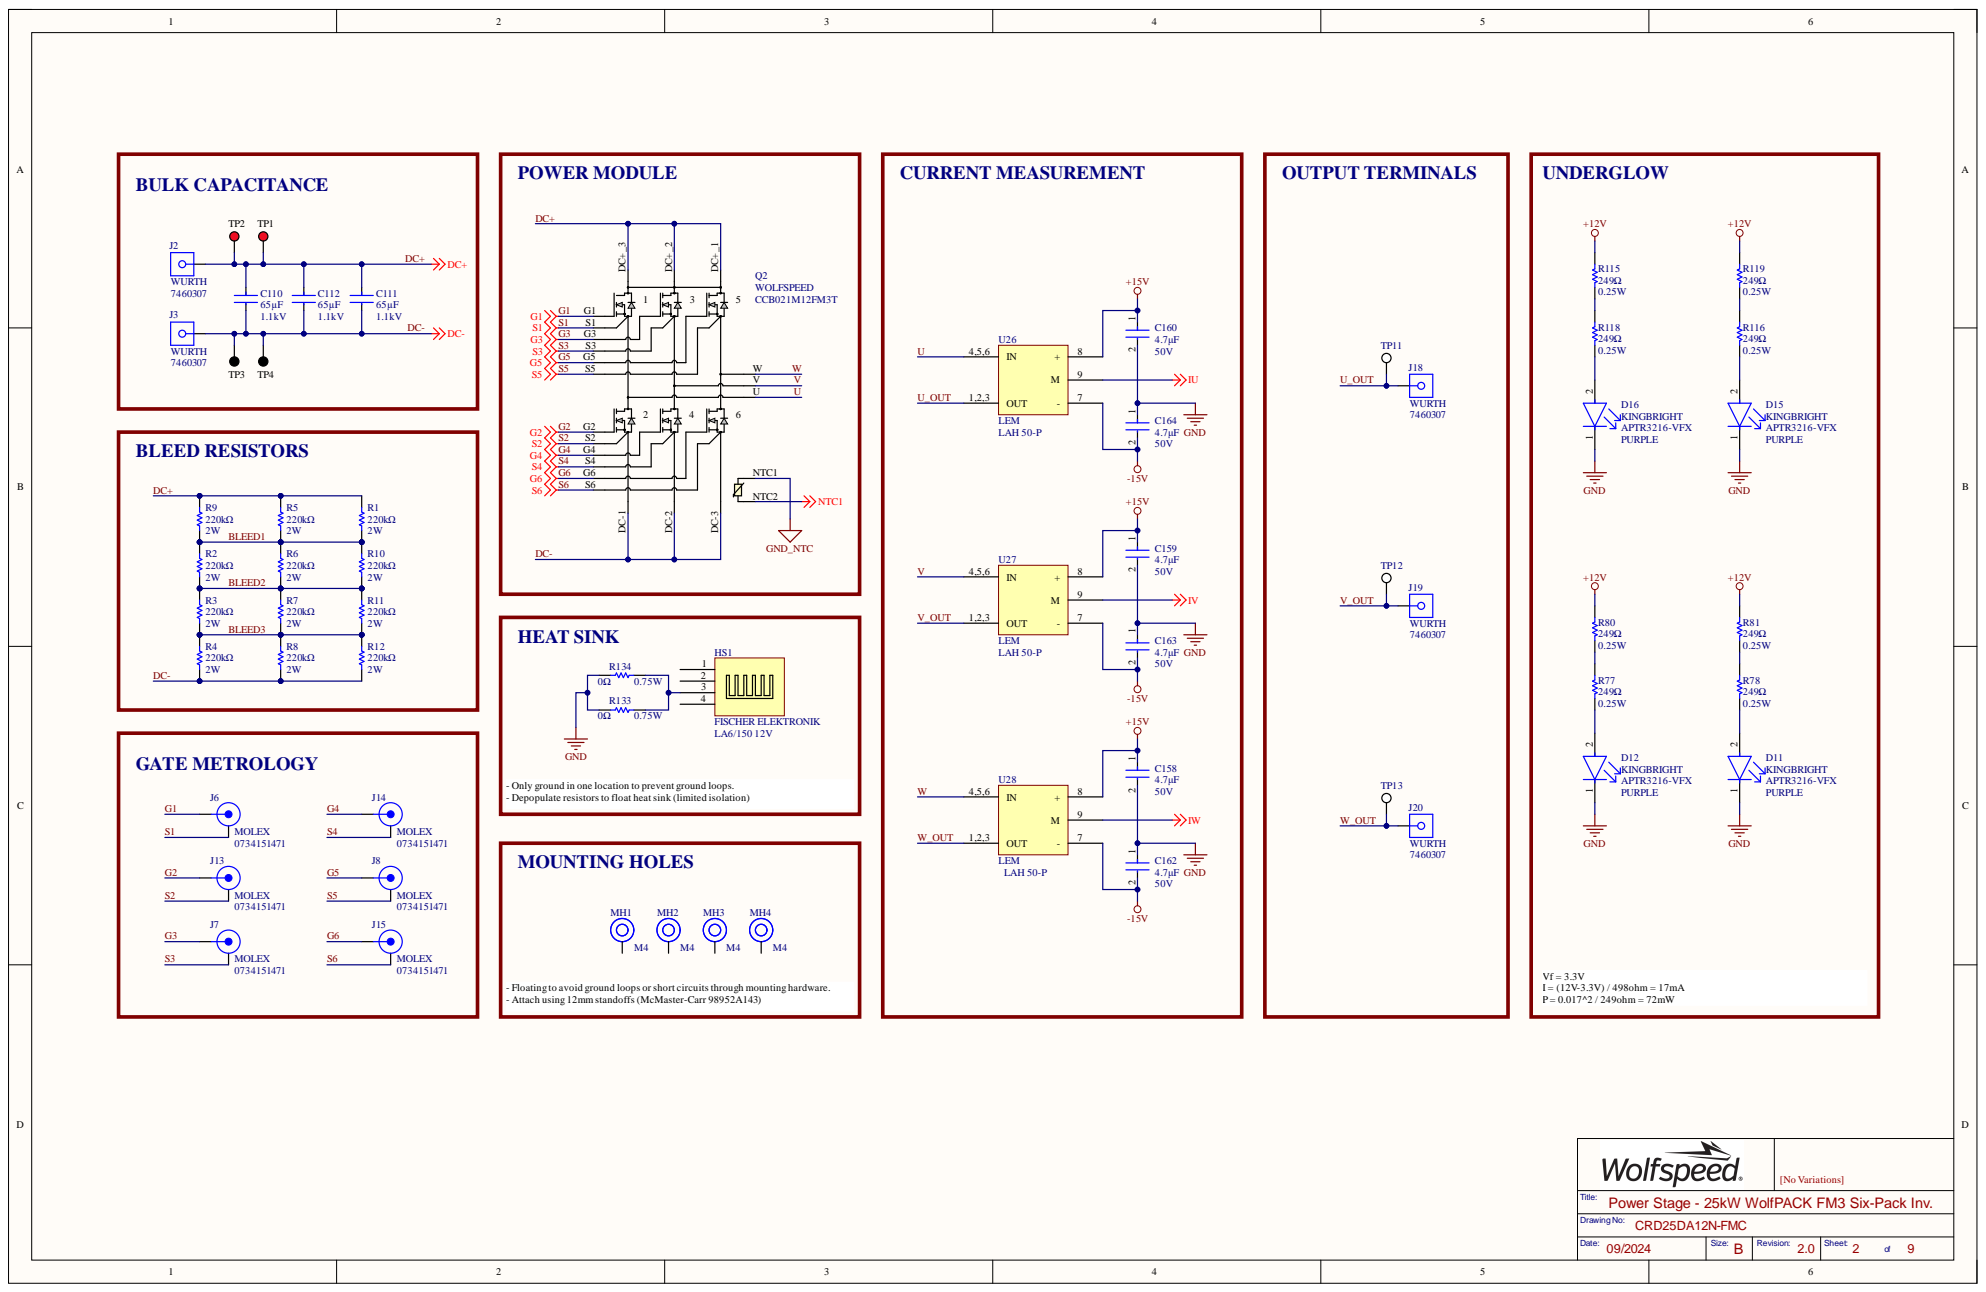
[picture p54: page 2]

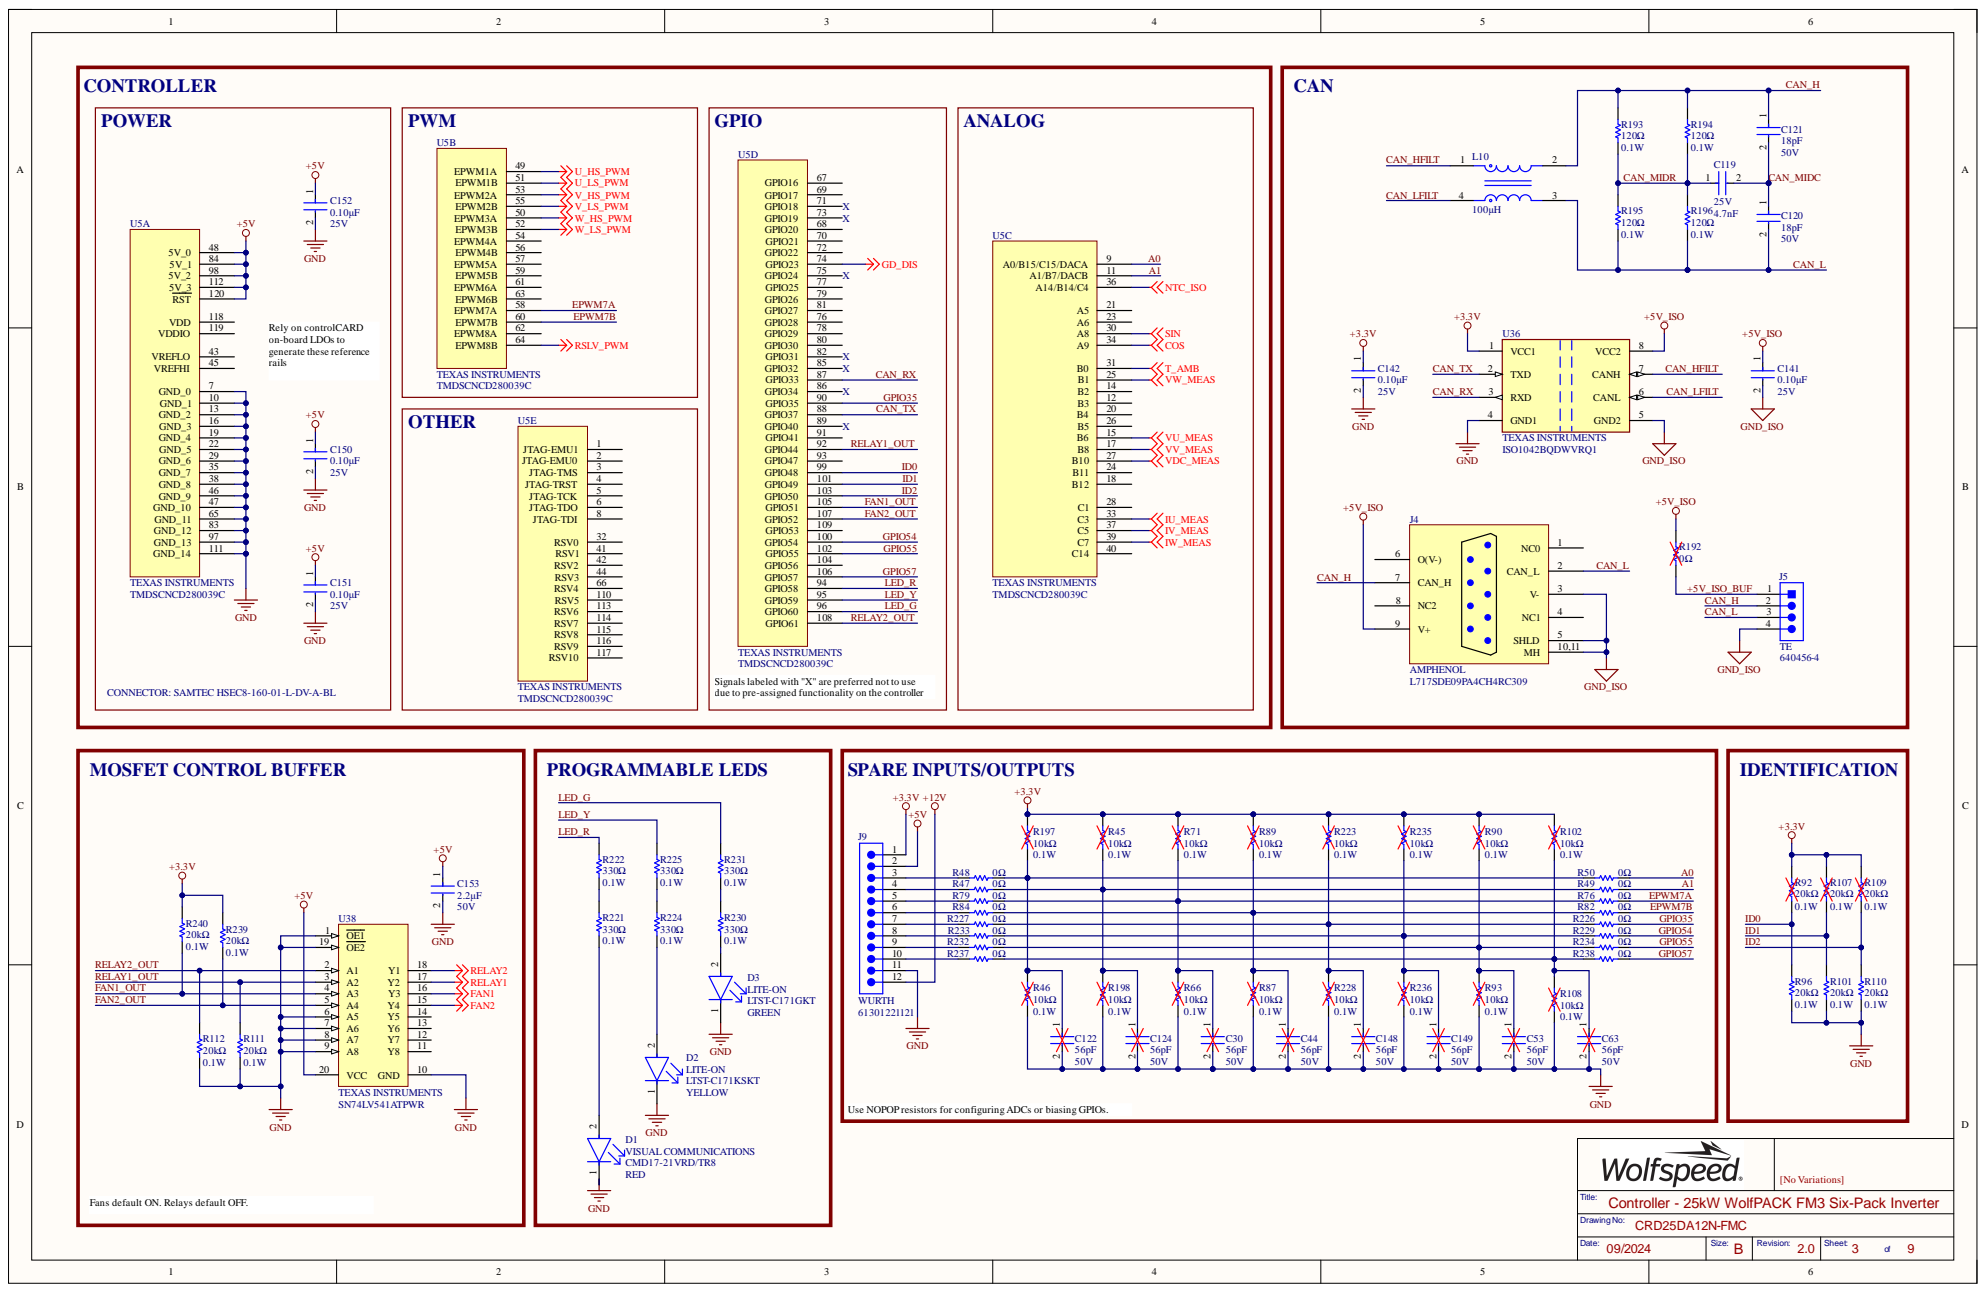
[picture p55: page 3]

Rely on controlCARD
on-board LDOs to
generate these reference
rails

CONNECTOR: SAMTEC HSEC8-160-01-L-DV-A-BL

Signals labeled with "X" are preferred not to use
due to pre-assigned functionality on the controller

R49 0Ω A1
R76 0Ω EPWM7A
R82 0Ω EPWM7B
R226 0Ω GPIO35

Use NOPOP resistors for configuring ADCs or biasing GPIOs.

Title:
Controller - 25kW WolfPACK FM3 Six-Pack Inverter

Fans default ON. Relays default OFF.

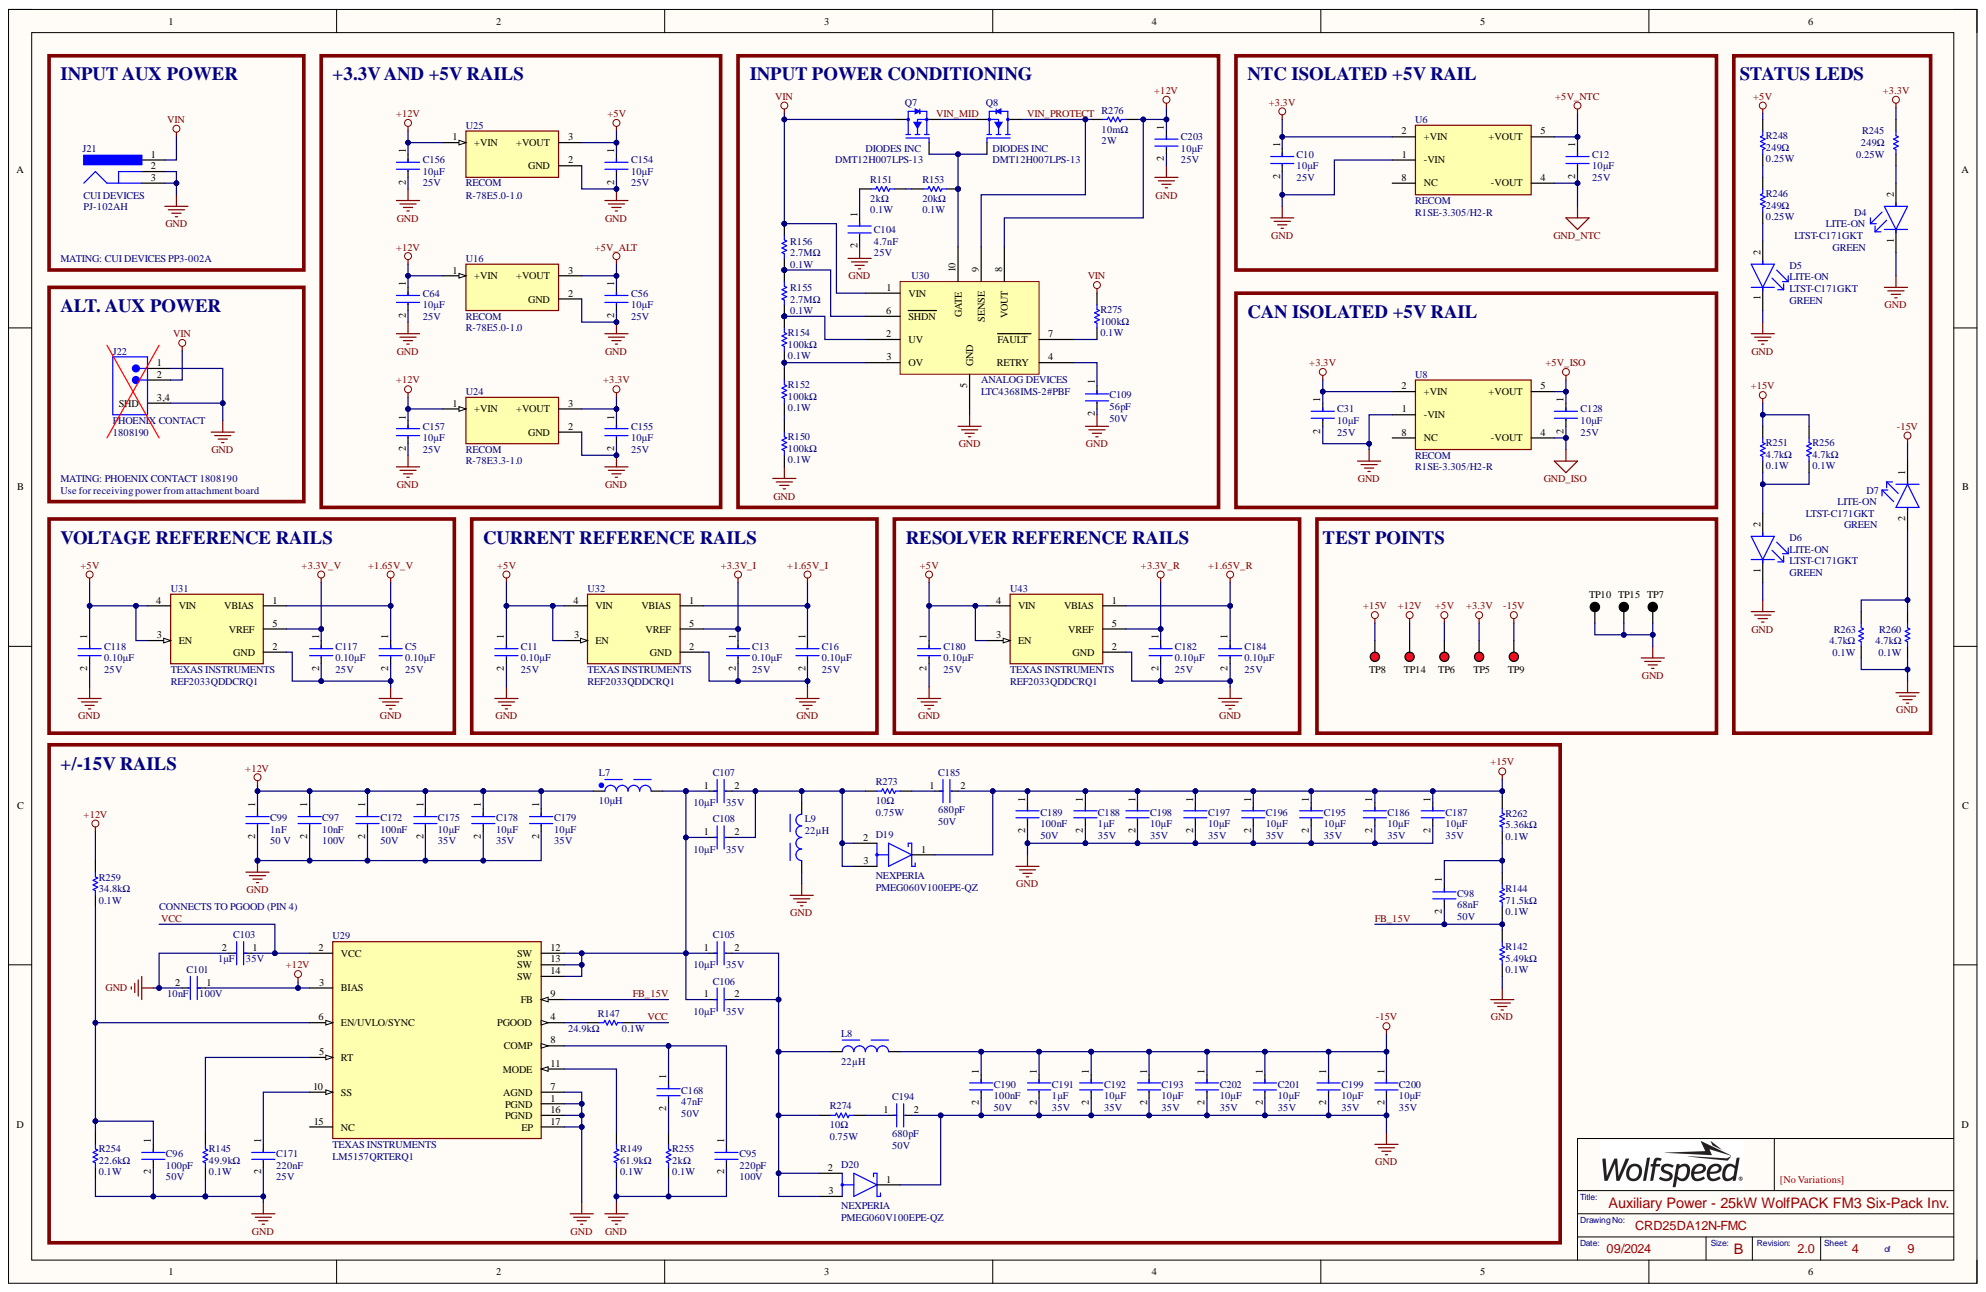
[picture p56: page 4]

MATING: PHOENIX CONTACT 1808190
Use for receiving power from attachment board

CONNECTS TO PGOOD (PIN 4)
GND VCC

Title:
Auxiliary Power - 25kW WolfPACK FM3 Six-Pack Inv.

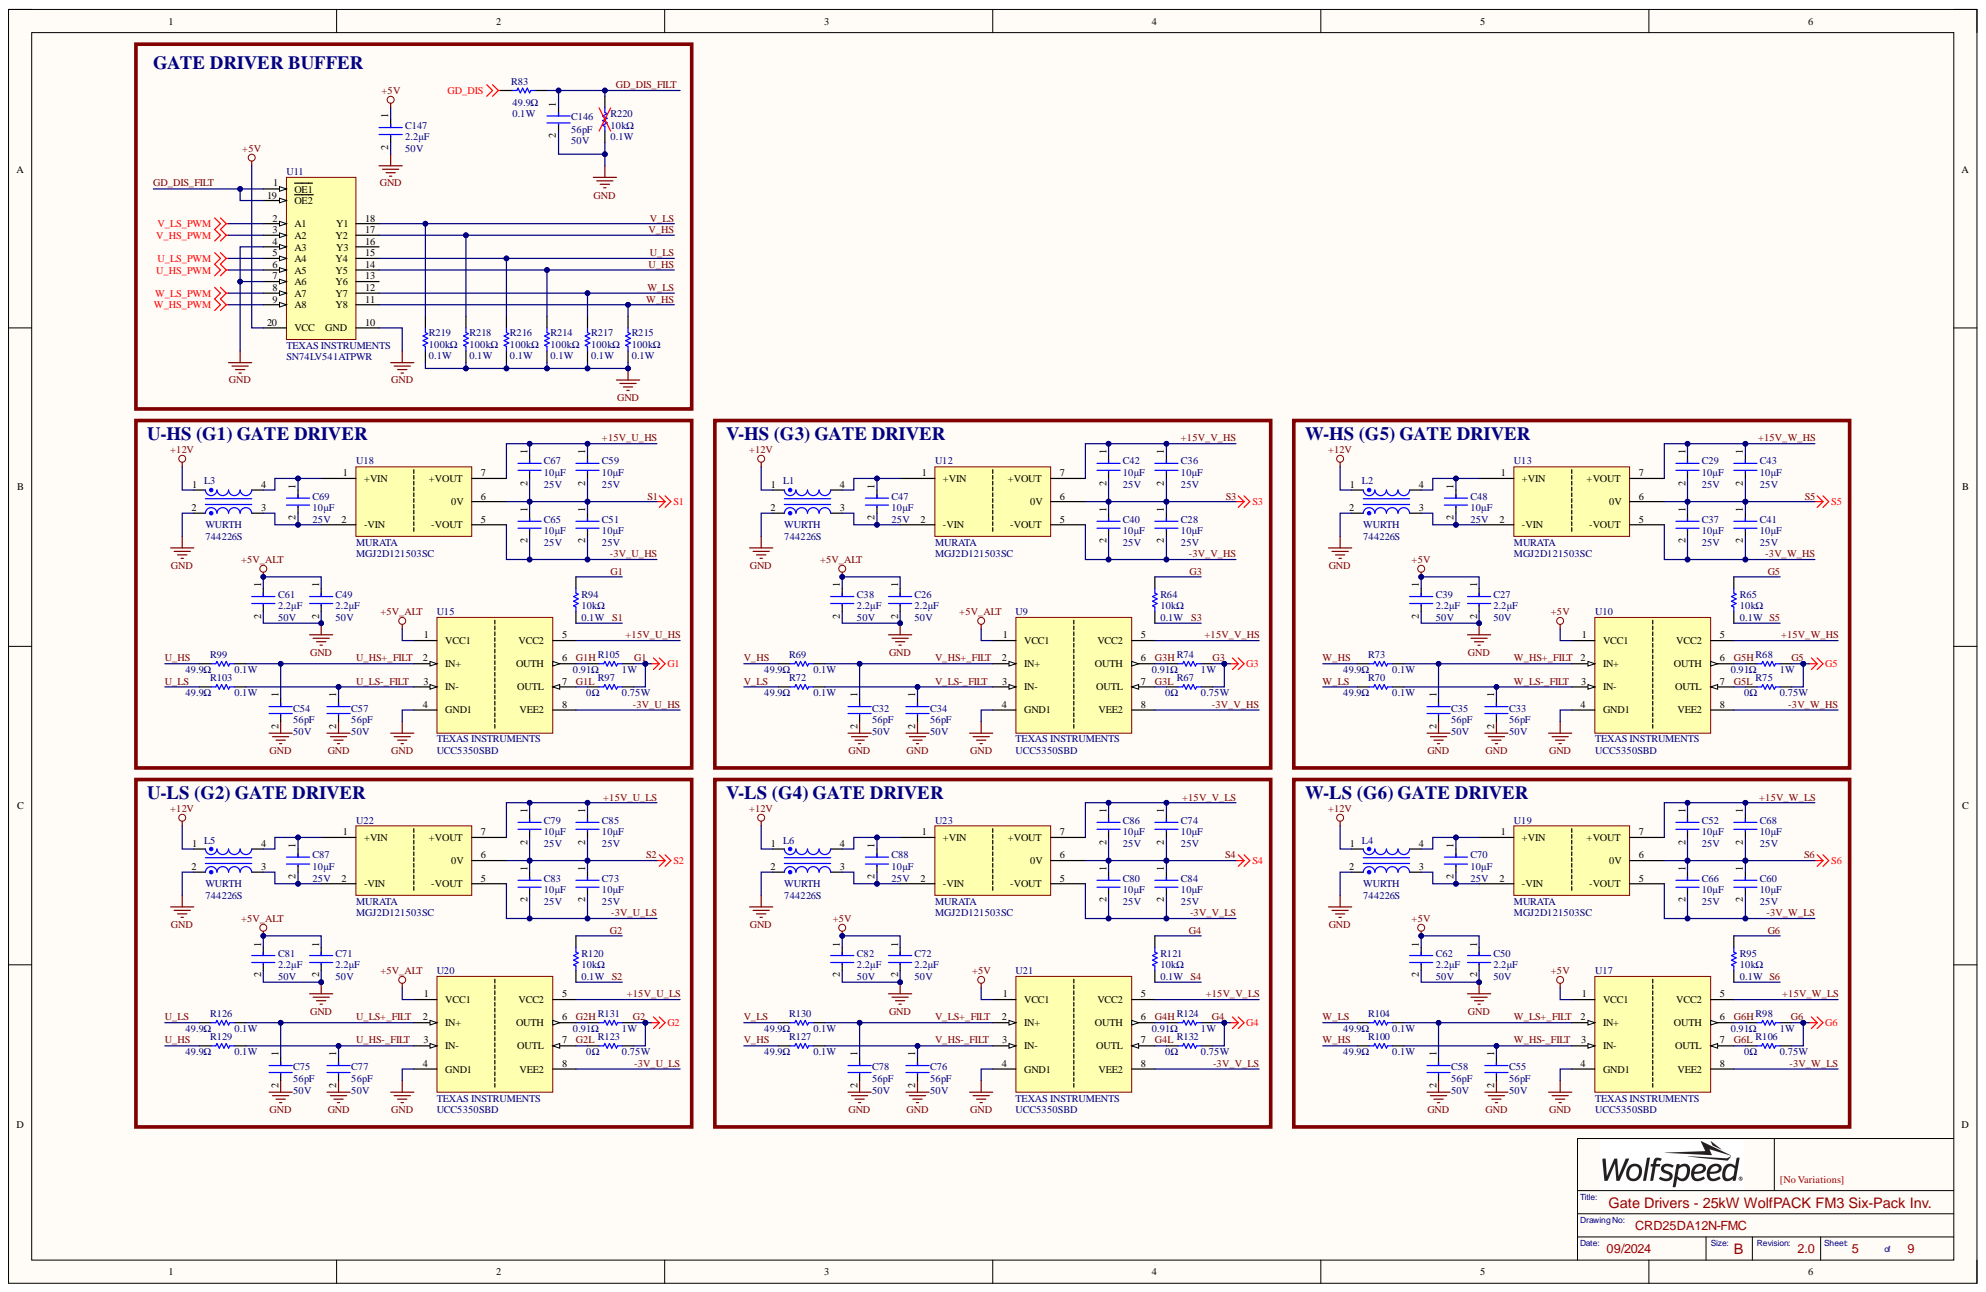
[picture p57: page 5]

A7 8 A8 9 VCC 20

Title:
Gate Drivers - 25kW WolfPACK FM3 Six-Pack Inv.

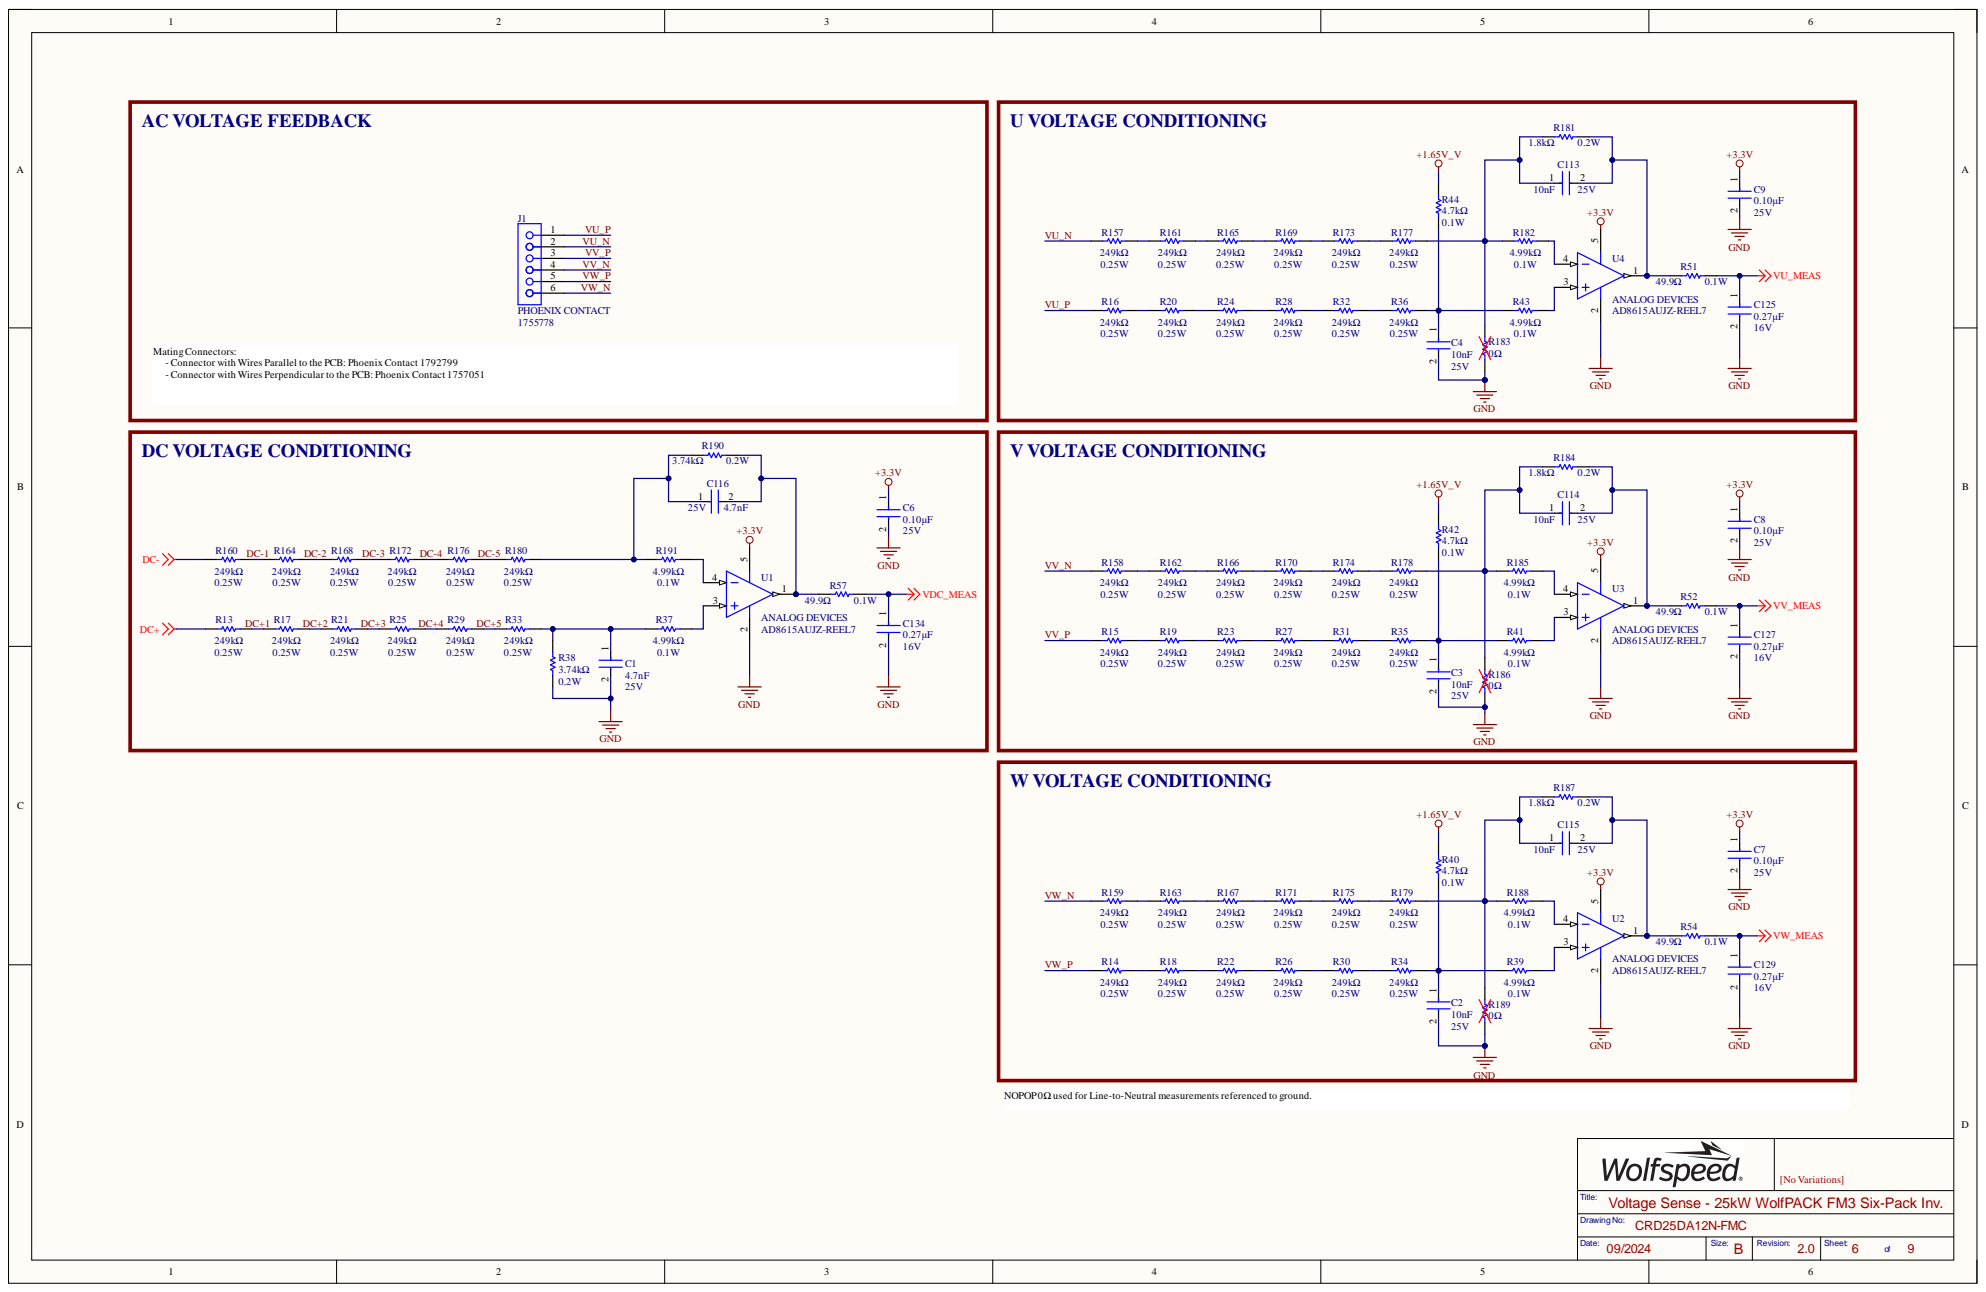
[picture p58: page 6]

MatingConnectors:
- Connector with Wires Parallel to the PCB: Phoenix Contact 1792799
- Connector with Wires Perpendicular to the PCB: Phoenix Contact 1757051

NOPOP0Ω used for Line-to-Neutral measurements referenced to ground.

Title:
Voltage Sense - 25kW WolfPACK FM3 Six-Pack Inv.

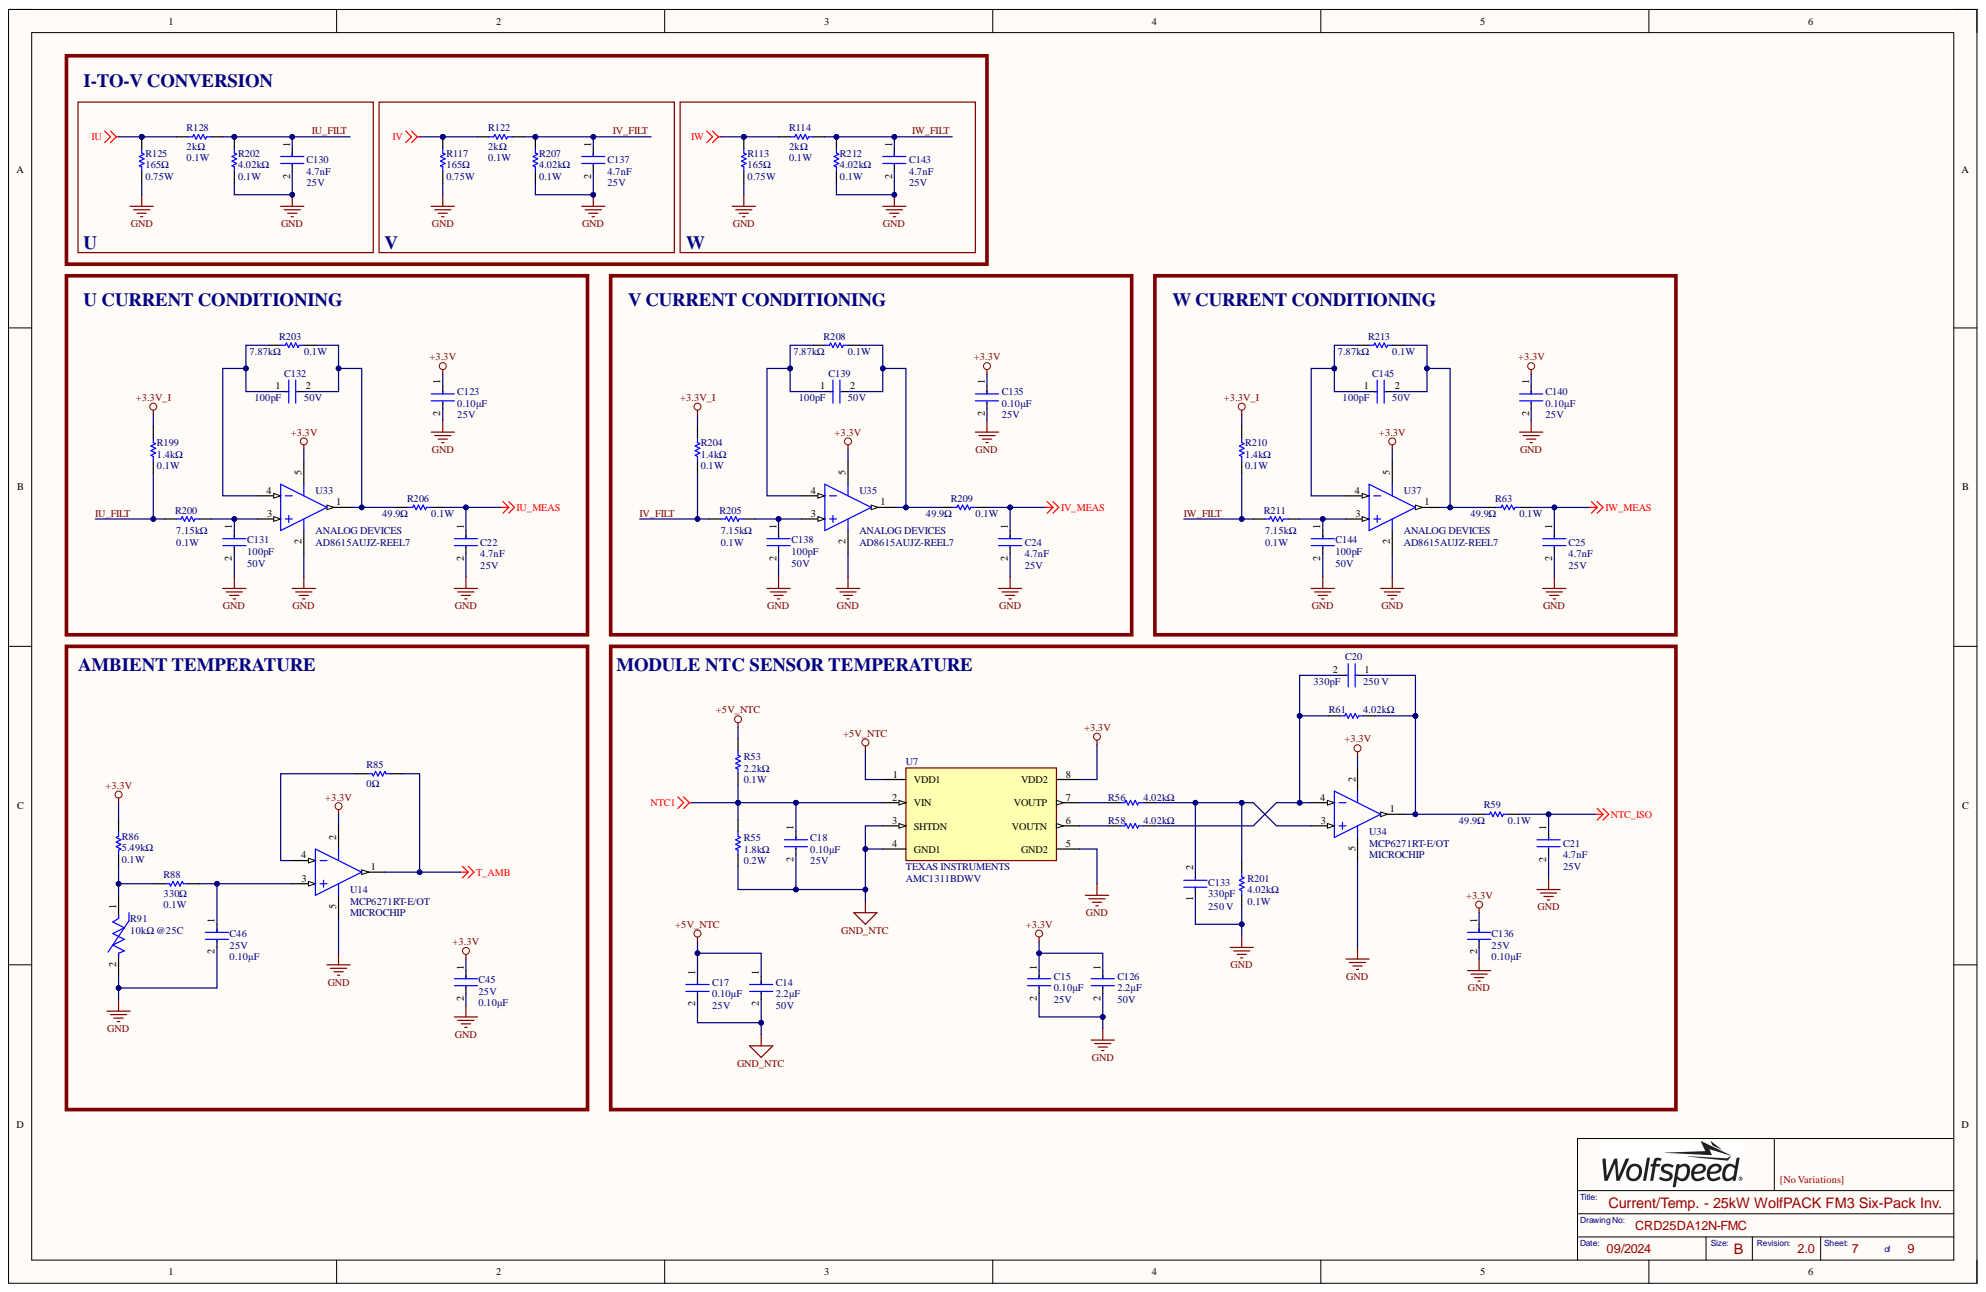
[picture p59: page 7]

Title:
Current/Temp. - 25kW WolfPACK FM3 Six-Pack Inv.

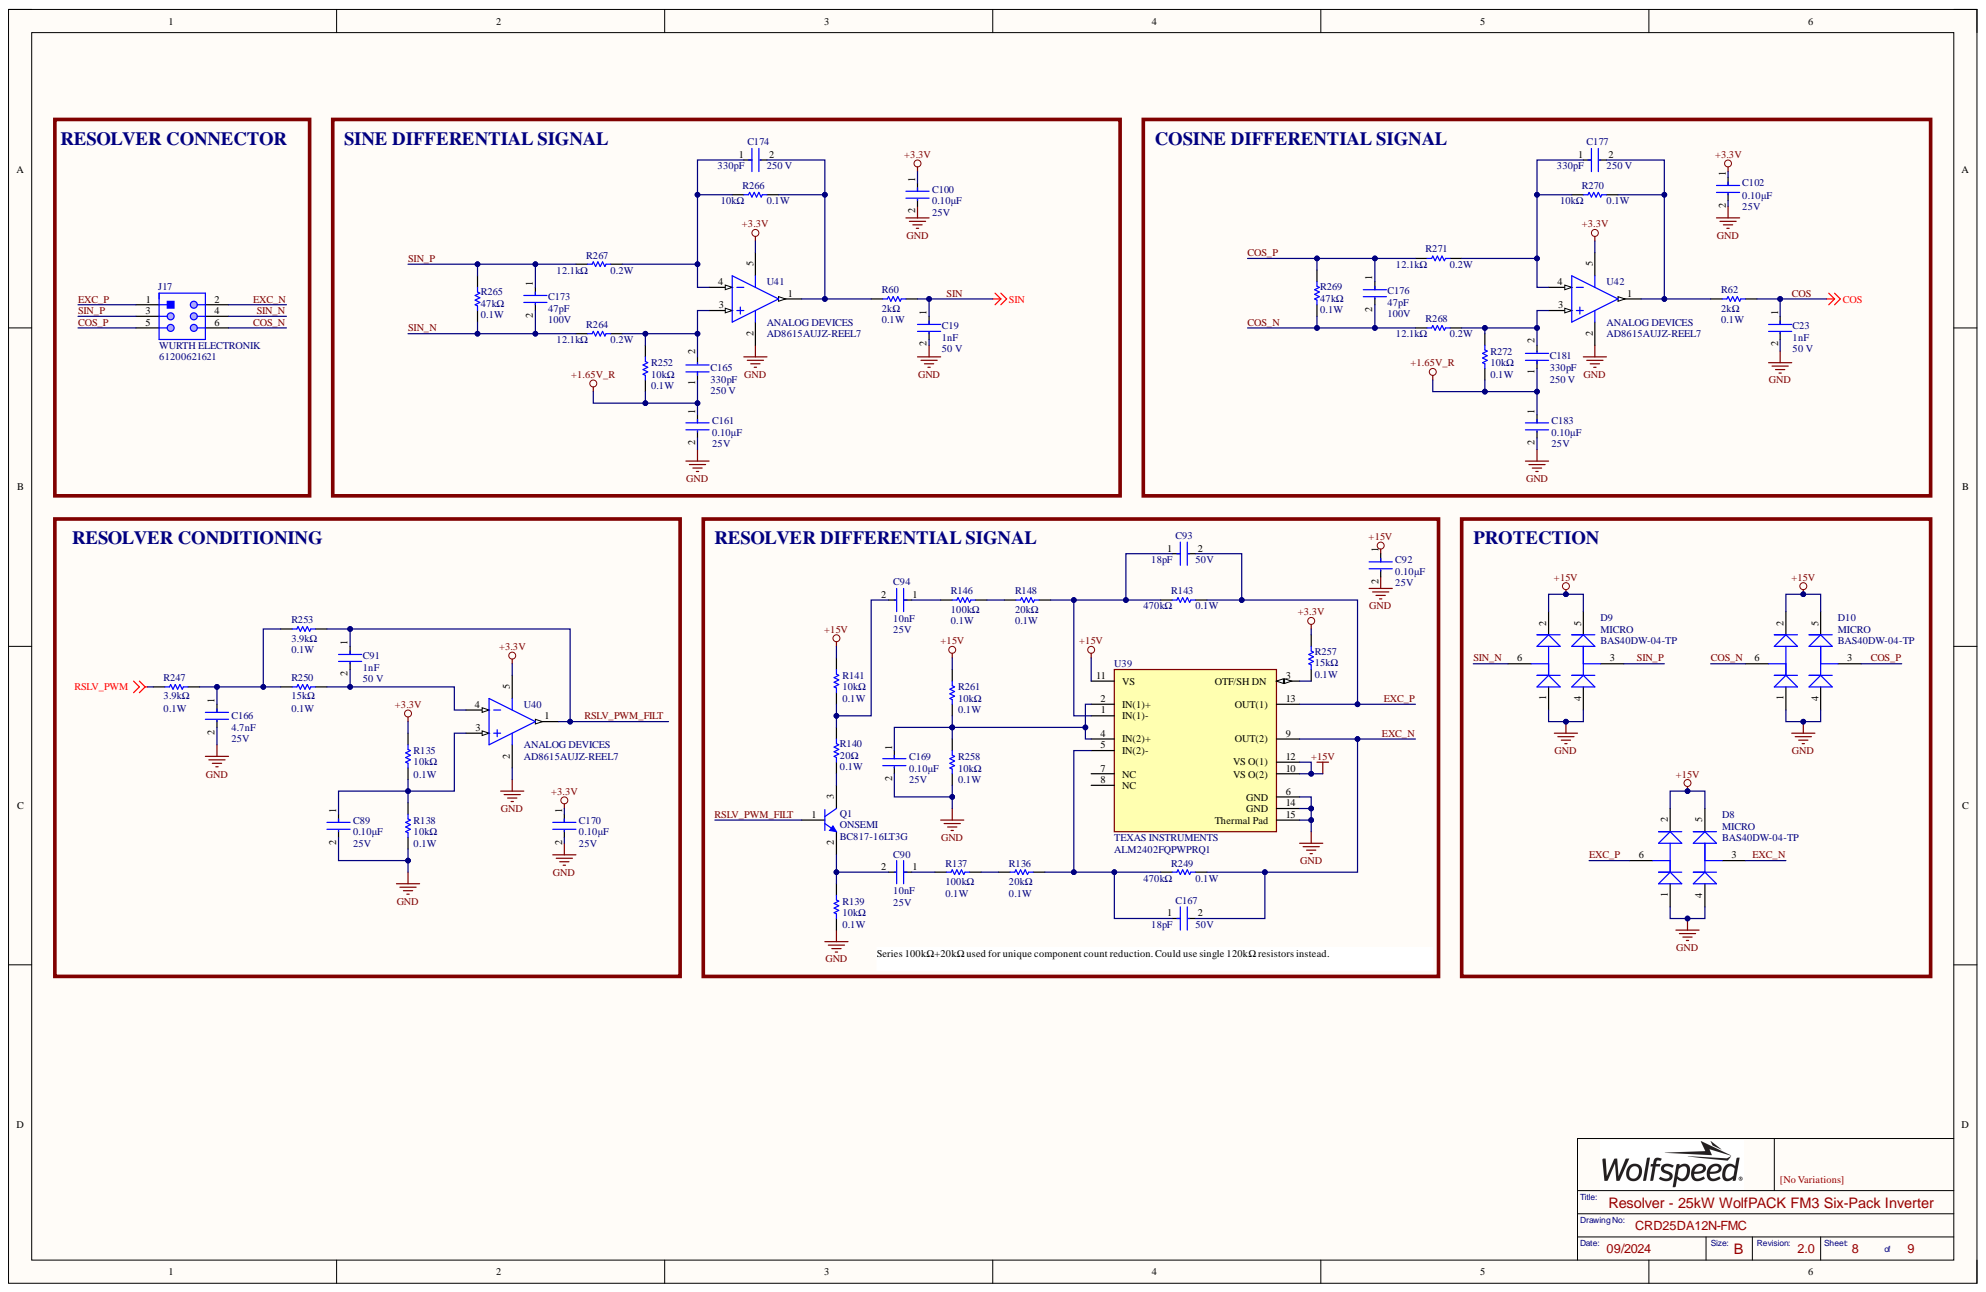
[picture p60: page 8]

Series 100kΩ+20kΩ used for unique component count reduction.Could use single 120kΩ resistors instead.

Title:
Resolver - 25kW WolfPACK FM3 Six-Pack Inverter

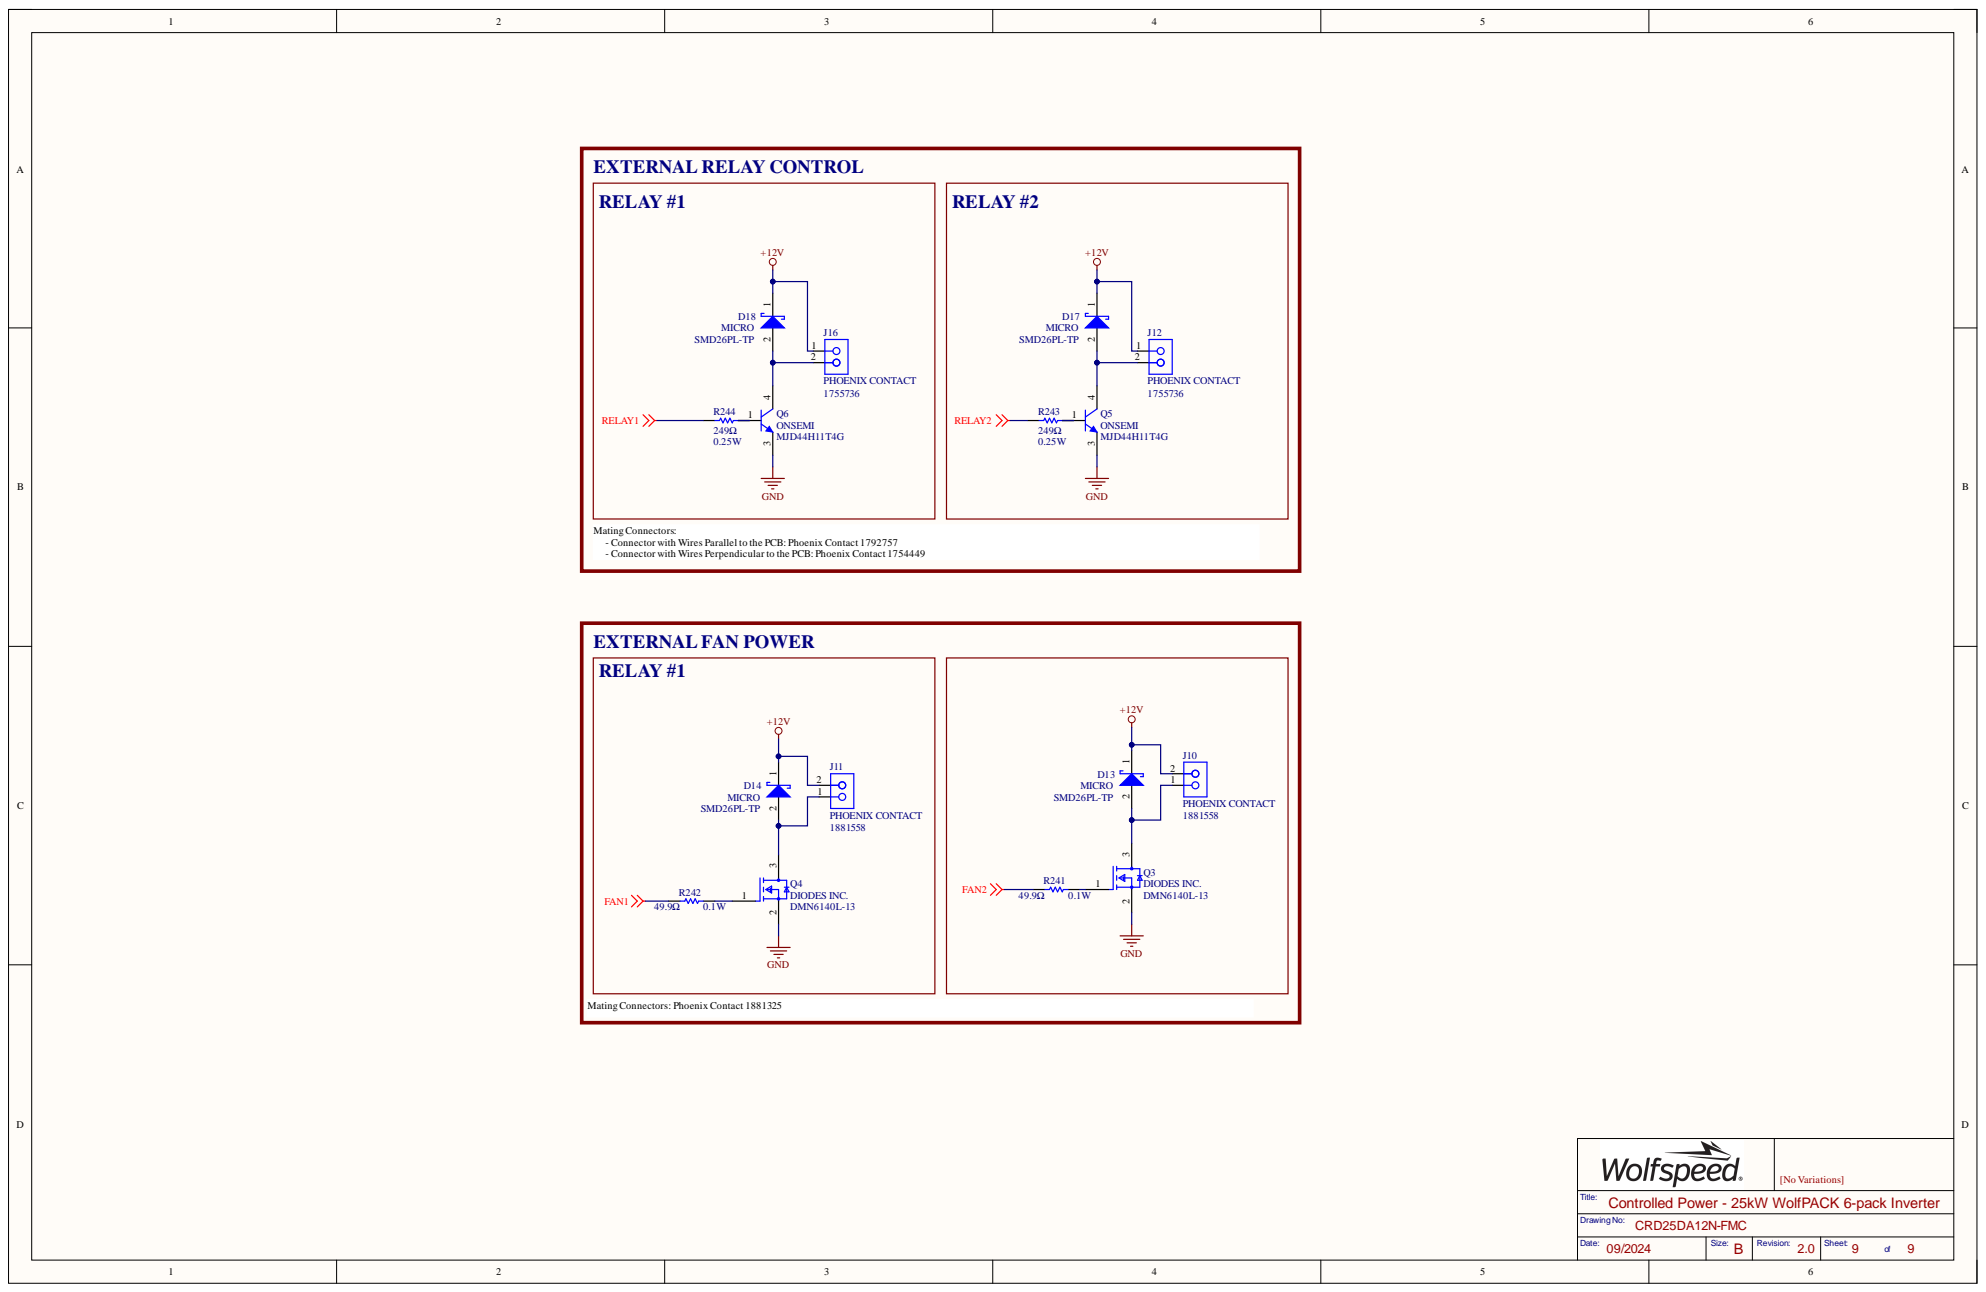
[picture p61: page 9]

MatingConnectors:
- Connector with Wires Parallel to the PCB: Phoenix Contact 1792757
- Connector with Wires Perpendicular to the PCB: Phoenix Contact 1754449

Title:
Controlled Power - 25kW WolfPACK 6-pack Inverter
