ultrazohm/uz_per_wolfspeed_25kw_fm3/Altium/Project Outputs for uz_per_wolfspeed_25kw_FM3/Rev04/SCH_uz_per_wolfspeed_25kw_FM3_jlc_Rev04.PDF

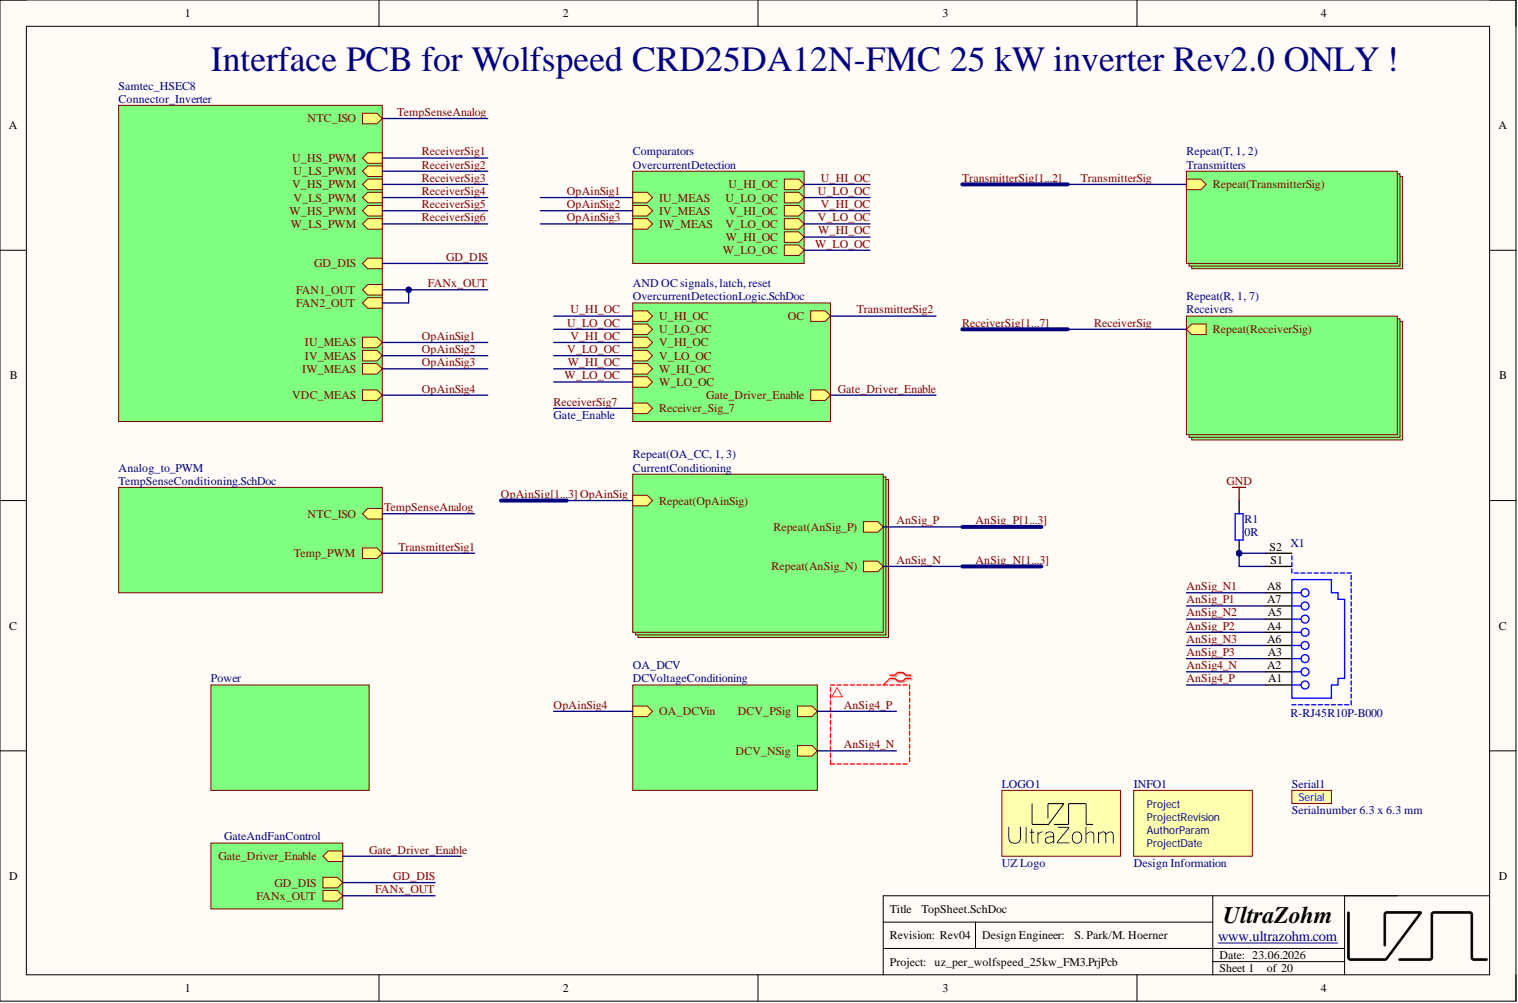
[picture p62: page 1]

Interface PCB for Wolfspeed CRD25DA12N-FMC 25 kW inverter Rev2.0 ONLY !

Revision:

Date: 23.06.2026

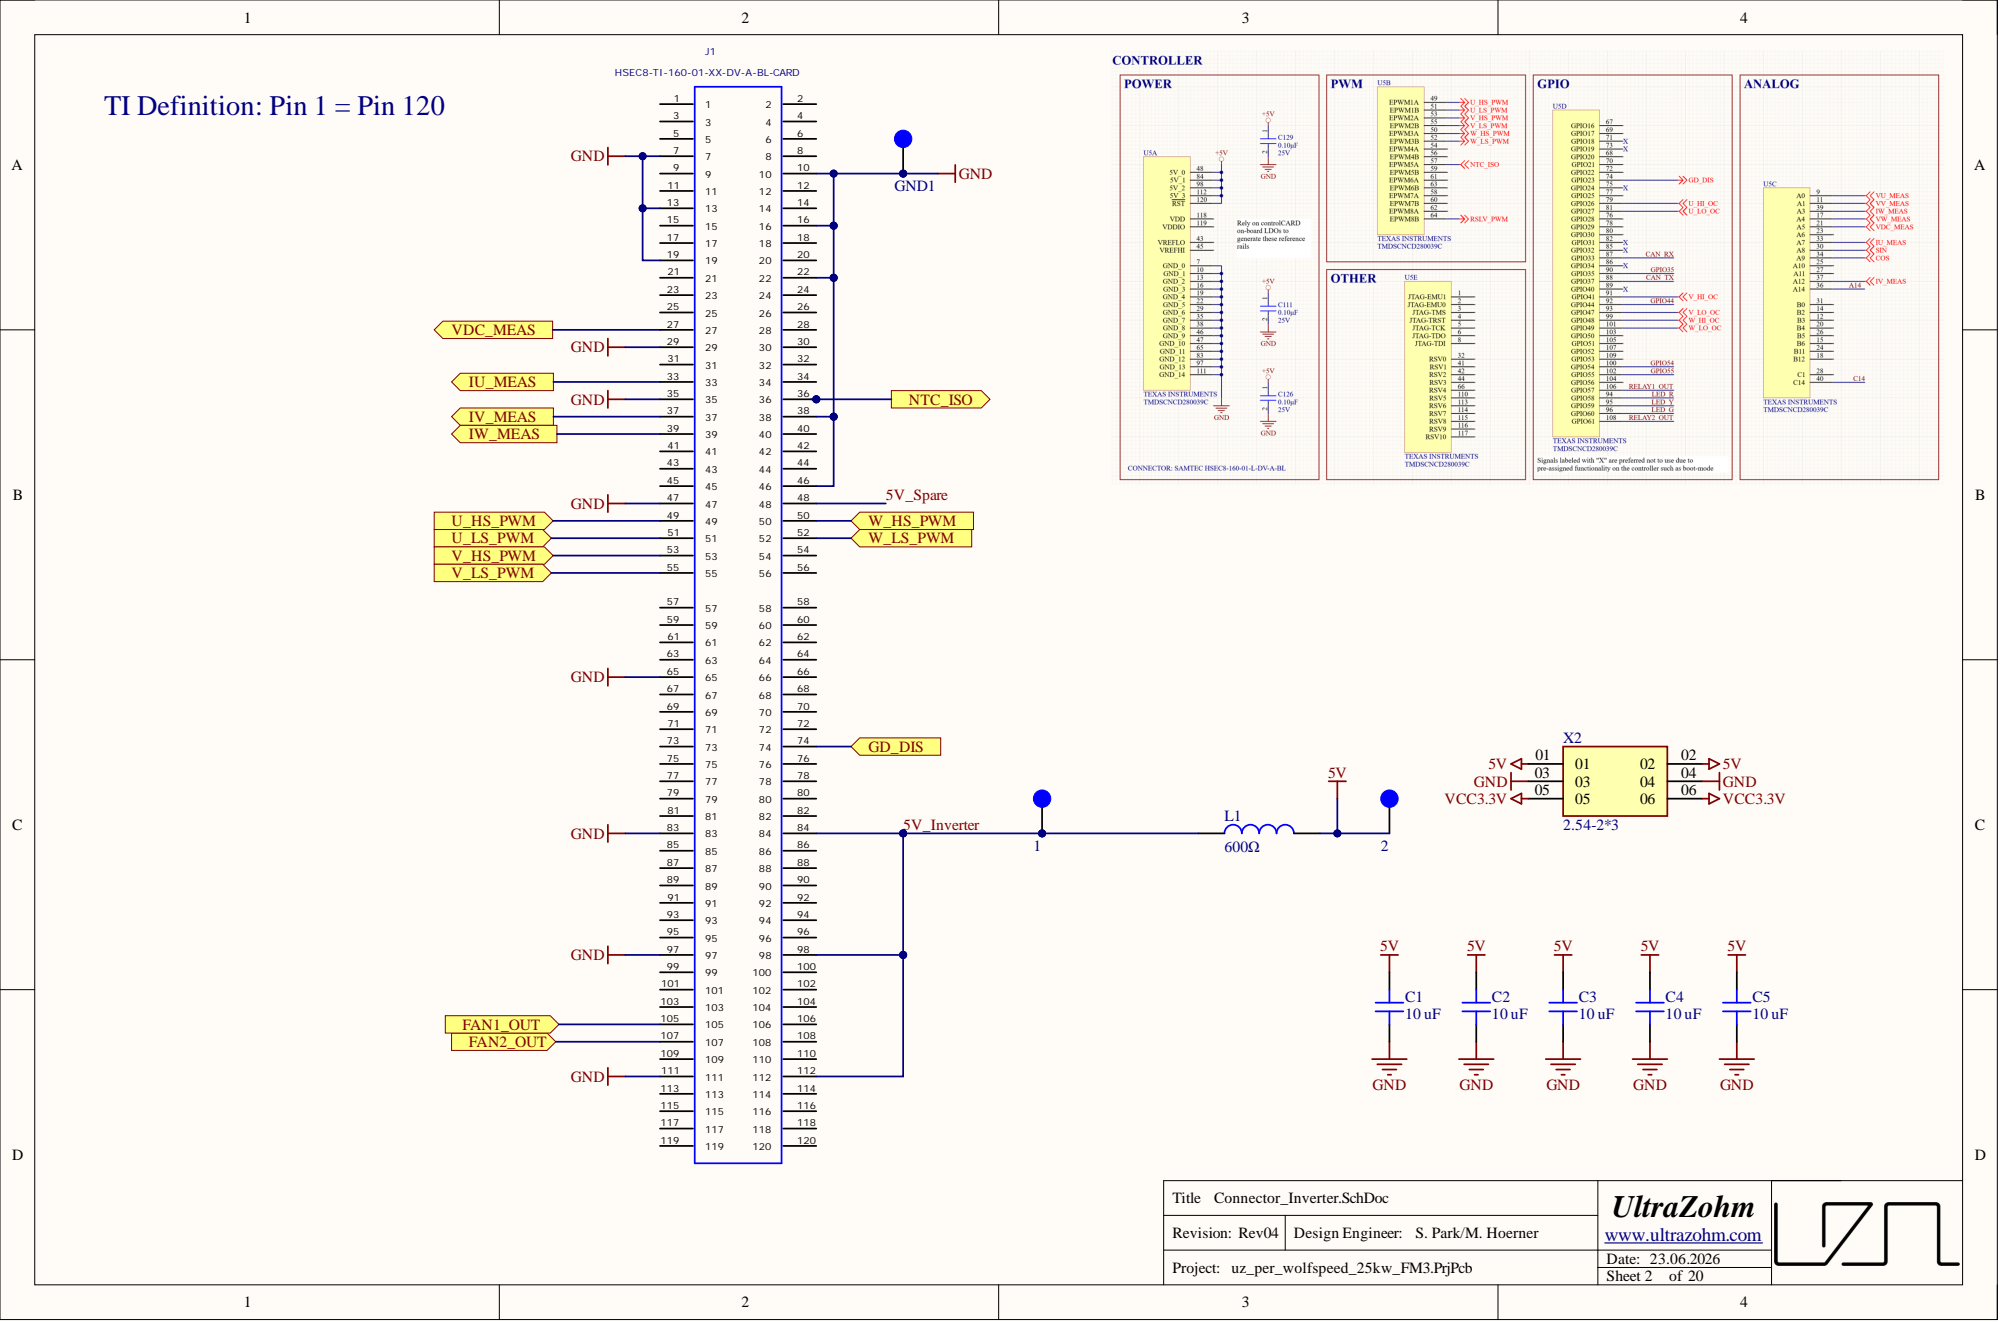
[picture p63: page 2]

HSEC8-TI-160-01-XX-DV-A-BL-CARD

TI Definition: Pin 1 = Pin 120

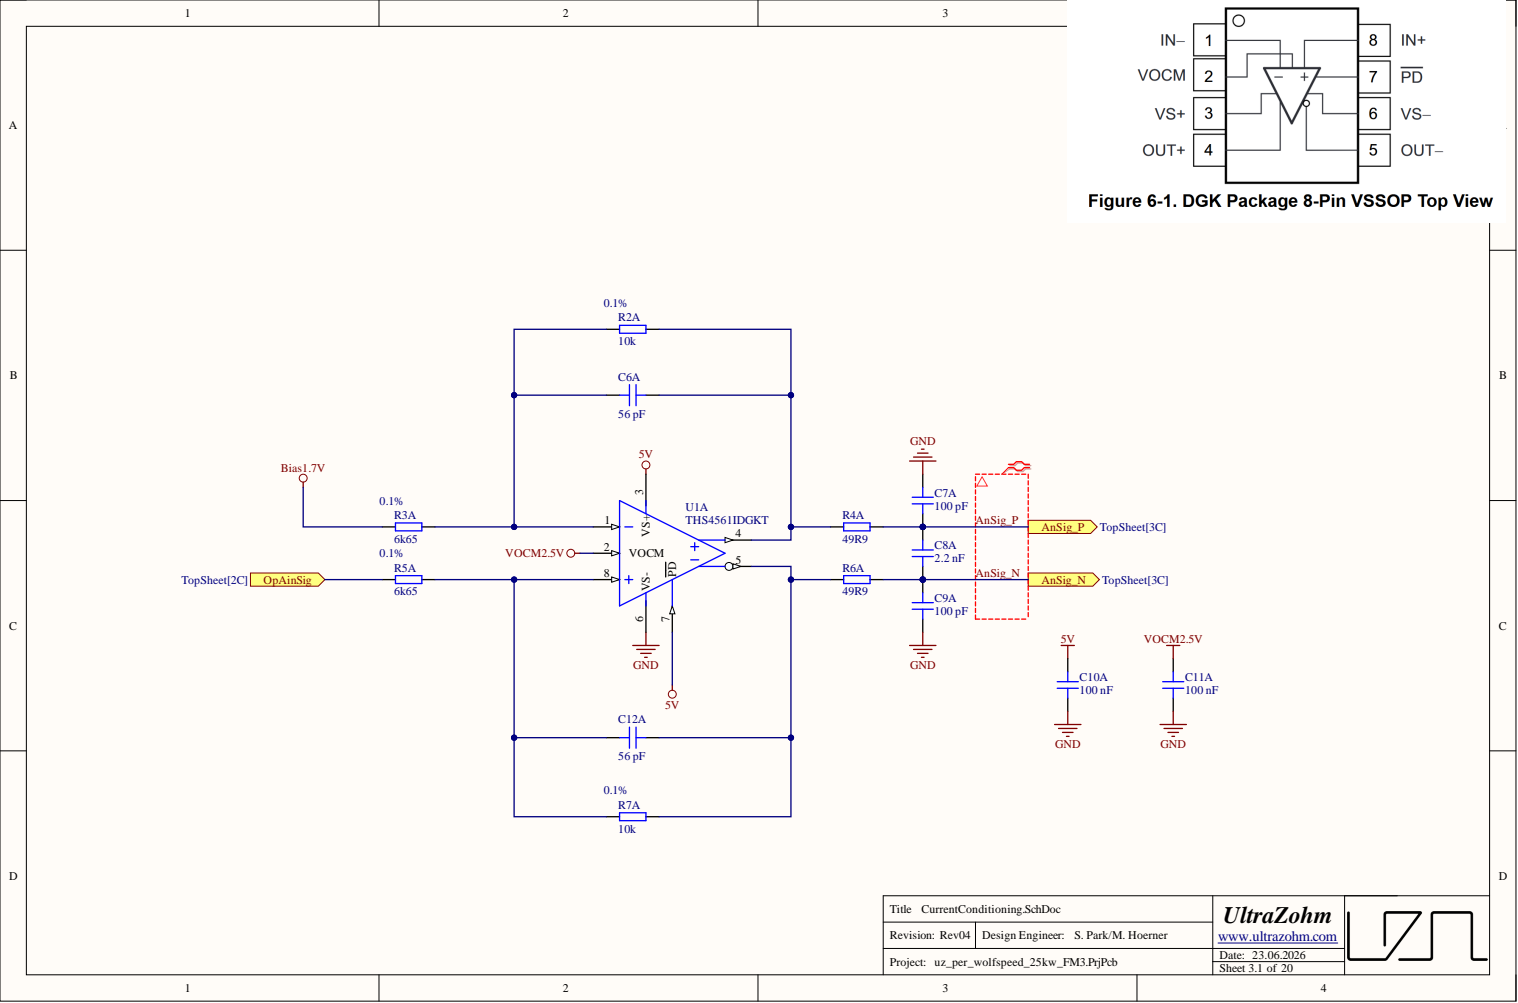
[picture p64: page 3]

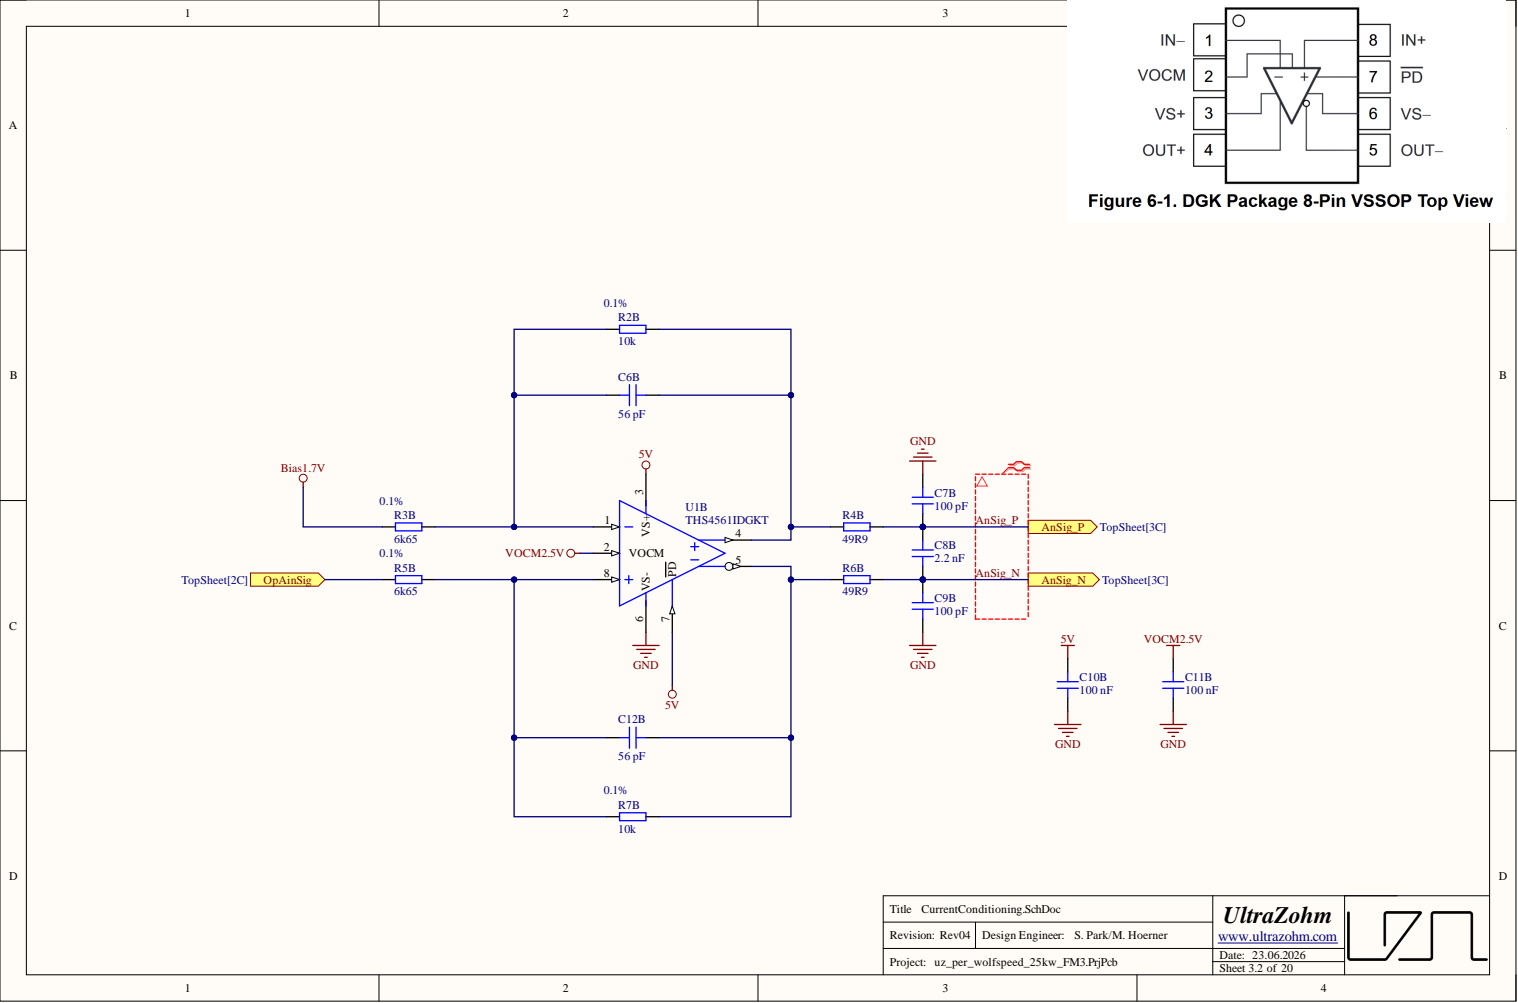
[picture p65: page 4]

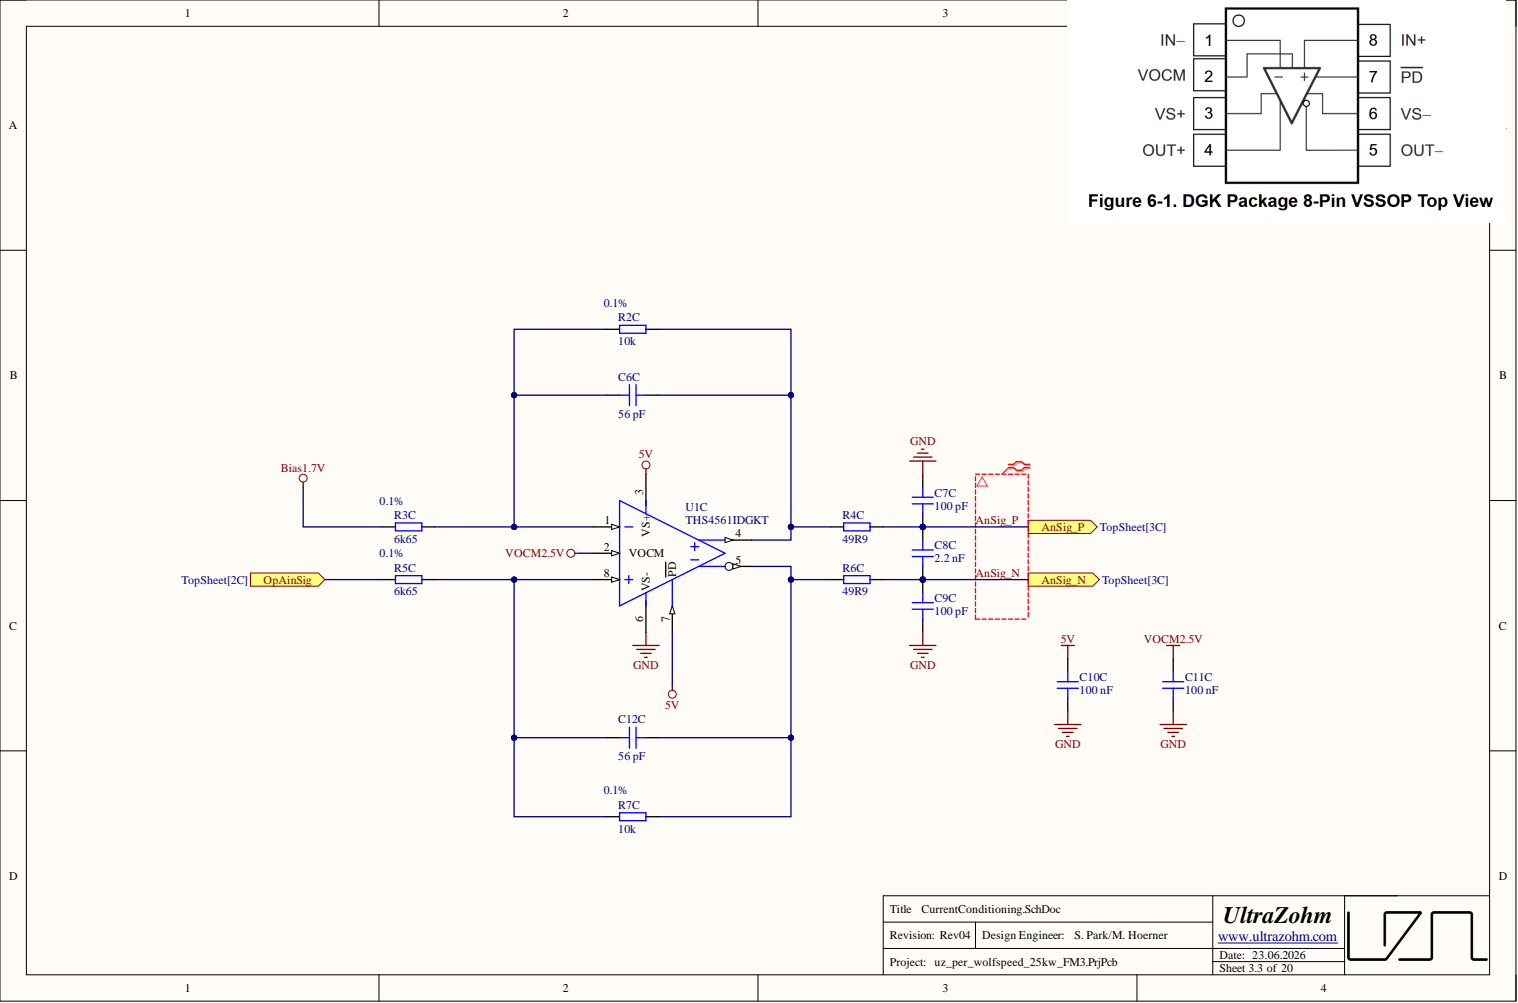
[picture p66: page 5]

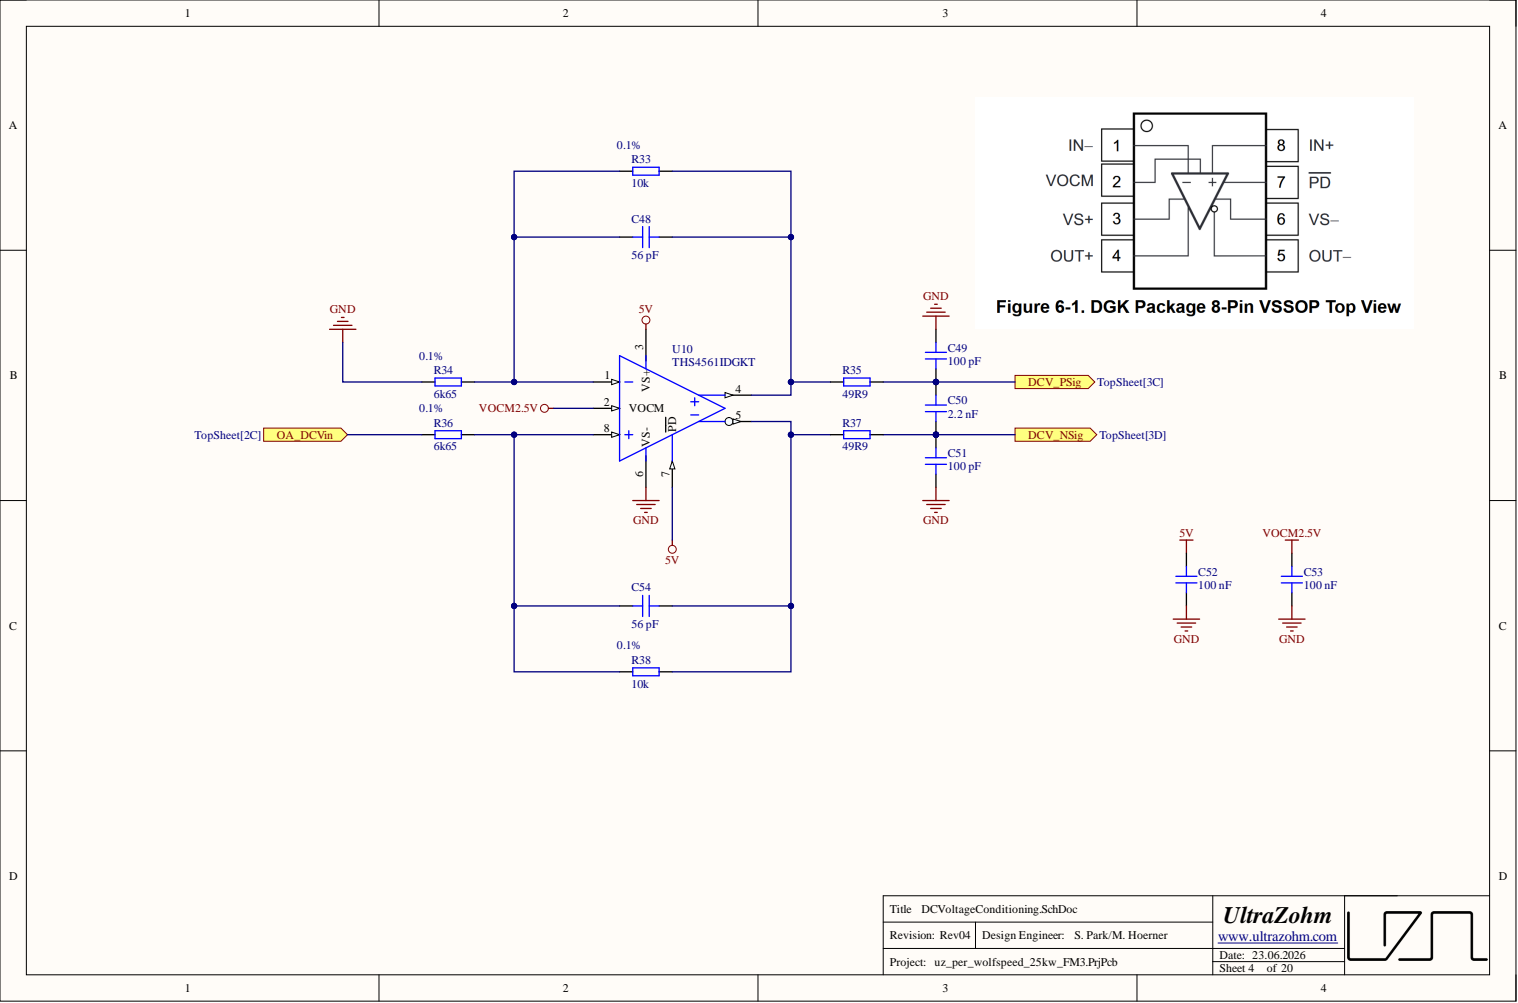
[picture p67: page 6]

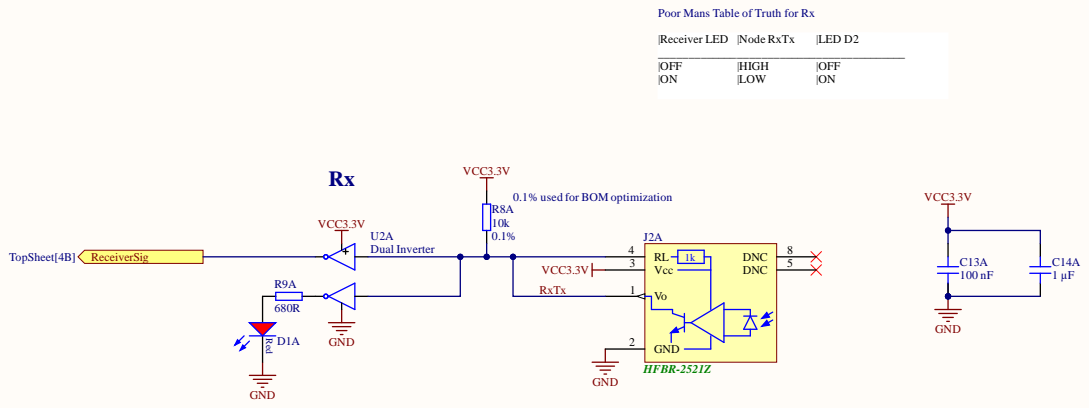
[picture p68: page 7]

Poor Mans Table of Truth for Rx

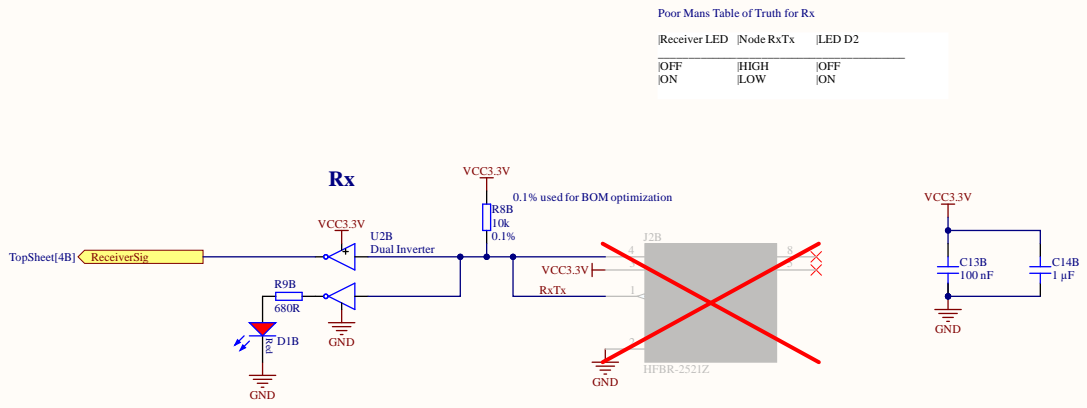
[picture p69: page 8]

Poor Mans Table of Truth for Rx

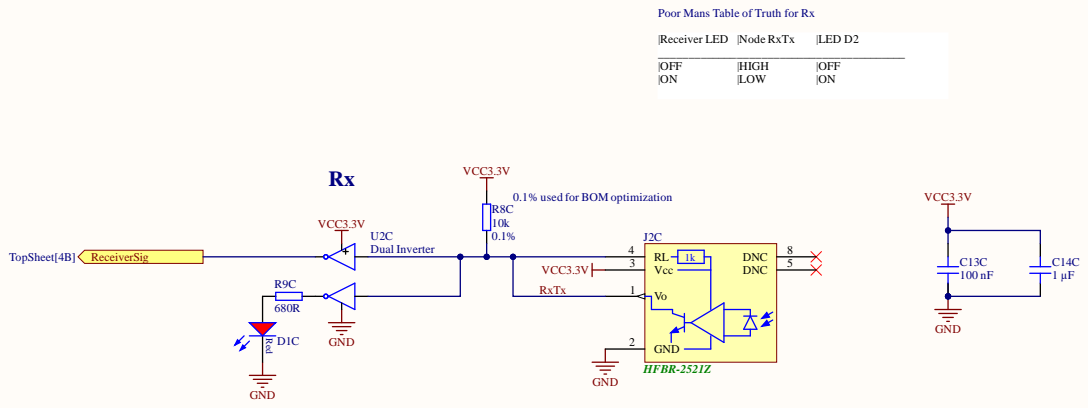
[picture p70: page 9]

Poor Mans Table of Truth for Rx

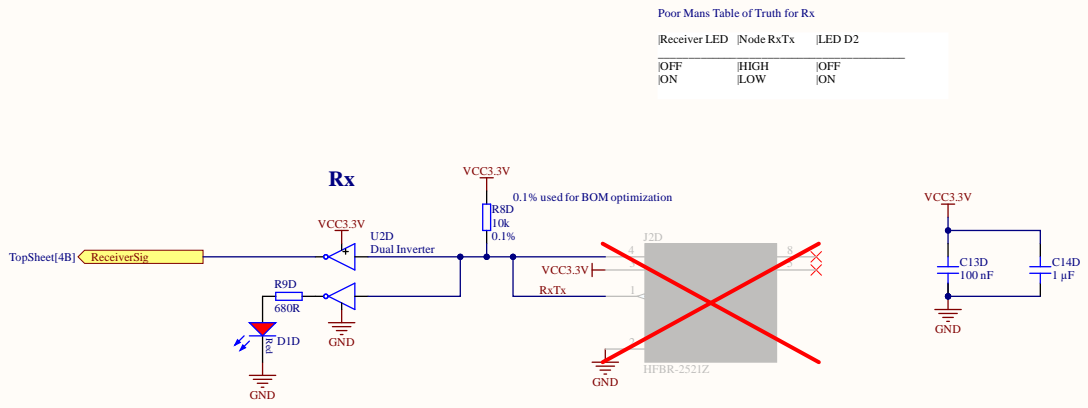
[picture p71: page 10]

Poor Mans Table of Truth for Rx

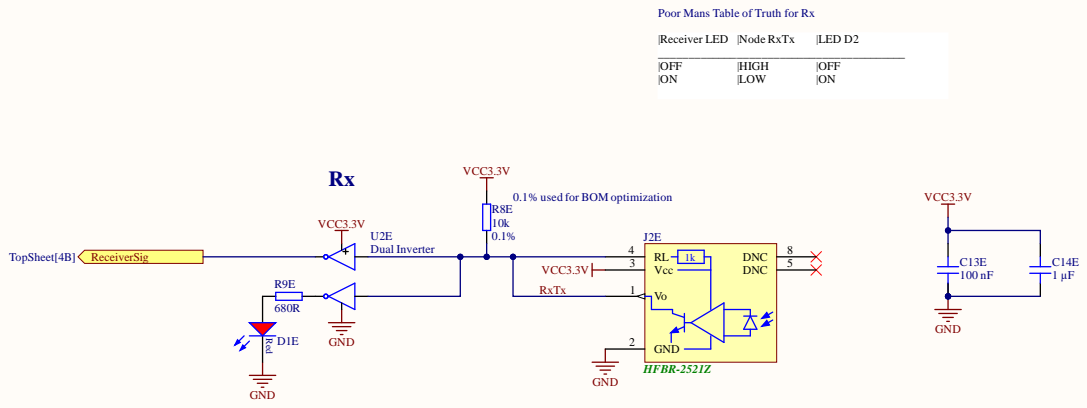
[picture p72: page 11]

Poor Mans Table of Truth for Rx

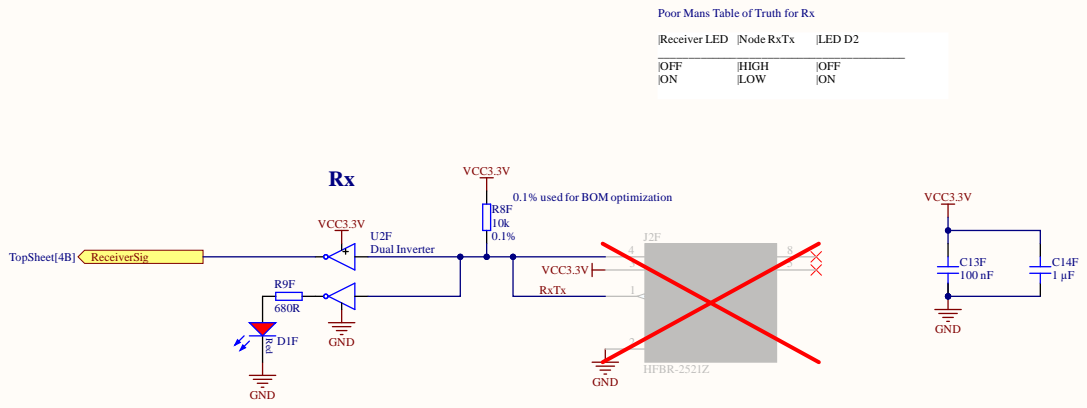
[picture p73: page 12]

Poor Mans Table of Truth for Rx

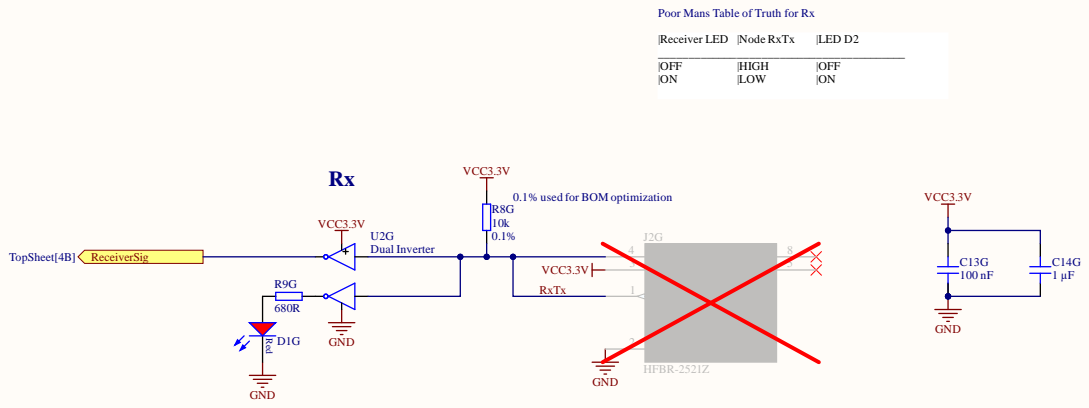
[picture p74: page 13]

Rev i s i o n :

Dat e : .

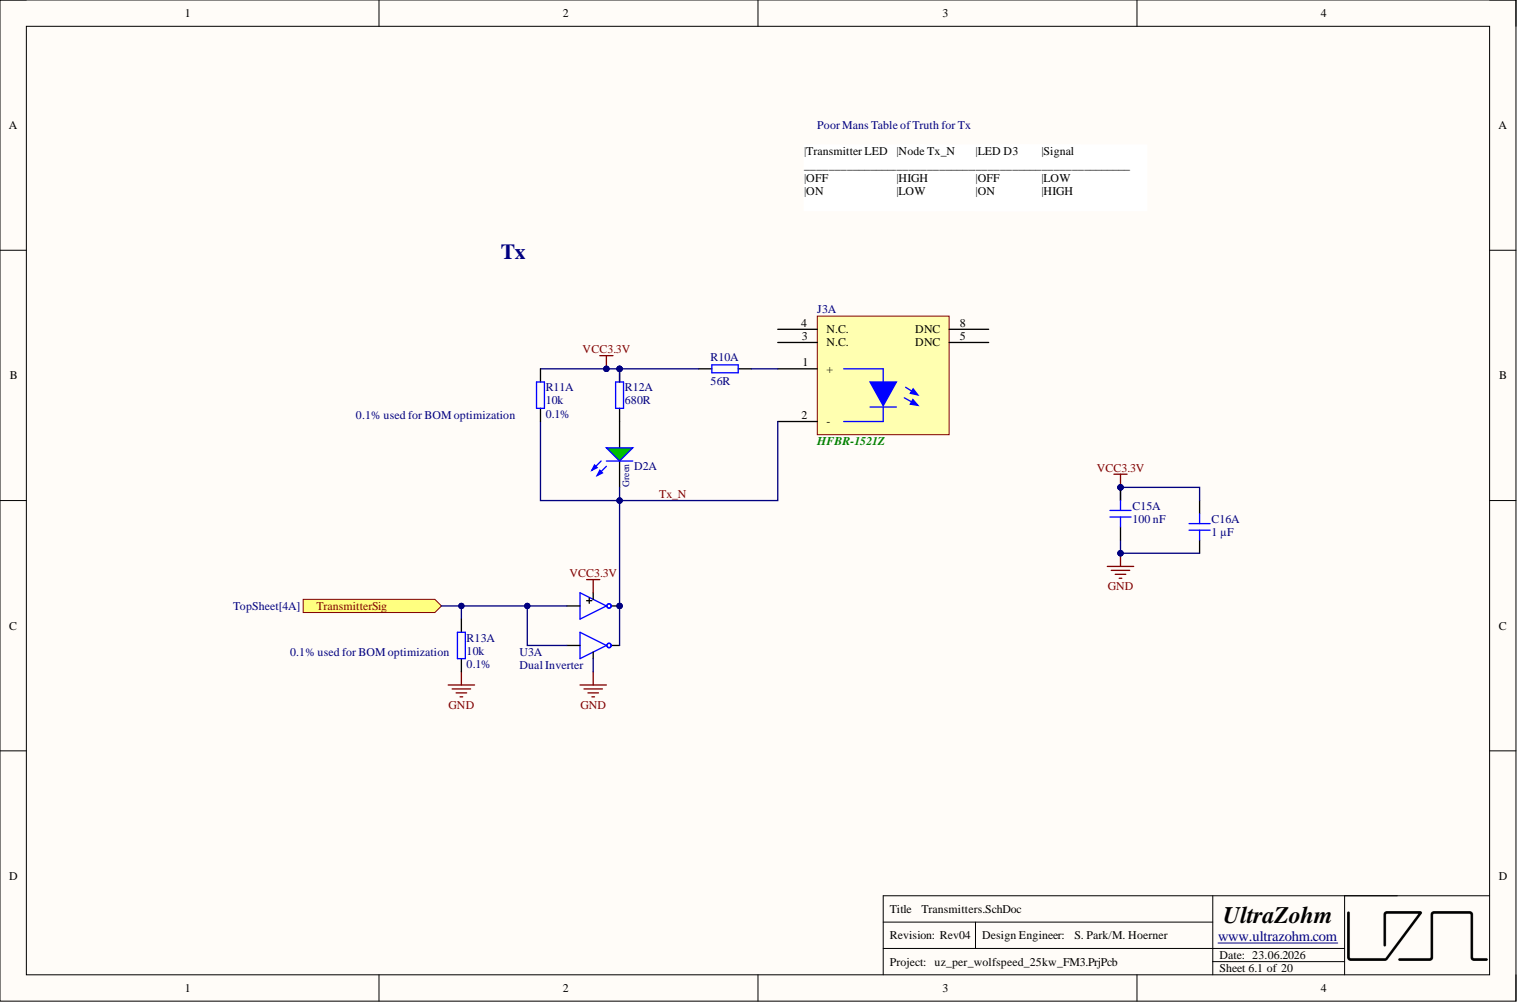
[picture p75: page 14]

Poor Mans Table of Truth for Tx

0.1% used for BOM optimization

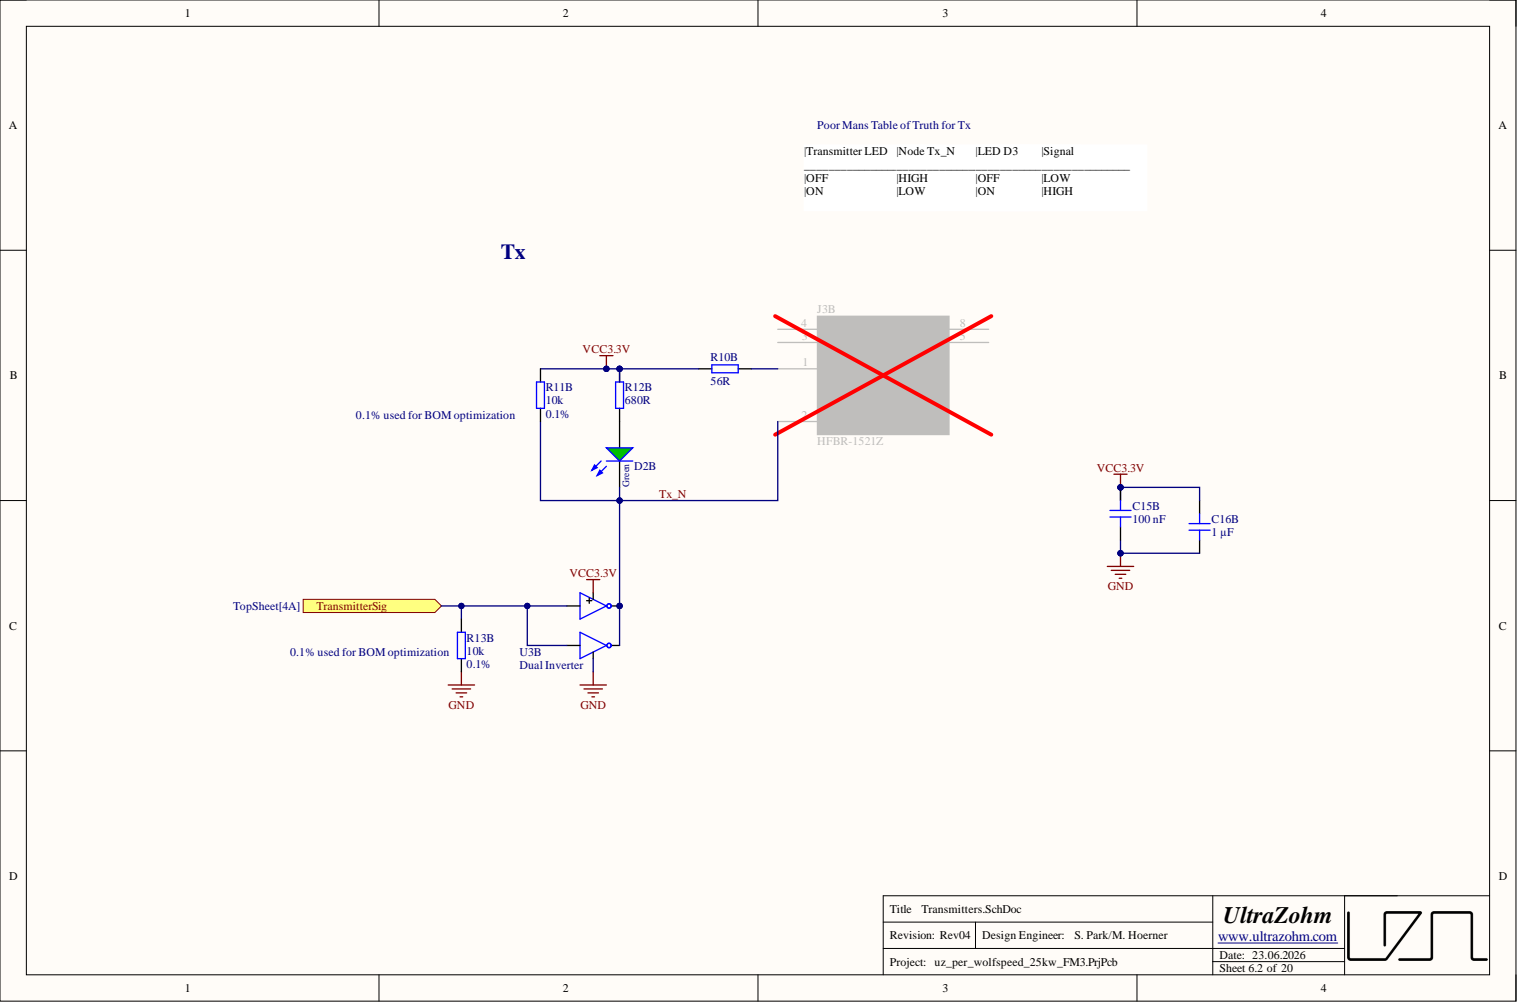
[picture p76: page 15]

Rev i s i o n :

Dat e : .

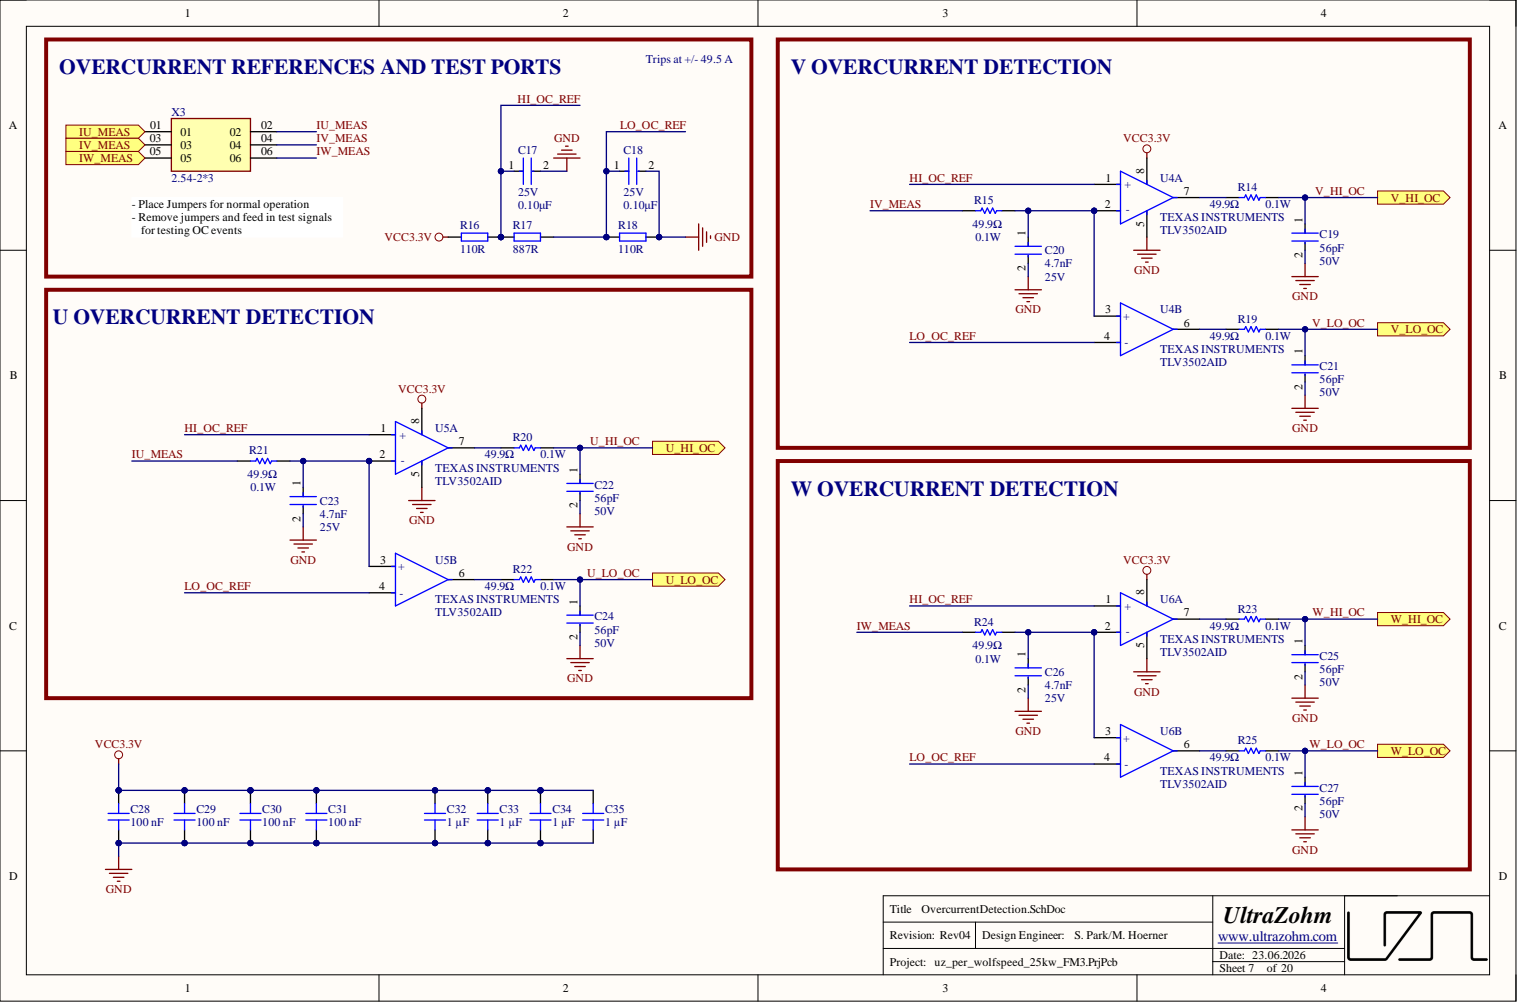
[picture p77: page 16]

OVERCURRENT REFERENCES AND TEST PORTS

- Place Jumpers for normal operation
- Remove jumpers and feed in test signals
for testing OC events

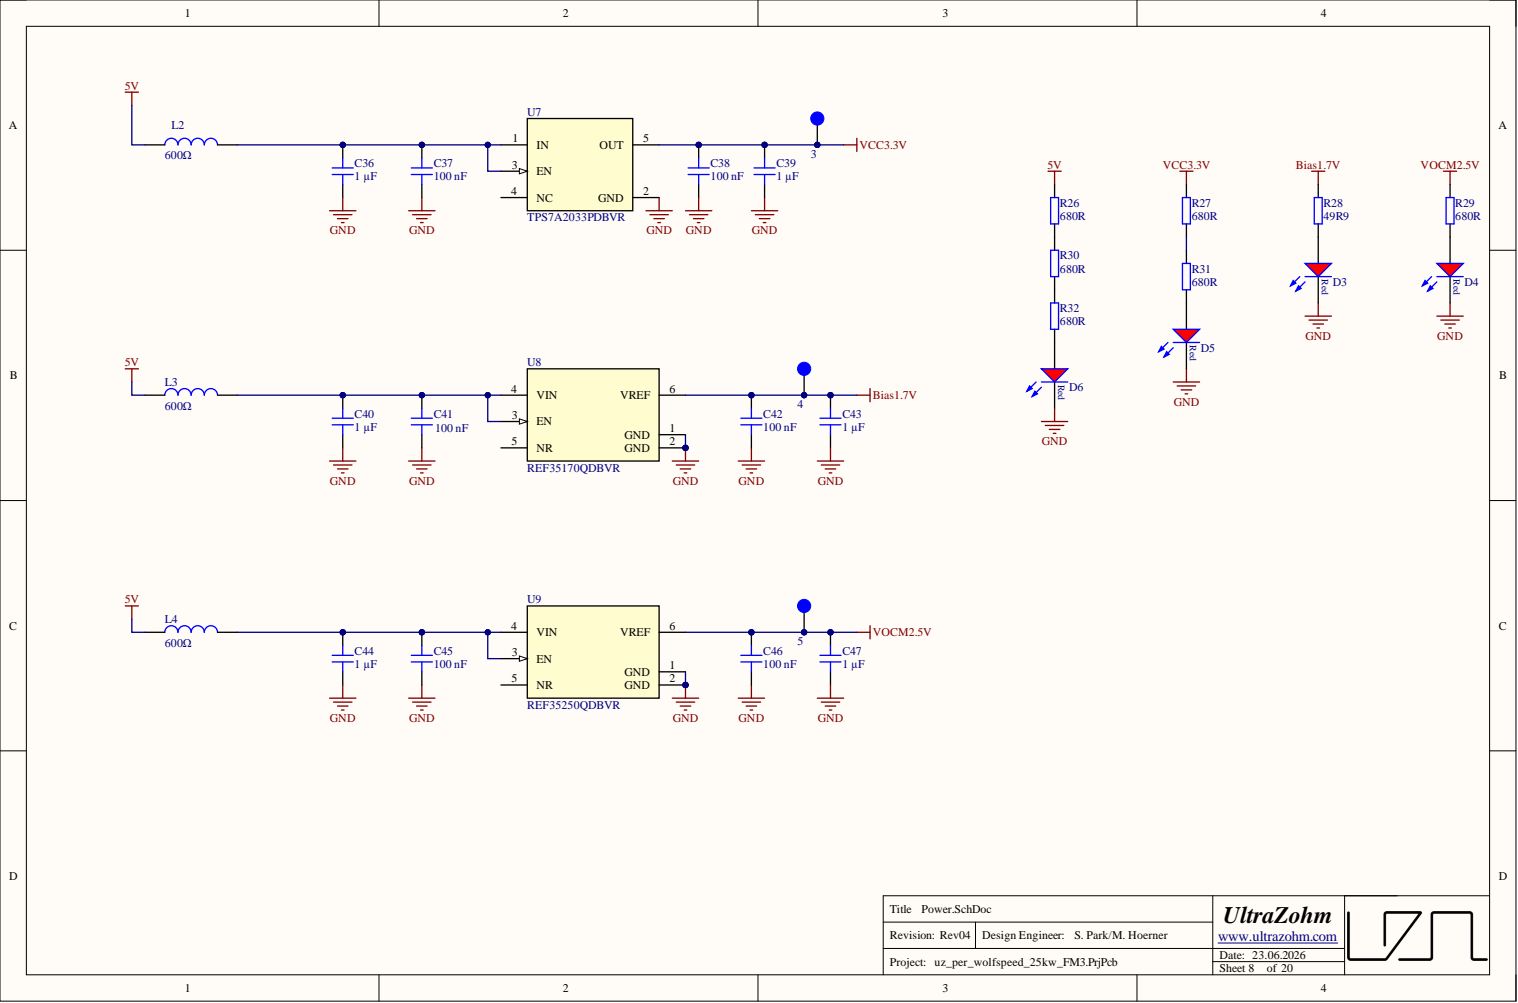
[picture p78: page 17]

Rev i s i o n :

Dat e : .

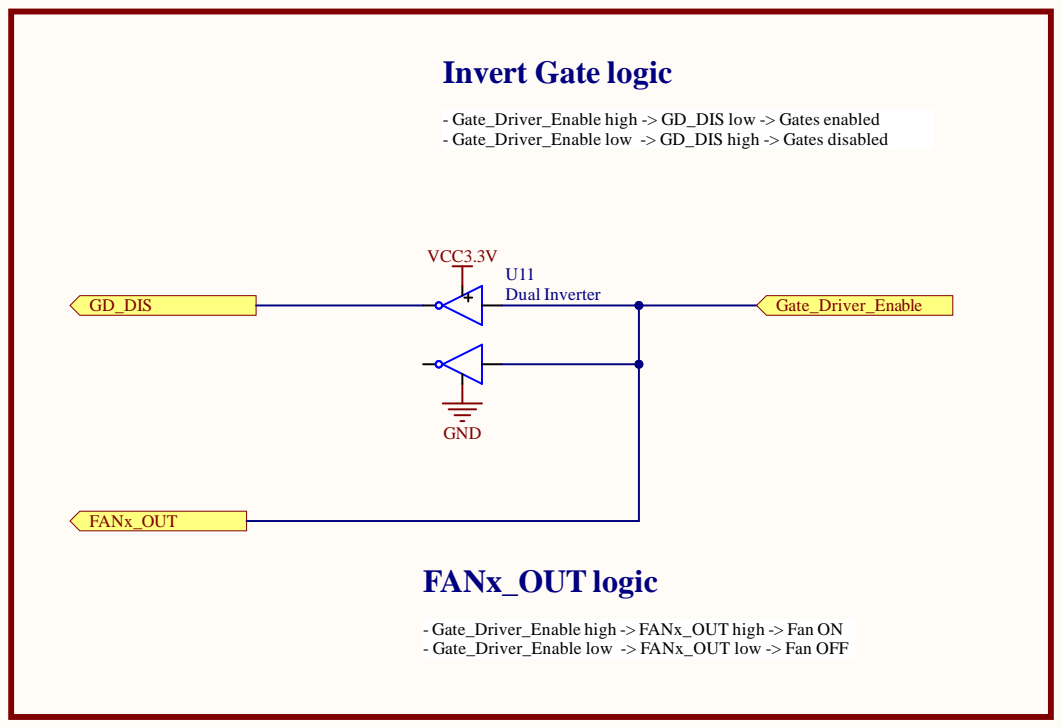
[picture p79: page 18]

- Gate_Driver_Enable high -> GD_DIS low -> Gates enabled
- Gate_Driver_Enable low -> GD_DIS high -> Gates disabled

- Gate_Driver_Enable high -> FANx_OUT high -> Fan ON
- Gate_Driver_Enable low -> FANx_OUT low -> Fan OFF

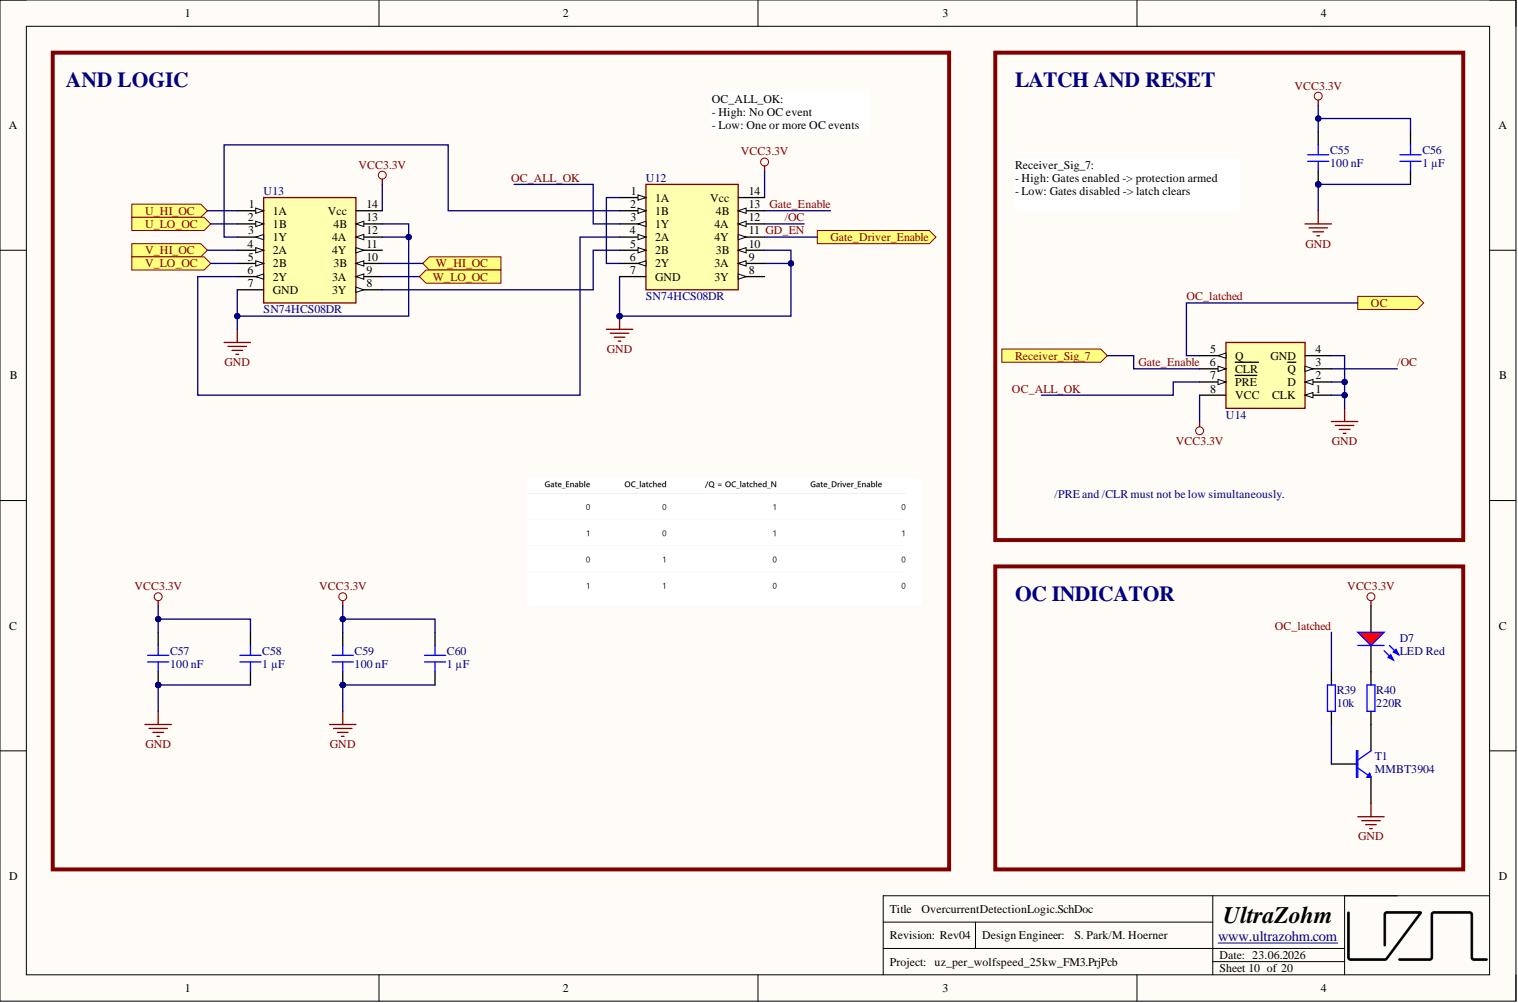
[picture p80: page 19]

OC_ALL_OK:
- High: No OC event
- Low: One or more OC events

Receiver_Sig_7:
- High: Gates enabled -> protection armed
- Low: Gates disabled -> latch clears

/PRE and /CLR must not be low simultaneously.

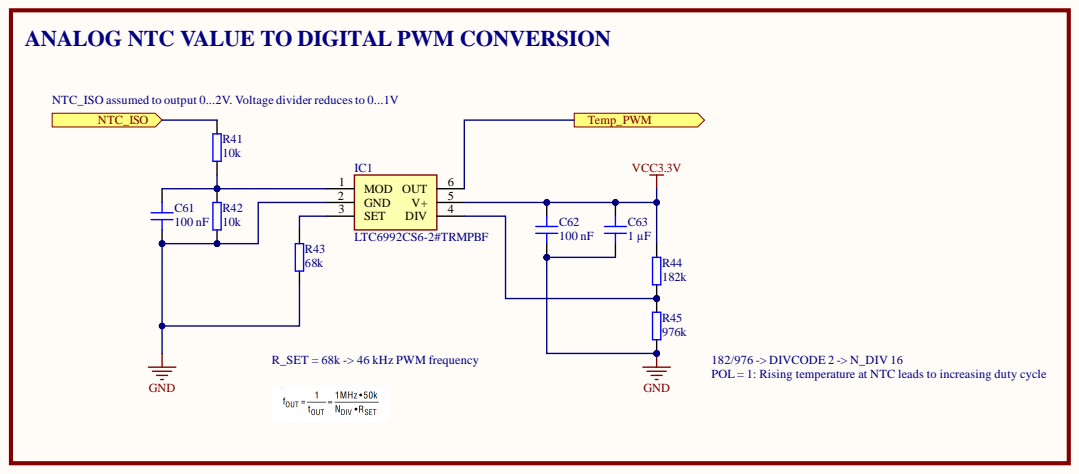
[picture p81: page 20]

TO DIGITAL PWM CONVERSION

Rev i s i o n :

Dat e : .
