ultrazohm/uz_per_wolfspeed_25kw_fm3/Altium/Project Outputs for uz_per_wolfspeed_25kw_FM3/Rev03/SCH_uz_per_wolfspeed_25kw_FM3_jlc_Rev03.PDF

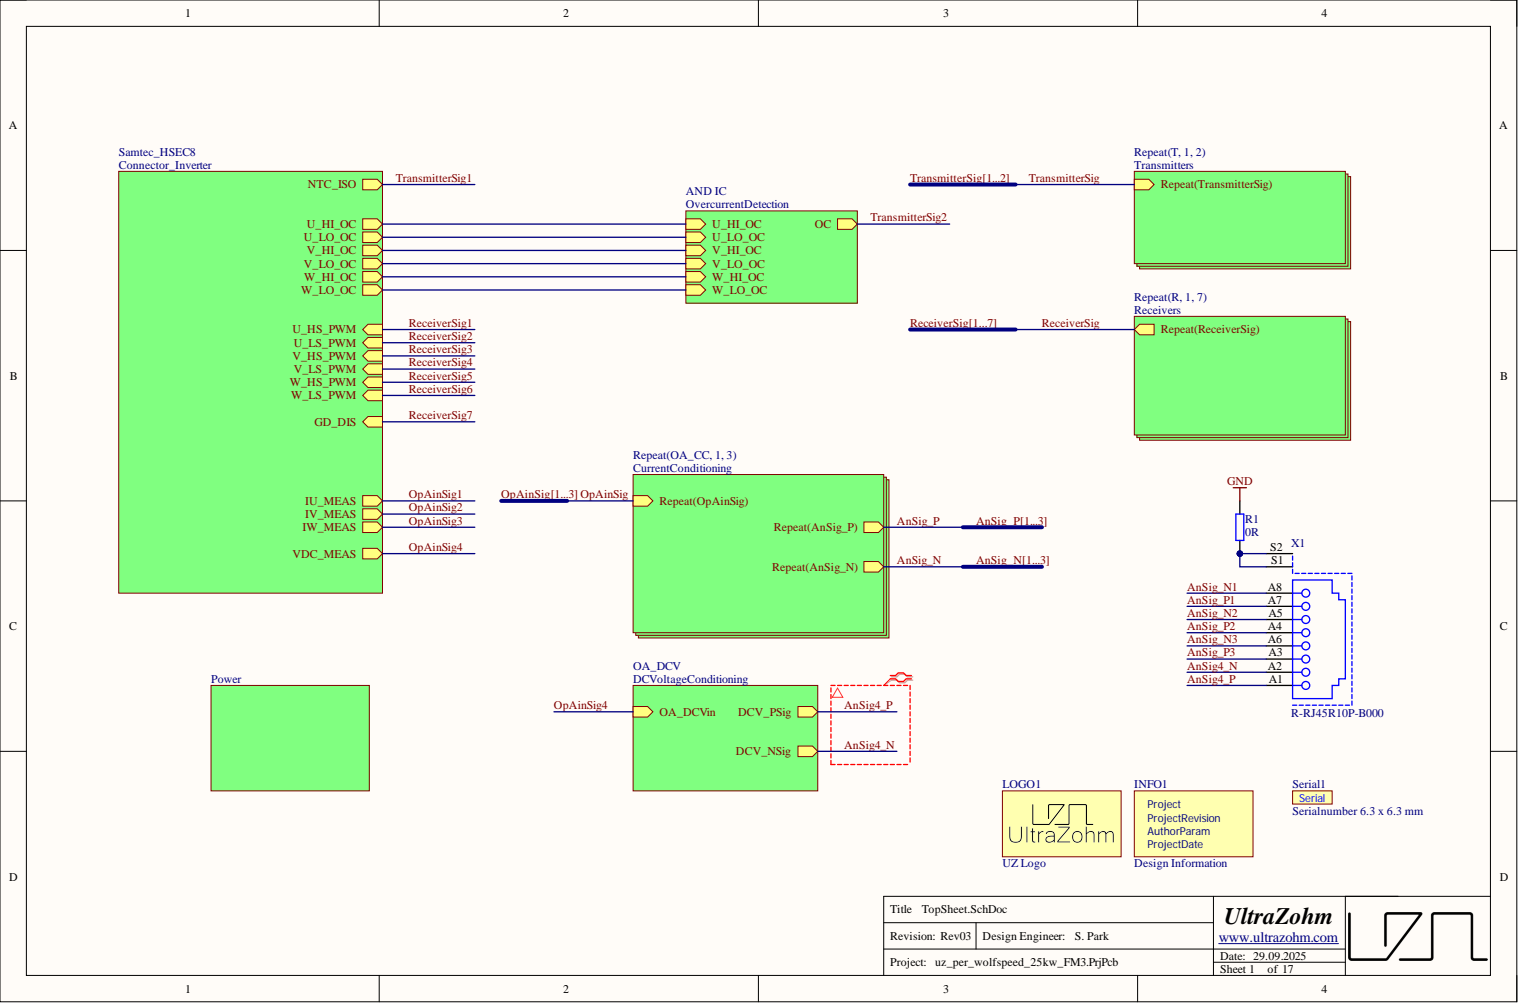
[picture p82: page 1]

Revision:

Date: 29.09.2025

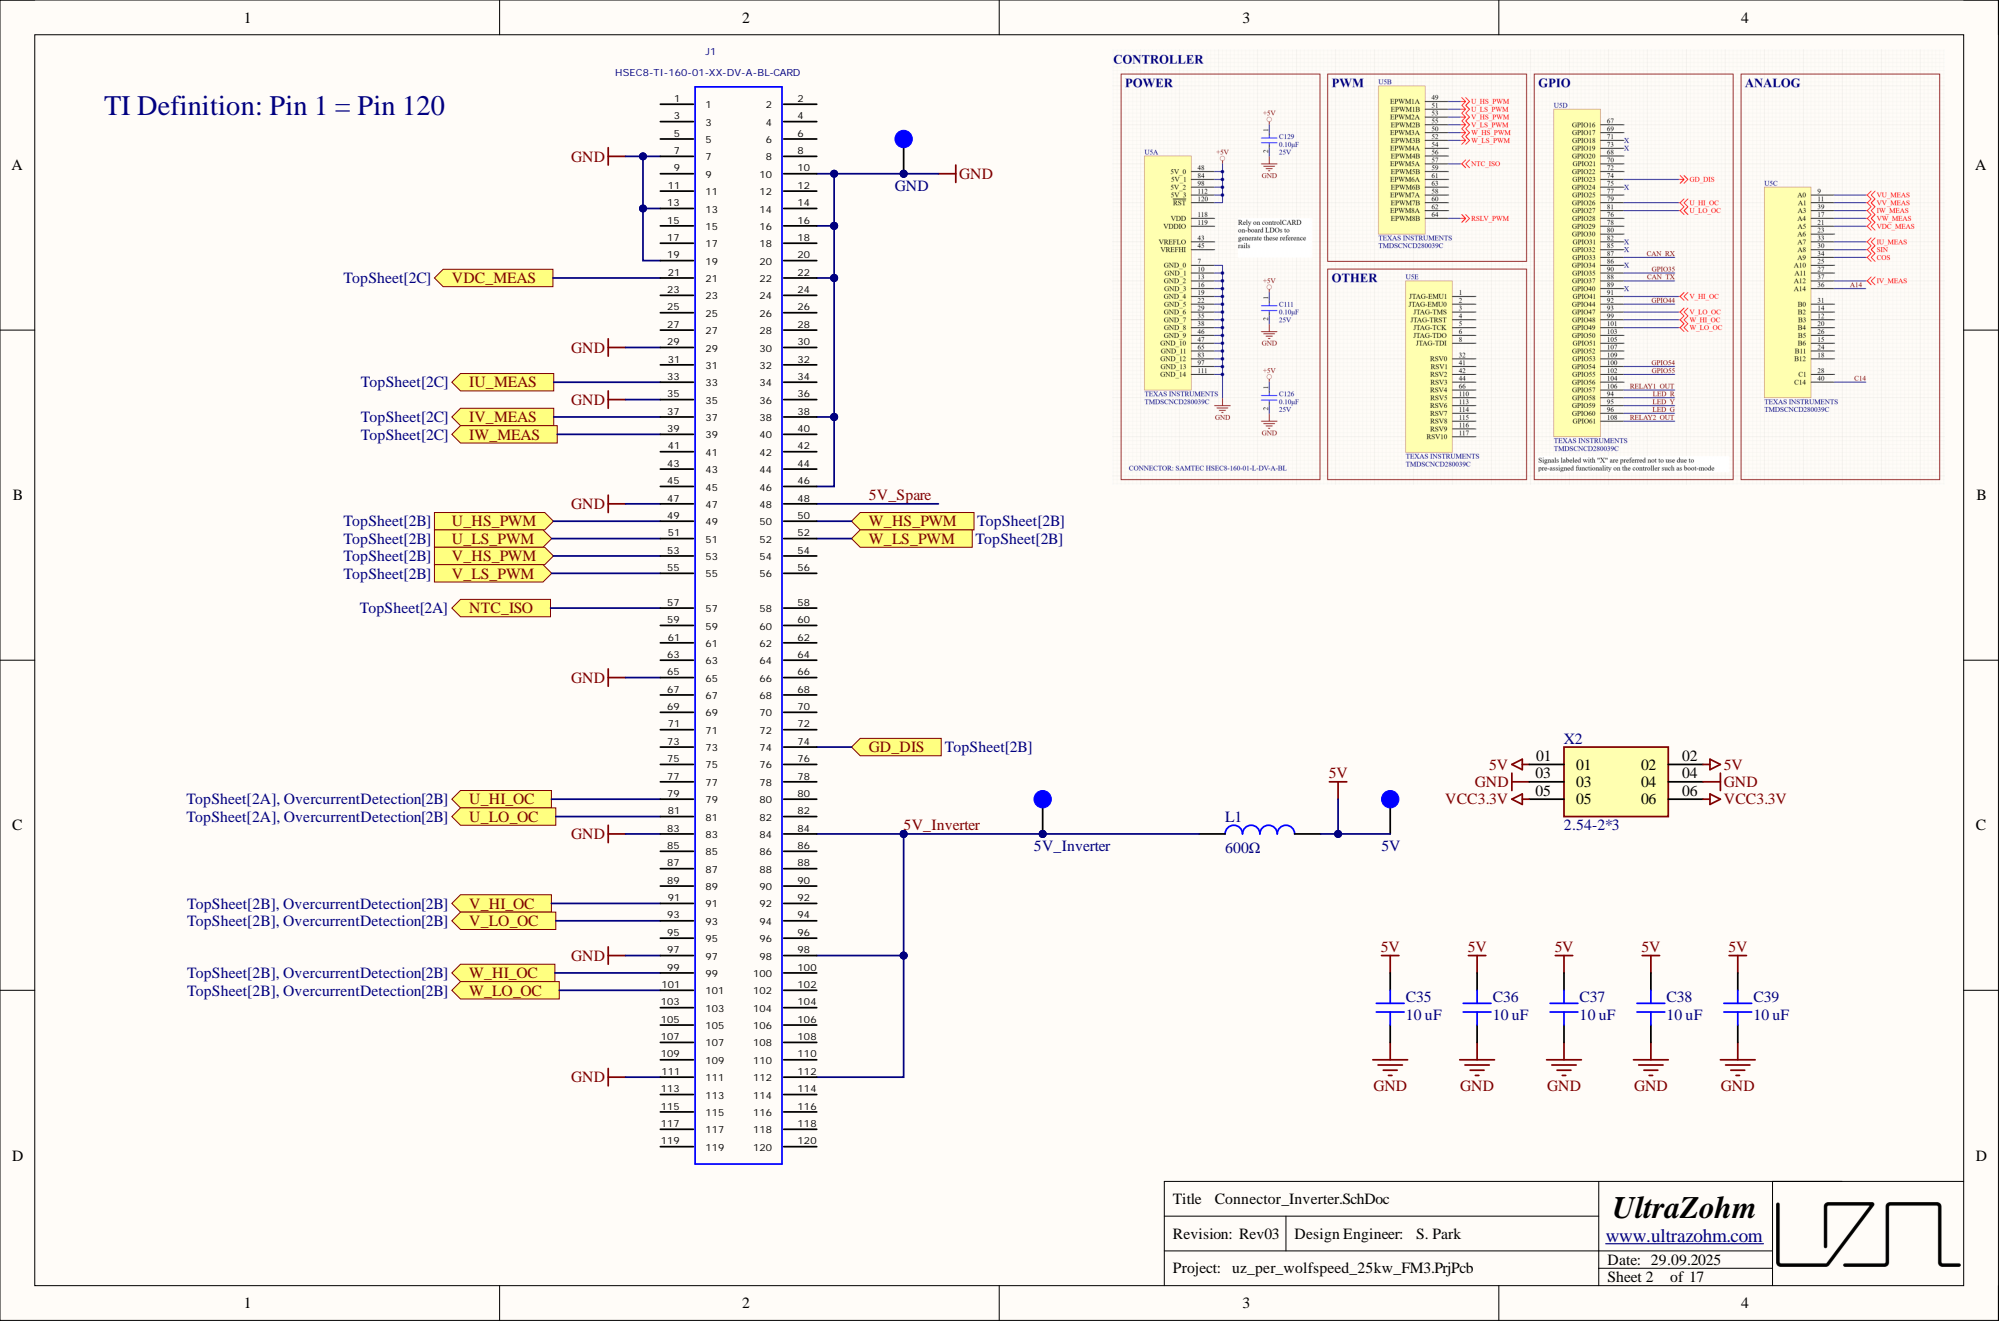
[picture p83: page 2]

HSEC8-TI-160-01-XX-DV-A-BL-CARD

TI Definition: Pin 1 = Pin 120

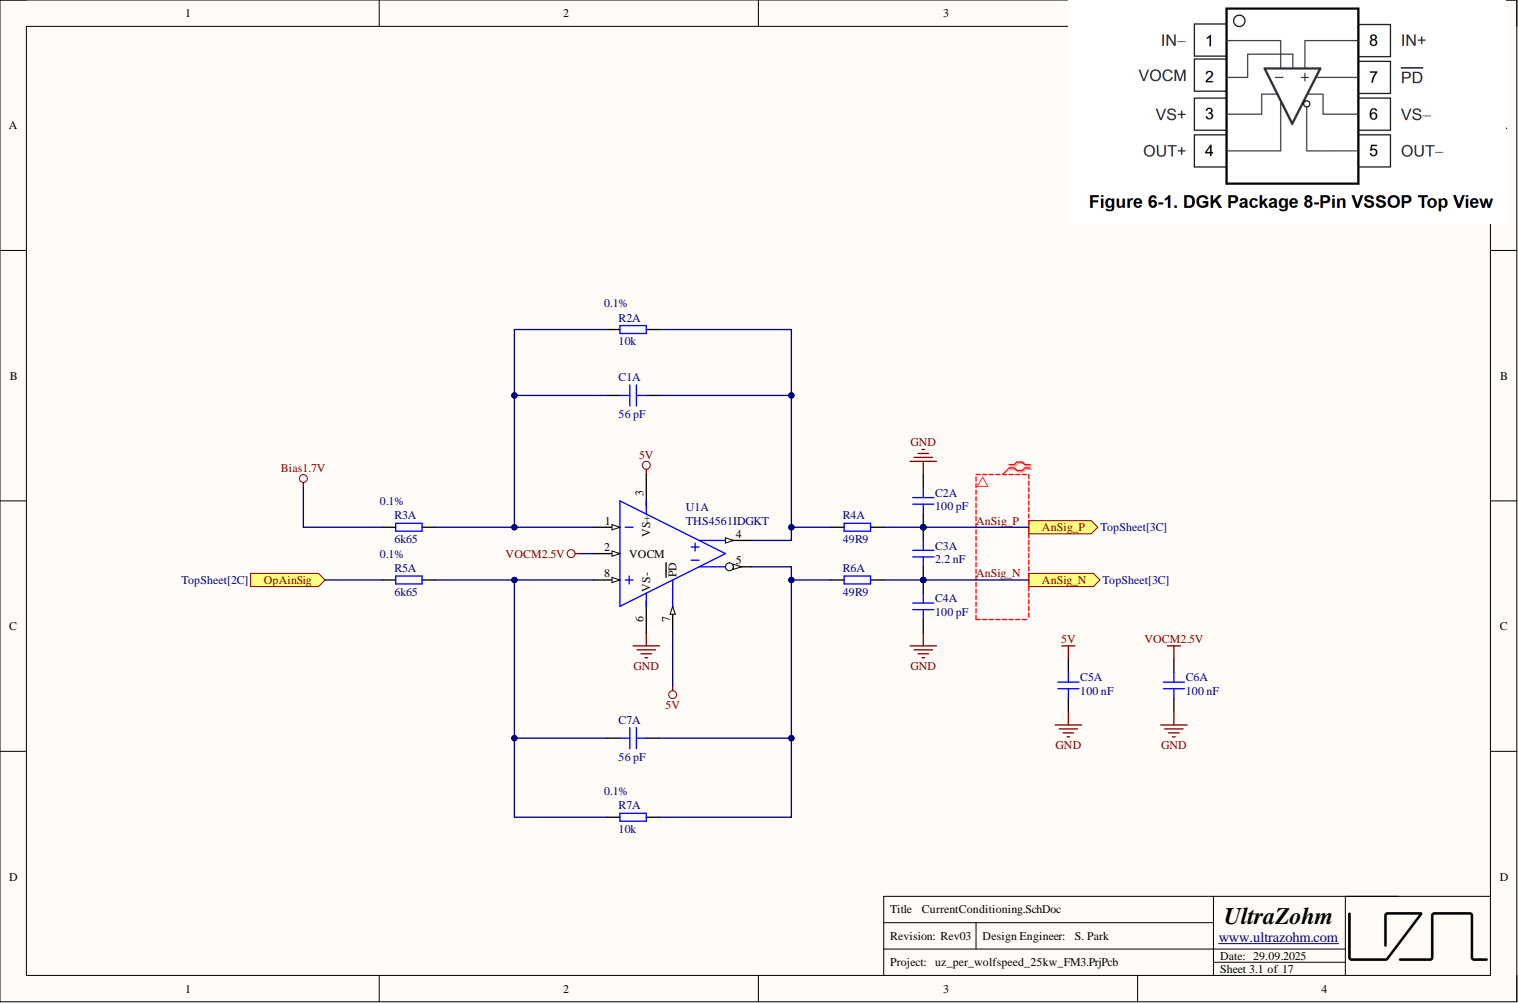
[picture p84: page 3]

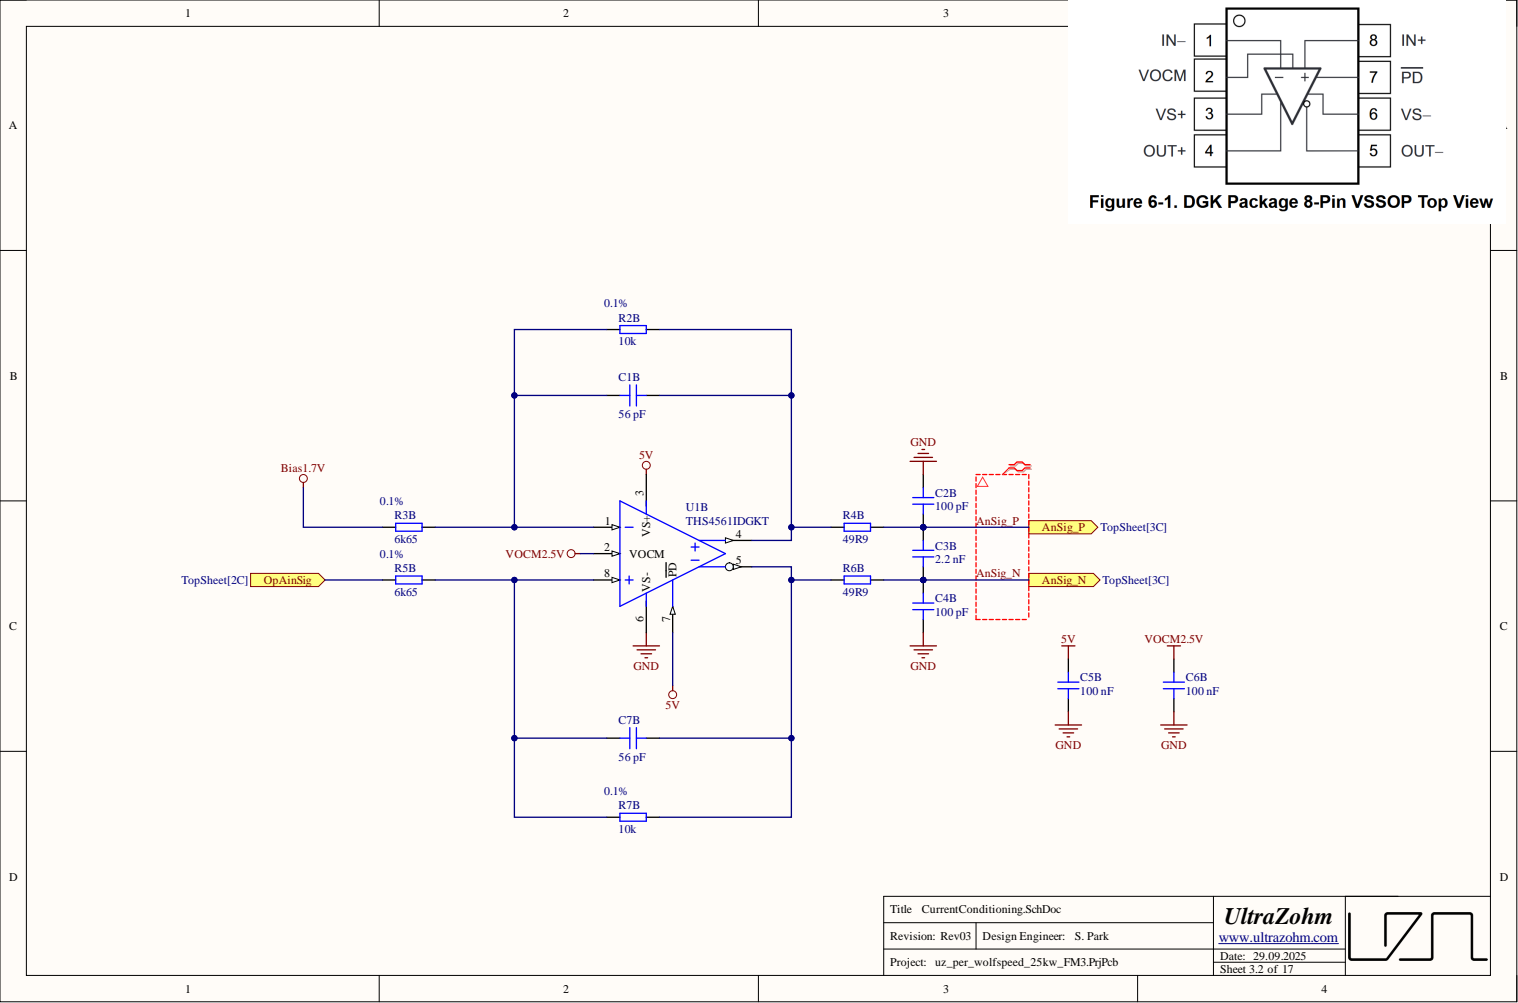
[picture p85: page 4]

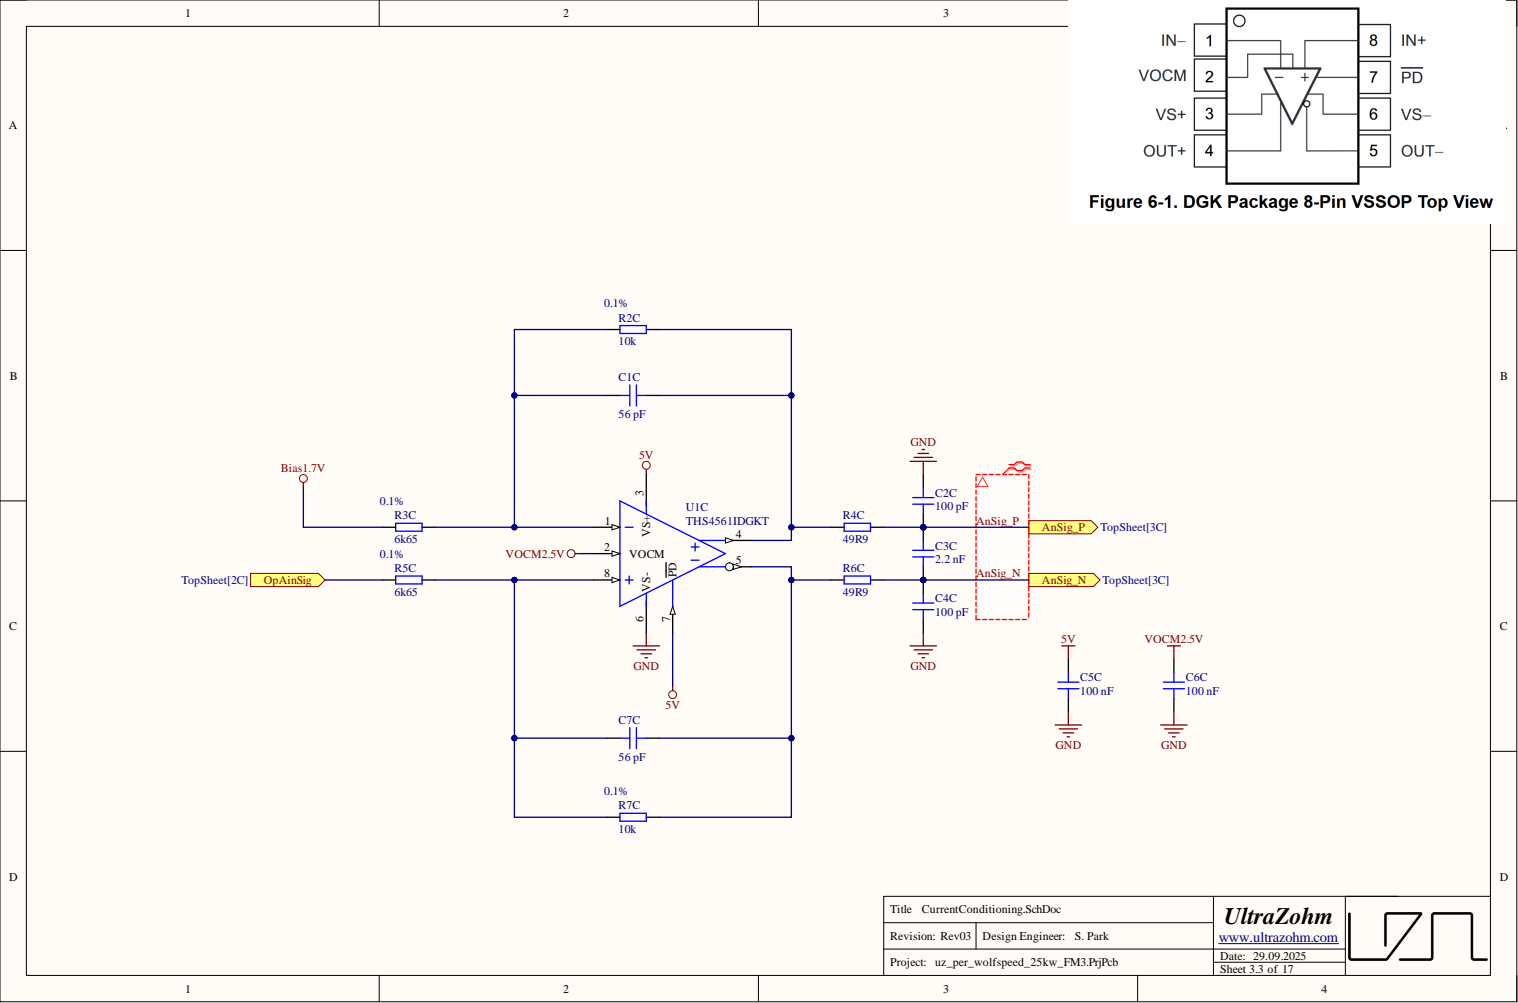
[picture p86: page 5]

Rev i s i o n :

Dat e : .

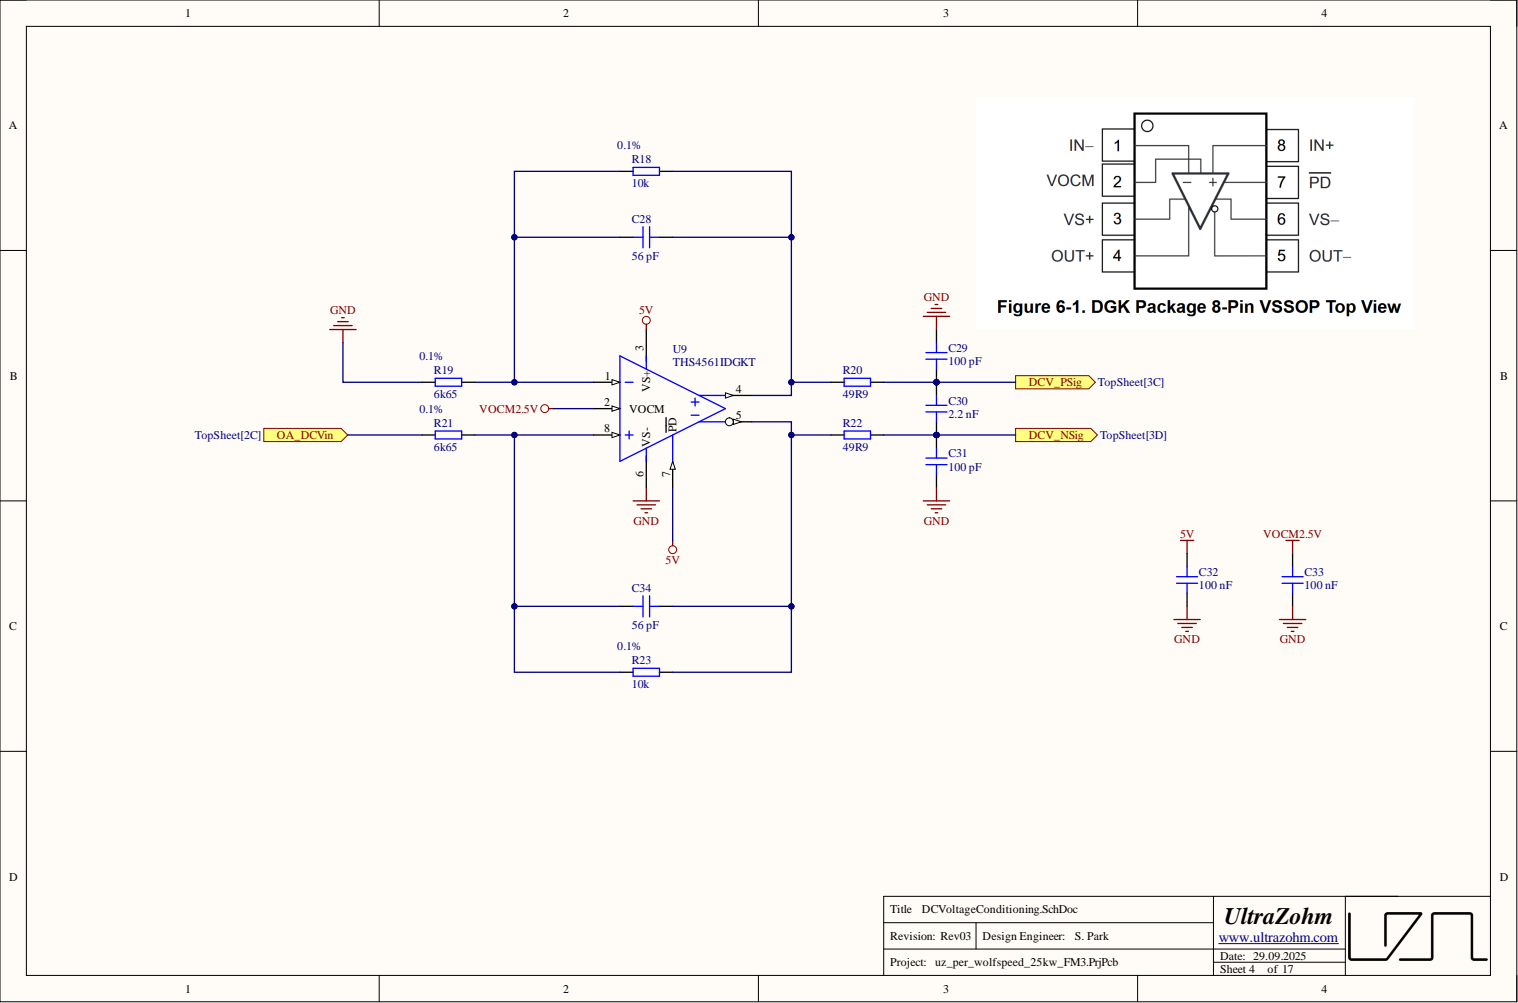
[picture p87: page 6]

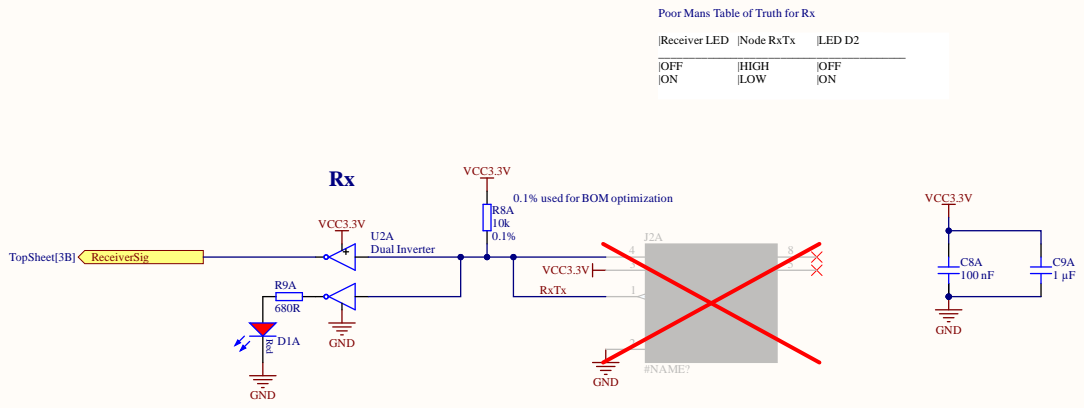
[picture p88: page 7]

Poor Mans Table of Truth for Rx

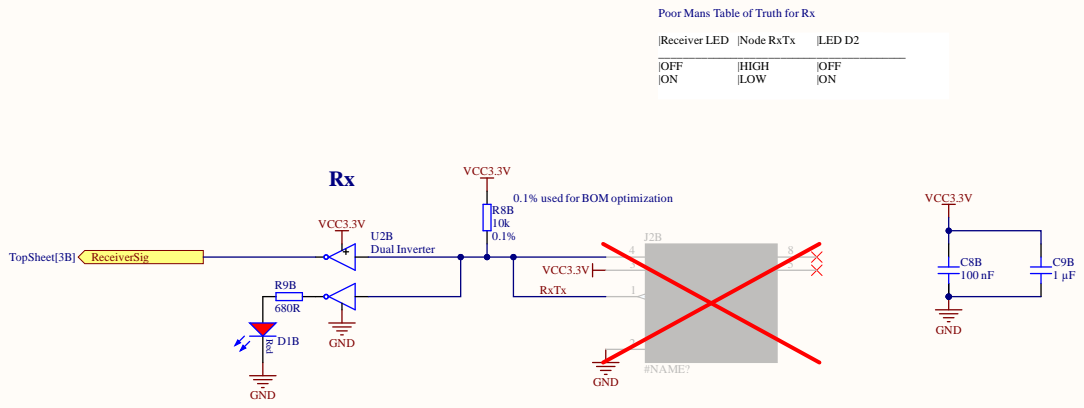
[picture p89: page 8]

Poor Mans Table of Truth for Rx

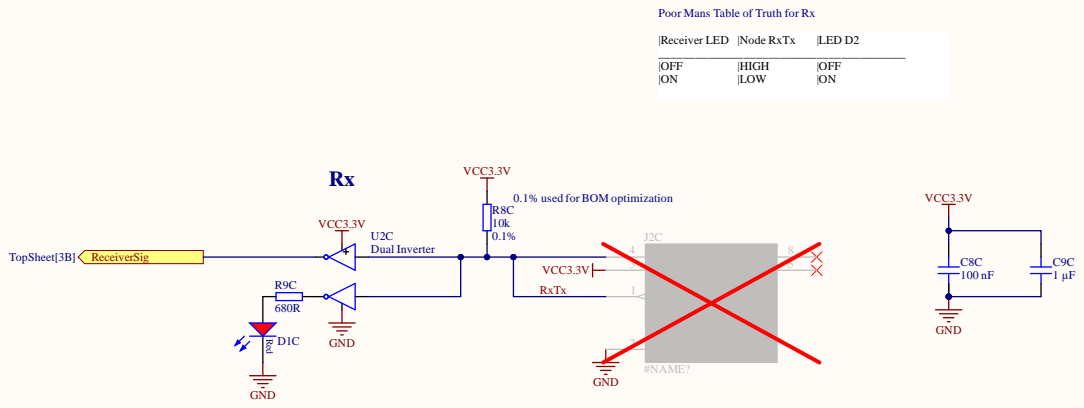
[picture p90: page 9]

Poor Mans Table of Truth for Rx

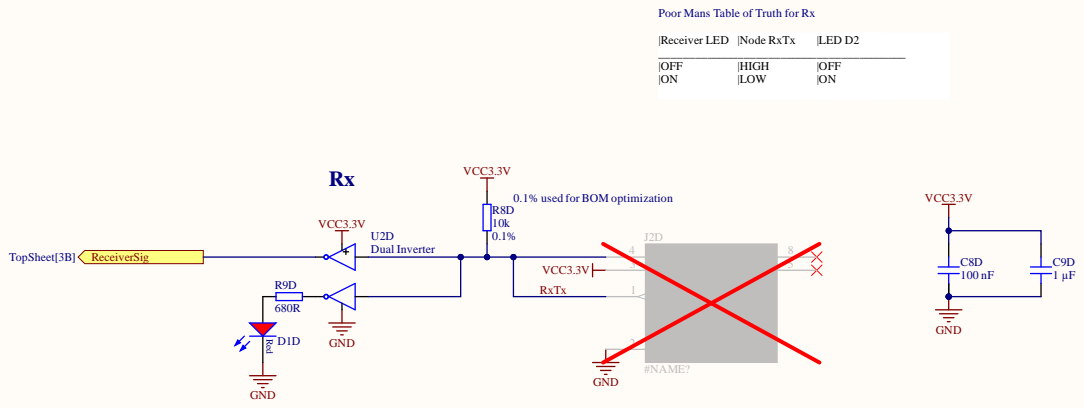
[picture p91: page 10]

Poor Mans Table of Truth for Rx

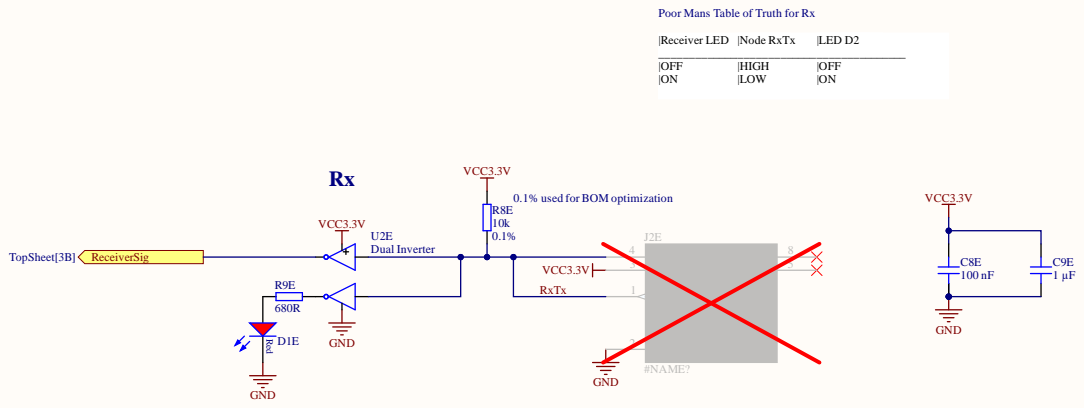
[picture p92: page 11]

Poor Mans Table of Truth for Rx

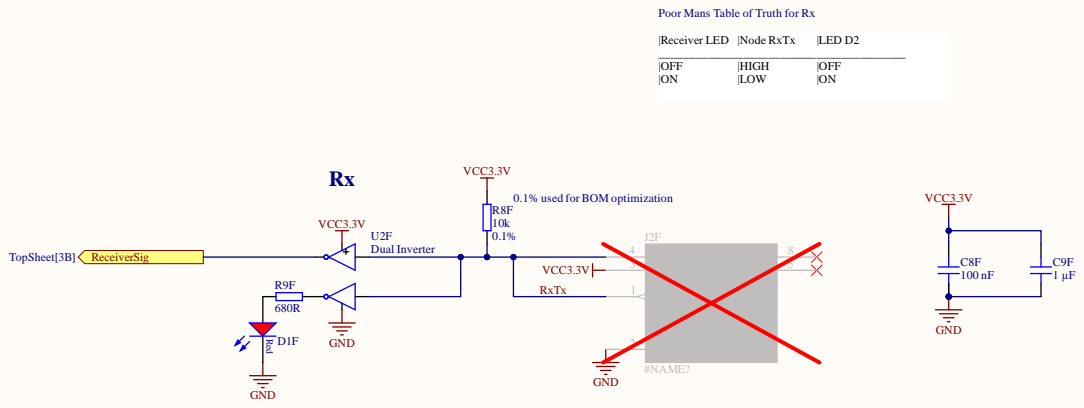
[picture p93: page 12]

Poor Mans Table of Truth for Rx

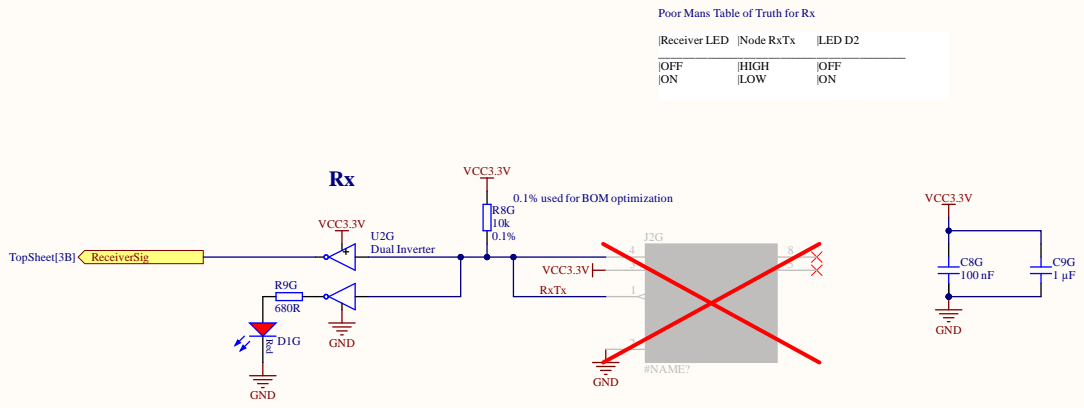
[picture p94: page 13]

Rev i s i o n :

Dat e : .

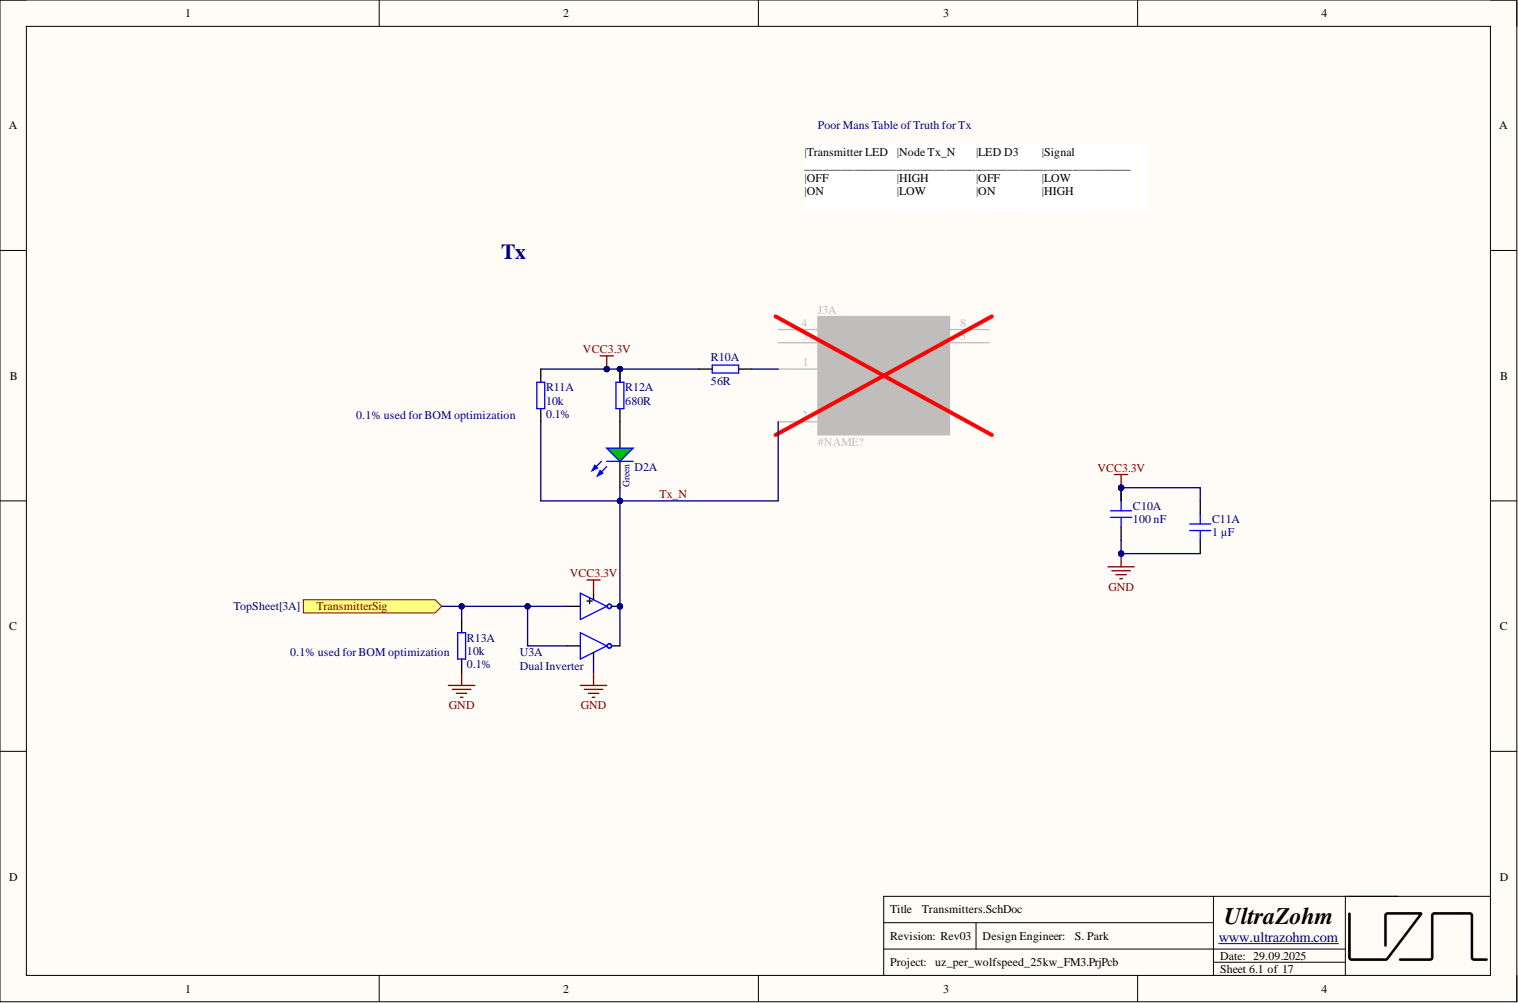
[picture p95: page 14]

Poor Mans Table of Truth for Tx

0.1% used for BOM optimization

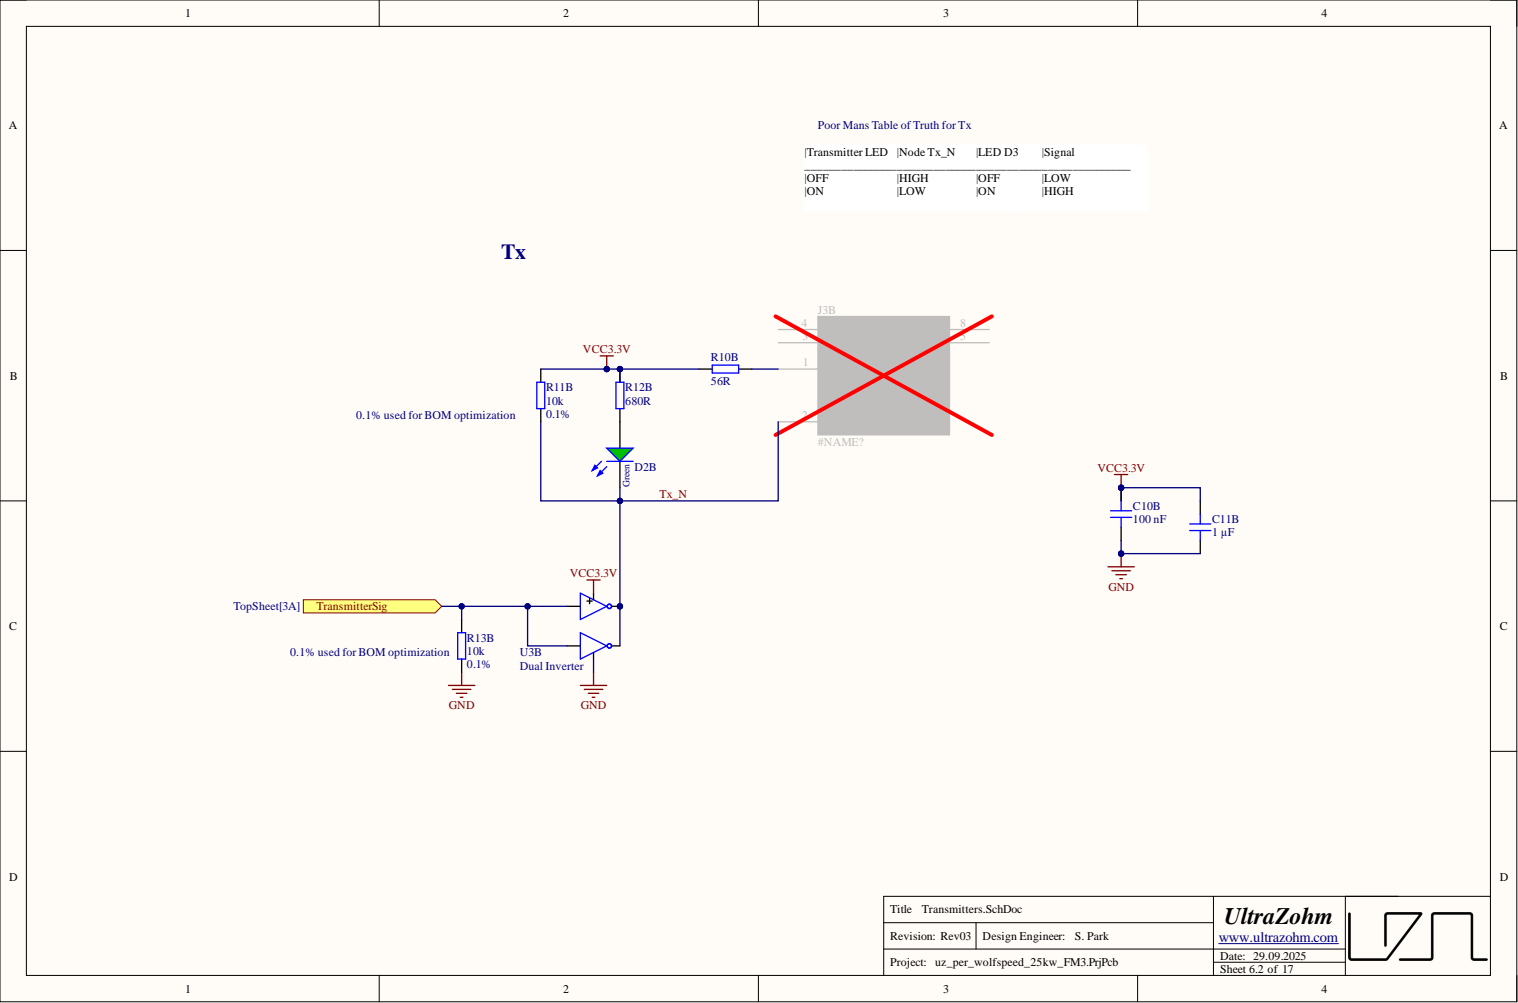
[picture p96: page 15]

Rev i s i o n :

Dat e : .

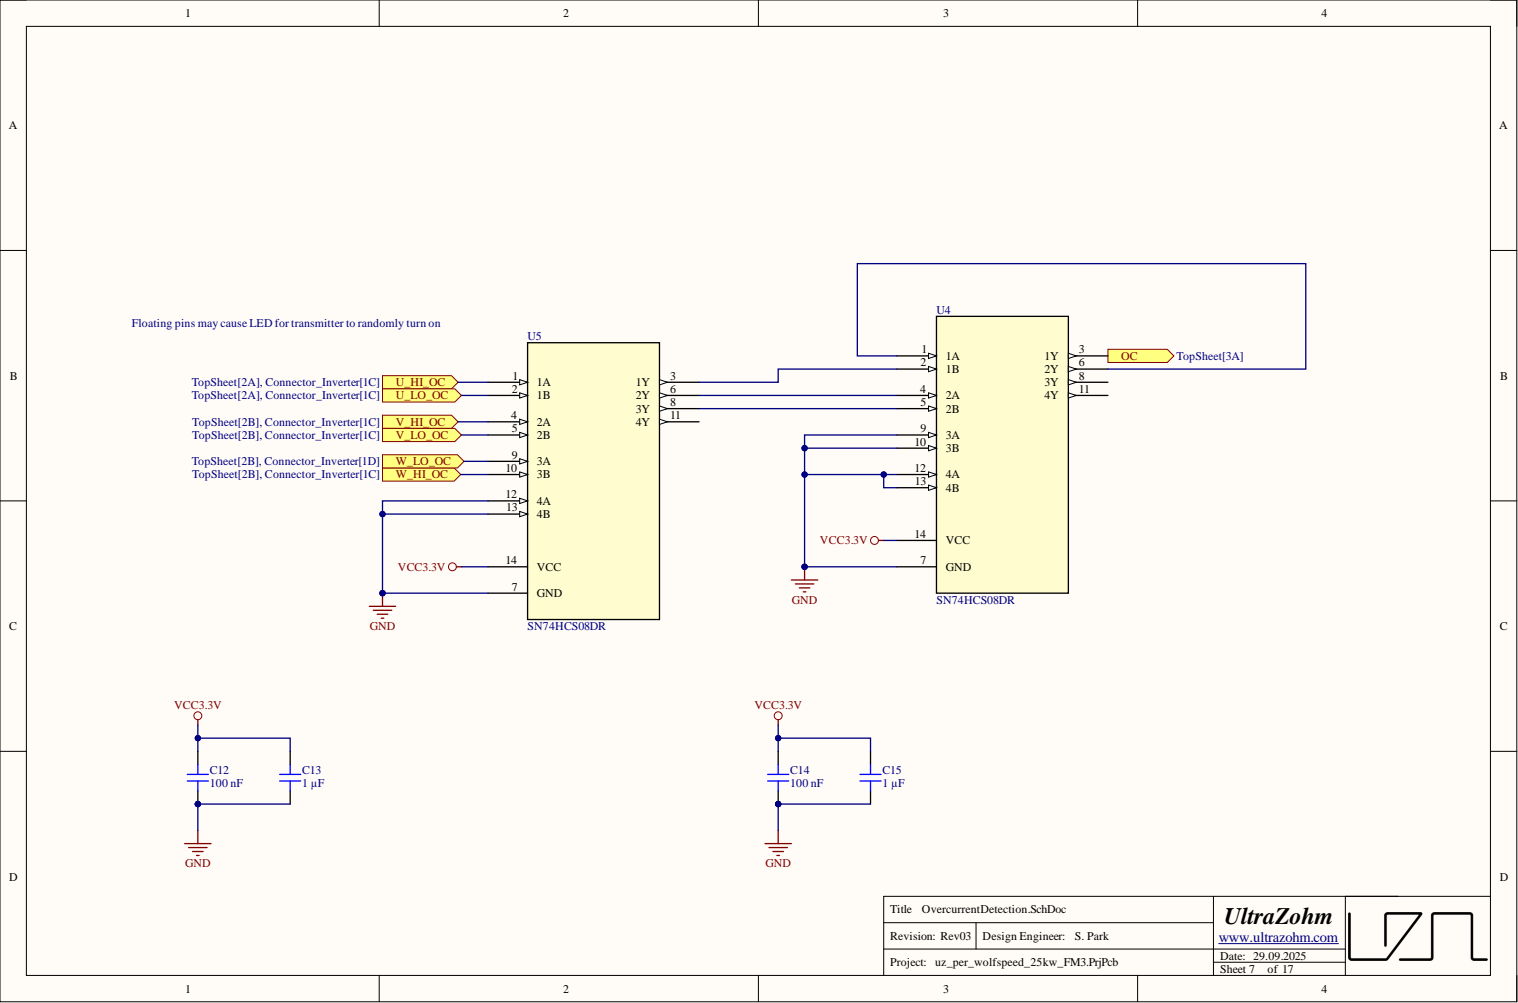
[picture p97: page 16]

Floating pins may cause LED for transmitter to randomly turn on

VCC3.3V | 4B 13

VCC3.3V | VCC 14 GND 7

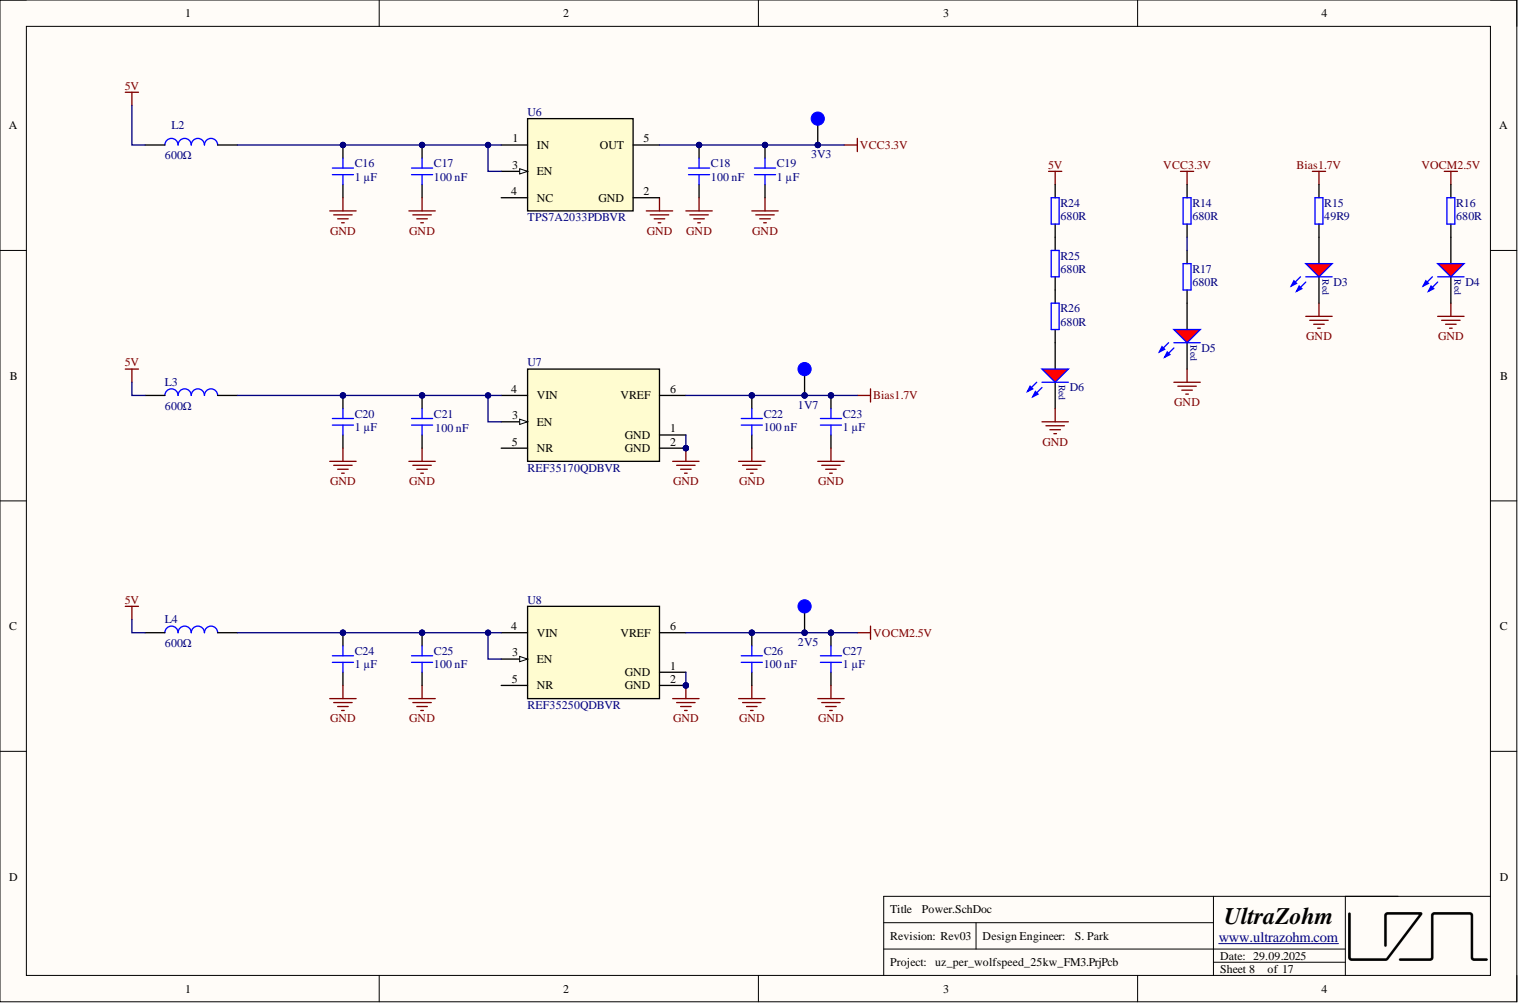
[picture p98: page 17]

Rev i s i o n :

Dat e : .
