ultrazohm/uz_per_wolfspeed_25kw_fm3/LTSpice/CurrentConditioning/FullyDifferentialOpAmp_TESTSimulation.asc

R1: res; 1k
R2: res; 1k
R3: res; 1k
R4: res; 1k
U1: ADL5569
V1: voltage; 5
V2: voltage; 2.5
V3: voltage; 1.65
V4: voltage; SINE(1.65 5 50)
Named nets: 0, Test1, Test2, Test3
.tran 0.1
