ultrazohm/uz_per_wolfspeed_25kw_fm3/LTSpice/OvercurrentDetection/OvercurrentDetection.asc

A1: dflop; Vhigh=3.3 Td=4.5n Trise=3n Tfall=3n
A2: inv; Vhigh=3.3 Trise=3n Tfall=3n
A3: inv; Vhigh=3.3 Trise=3n Tfall=3n
B1: bv; V=if(time < 4m, 1.0, 1.65) * sin(2*pi*{f}*time)+1.65
C2: cap; 0.10µ; V=25
C3: cap; 0.10µ; V=25
C4: cap; 4.7nF; V=50
C5: cap; 0.10µ; V=25
C6: cap; 56p; V=50
C7: cap; 56p; V=50
C11: cap; 4.7nF; V=50
C12: cap; 0.10µ; V=25
C13: cap; 56p; V=50
C14: cap; 56p; V=50
C18: cap; 4.7nF; V=50
C19: cap; 0.10µ; V=25
C20: cap; 56p; V=50
C21: cap; 56p; V=50
R2: res; 2k; pwr=0.1
R3: res; 2k; pwr=0.1
R8: res; 49.9; pwr=0.1
R9: res; 49.9; pwr=0.1
R10: res; 49.9; pwr=0.1
R18: res; 49.9; pwr=0.1
R19: res; 49.9; pwr=0.1
R20: res; 49.9; pwr=0.1
R28: res; 49.9; pwr=0.1
R29: res; 49.9; pwr=0.1
R30: res; 49.9; pwr=0.1
R31: res; 110
R32: res; 887
R33: res; 110
U1: TLV3501
U2: TLV3501
U3: TLV3501
U4: TLV3501
U5: TLV3501
U6: TLV3501
U7: LOGIC_GATE_2PIN_OD_HC_2i_AND_PP_ST_SN74HCS08
U8: LOGIC_GATE_2PIN_OD_HC_2i_AND_PP_ST_SN74HCS08
U9: LOGIC_GATE_2PIN_OD_HC_2i_AND_PP_ST_SN74HCS08
U10: LOGIC_GATE_2PIN_OD_HC_2i_AND_PP_ST_SN74HCS08
U11: LOGIC_GATE_2PIN_OD_HC_2i_AND_PP_ST_SN74HCS08
U12: LOGIC_GATE_2PIN_OD_HC_2i_AND_PP_ST_SN74HCS08
U13: LOGIC_GATE_2PIN_OD_HC_2i_AND_PP_ST_SN74HCS08
U14: LOGIC_GATE_2PIN_OD_HC_2i_AND_PP_ST_SN74HCS08
V1: voltage; 3.3
V2: voltage; SINE(1.65 {A} {f} 0 0 -120)
V3: voltage; 3.3
V4: voltage; SINE(1.65 {A} {f} 0 0 -240)
V5: voltage; PULSE(3.3 0 9m 1n 1n 0.5m 1)
V6: voltage; 3.3
V9: voltage; 3.3
V10: voltage; 3.3
V11: voltage; 3.3
Named nets: 0, LO_OC_REF, HI_OC_REF, I_FILT, U_HI_OC, U_LO_OC, OC_ALL_OK, OC_Latched, GD_EN, USER_Gate_Enable
.tran 0.01
.param A = 1.0
.param f=100
