ultrazohm/uz_per_wolfspeed_25kw_fm3/LTSpice/CurrentConditioning/LTspice_CurrentConditioning.asc

C1: cap; 4.7n; V=25
C2: cap; 100p; V=50V
C3: cap; 100p; V=50 Irms=20.8m Rser=5.448 Lser=0 mfg="KEMET" pn="C0603C101K5RAC" type="X7R"
C4: cap; 4.7n; V=25
I1: current; SINE(01m 0 50); AC 5m
R1: res; 49.9; pwr=0.1
R2: res; 7.87k; pwr=0.1
R3: res; 7.15k; pwr=0.1
R4: res; 1.33k; pwr=0.1
R5: res; 100; pwr=0.75
R6: res; 4.02k; pwr=0.1
R7: res; 2k; pwr=0.1
R8: res; 6k65
R9: res; 6k65
R10: res; 10k
R11: res; 10k
R12: res; 50
R13: res; 50
R14: res; 10k
U1: opamp2; AD8615
U2: THS4561
V1: voltage; 3.3
V2: voltage; 3.3
V3: voltage; 2.5
V5: voltage; 5
V6: voltage; 1.7
Named nets: 0, Test4, Test3, Test5
.tran 0.1
.ac dec 100 10 1000k
.lib AD8615.cir
