ultrazohm/uz_per_wolfspeed_25kw_fm3/LTSpice/DC_VoltageConditioning/DC_VoltageConditioning.asc

C1: cap; 4.7n; V=25
C2: cap; 0.27µ; V=16
C3: cap; 4.7n; V=25
C4: cap; 0.10µ; V=25
C5: cap; 65µ; V=1.1k
C6: cap; 65µ; V=1.1k
C7: cap; 65µ; V=1.1k
R1: res; 49.9; pwr=0.1
R2: res; 3.74k; pwr=0.2
R3: res; 4.99k; pwr=0.1
R4: res; 4.99k; pwr=0.1
R5: res; 249k; pwr=0.25
R6: res; 249k; pwr=0.25
R7: res; 3.74k; pwr=0.2
R8: res; 249k; pwr=0.25
R9: res; 249k; pwr=0.25
R10: res; 249k; pwr=0.25
R11: res; 249k; pwr=0.25
R12: res; 249k; pwr=0.25
R13: res; 249k; pwr=0.25
R14: res; 249k; pwr=0.25
R15: res; 249k; pwr=0.25
R16: res; 249k; pwr=0.25
R17: res; 249k; pwr=0.25
R18: res; 1k
R19: res; 1k
R20: res; 50
R21: res; 50
R22: res; 1k
R23: res; 1k
U1: opamp2; AD8615
U2: THS4561
V1: voltage; 3.3
V2: voltage; 800
V3: voltage; 5
V4: voltage; 2.5
Named nets: 0
.lib AD8615.cir
.tran 0.1
