ultrazohm/uz_per_wolfspeed_25kw_fm3/LTSpice/CurrentConditioning/LTspice_CurrentConditioning_eyke.asc

C1: cap; 4.7n; V=25
C2: cap; 100p; V=50V
C3: cap; 100p
C4: cap; 4.7n; V=25
I1: current; 10e-3
R1: res; 49.9; pwr=0.1
R2: res; 7.87k; pwr=0.1
R3: res; 7.15k; pwr=0.1
R4: res; 1.33k; pwr=0.1
R5: res; 100; pwr=0.75
R6: res; 4.02k; pwr=0.1
R7: res; 2k; pwr=0.1
R8: res; 1k
R9: res; 1k
R10: res; 1k
R11: res; 1k
R12: res; 50
R13: res; 50
R14: res; 10k
R15: res; 10e-3
U2: AD8618
U3: THS4561
V1: voltage; 3.3
V2: voltage; 3.3
V3: voltage; 2.5
V5: voltage; 5
V6: voltage; 1.65
Named nets: 0, Test4, Test3, Test5, Vout_P, Vout_N
.tran .1
.ac dec 100 10 1M
.lib AD8615.cir
.options srcstepmethod=1
.options reltol=0.01 abstol=1e-6 vntol=1e-6 gmin=1e-9
