ultrazohm/uz_per_wolfspeed_25kw_fm3/(list of files, drawings)

Other design files:
Altium/Analog_Measurements.SchDoc
Altium/Connector_Inverter.SchDoc
Altium/CurrentConditioning.SchDoc
Altium/DCVoltageConditioning.SchDoc
Altium/GateAndFanControl.SchDoc
Altium/local_parts/SN74HCS08DR.SchLib
Altium/OvercurrentDetection.SchDoc
Altium/OvercurrentDetectionLogic.SchDoc
Altium/PCB_Interface_Inverter_UZ.PrjPcb
Altium/PCB_Interface_Inverter_UZ.SCHLIB
Altium/Power.SchDoc
Altium/Receivers.SchDoc
Altium/TempSenseConditioning.SchDoc
Altium/TopSheet.SchDoc
Altium/Transmitters.SchDoc
Altium/uz_per_wolfspeed_25kw_FM3.PrjPcb
Altium/uz_per_wolfspeed_25kw_FM3.SCHLIB
TI Edge Connector/MCU047F_Altium/MCU047F.PrjPcb
TI Edge Connector/MCU047F_Altium/MCU047F_Hardware.SchDoc
TI Edge Connector/MCU047F_Altium/MCU047F_Main.SchDoc
uz_per_wolfspeed_25kw_FM3.PrjPcb
Wolfspeed Inverter Files/CRD25DA12N-FMC_Altium/CRD25DA12N-FMC V1.1 (07-2023) - Altium/01 - Notes.SchDoc
Wolfspeed Inverter Files/CRD25DA12N-FMC_Altium/CRD25DA12N-FMC V1.1 (07-2023) - Altium/02 - Power Stage.SchDoc
Wolfspeed Inverter Files/CRD25DA12N-FMC_Altium/CRD25DA12N-FMC V1.1 (07-2023) - Altium/03 - Controller.SchDoc
Wolfspeed Inverter Files/CRD25DA12N-FMC_Altium/CRD25DA12N-FMC V1.1 (07-2023) - Altium/04 - Auxiliary Power.SchDoc
Wolfspeed Inverter Files/CRD25DA12N-FMC_Altium/CRD25DA12N-FMC V1.1 (07-2023) - Altium/05 - Gate Drivers.SchDoc
Wolfspeed Inverter Files/CRD25DA12N-FMC_Altium/CRD25DA12N-FMC V1.1 (07-2023) - Altium/06 - Voltage Sense.SchDoc
Wolfspeed Inverter Files/CRD25DA12N-FMC_Altium/CRD25DA12N-FMC V1.1 (07-2023) - Altium/07 - Current Sense.SchDoc
Wolfspeed Inverter Files/CRD25DA12N-FMC_Altium/CRD25DA12N-FMC V1.1 (07-2023) - Altium/08 - Resolver.SchDoc
Wolfspeed Inverter Files/CRD25DA12N-FMC_Altium/CRD25DA12N-FMC V1.1 (07-2023) - Altium/CRD25DA12N-FMC V1-1 (07-2023).PrjPcb
Wolfspeed Inverter Files/CRD25DA12N-FMC_Altium/CRD25DA12N-FMC V1.1 (07-2023) - Altium/CRD25DA12N-FMC.SchLib
Wolfspeed Inverter Files/CRD25DA12N-FMC_Altium/CRD25DA12N-FMC V1.2 (01-2024) - Altium/01 - Notes.SchDoc
Wolfspeed Inverter Files/CRD25DA12N-FMC_Altium/CRD25DA12N-FMC V1.2 (01-2024) - Altium/02 - Power Stage.SchDoc
Wolfspeed Inverter Files/CRD25DA12N-FMC_Altium/CRD25DA12N-FMC V1.2 (01-2024) - Altium/03 - Controller.SchDoc
Wolfspeed Inverter Files/CRD25DA12N-FMC_Altium/CRD25DA12N-FMC V1.2 (01-2024) - Altium/04 - Auxiliary Power.SchDoc
Wolfspeed Inverter Files/CRD25DA12N-FMC_Altium/CRD25DA12N-FMC V1.2 (01-2024) - Altium/05 - Gate Drivers.SchDoc
Wolfspeed Inverter Files/CRD25DA12N-FMC_Altium/CRD25DA12N-FMC V1.2 (01-2024) - Altium/06 - Voltage Sense.SchDoc
Wolfspeed Inverter Files/CRD25DA12N-FMC_Altium/CRD25DA12N-FMC V1.2 (01-2024) - Altium/07 - Current Sense.SchDoc
Wolfspeed Inverter Files/CRD25DA12N-FMC_Altium/CRD25DA12N-FMC V1.2 (01-2024) - Altium/08 - Resolver.SchDoc
Wolfspeed Inverter Files/CRD25DA12N-FMC_Altium/CRD25DA12N-FMC V1.2 (01-2024) - Altium/CRD25DA12N-FMC V1-2 (01-2024).PrjPcb
Wolfspeed Inverter Files/CRD25DA12N-FMC_Altium/CRD25DA12N-FMC V1.2 (01-2024) - Altium/CRD25DA12N-FMC.SchLib
Wolfspeed Inverter Files/CRD25DA12N-FMC_Altium/CRD25DA12N-FMC V2.0 (09-2024) - Altium/01 - Notes.SchDoc
Wolfspeed Inverter Files/CRD25DA12N-FMC_Altium/CRD25DA12N-FMC V2.0 (09-2024) - Altium/02 - Power Stage.SchDoc
Wolfspeed Inverter Files/CRD25DA12N-FMC_Altium/CRD25DA12N-FMC V2.0 (09-2024) - Altium/03 - Controller.SchDoc
Wolfspeed Inverter Files/CRD25DA12N-FMC_Altium/CRD25DA12N-FMC V2.0 (09-2024) - Altium/04 - Auxiliary Power.SchDoc
Wolfspeed Inverter Files/CRD25DA12N-FMC_Altium/CRD25DA12N-FMC V2.0 (09-2024) - Altium/05 - Gate Drivers.SchDoc
Wolfspeed Inverter Files/CRD25DA12N-FMC_Altium/CRD25DA12N-FMC V2.0 (09-2024) - Altium/06 - Voltage Sense.SchDoc
Wolfspeed Inverter Files/CRD25DA12N-FMC_Altium/CRD25DA12N-FMC V2.0 (09-2024) - Altium/07 - Current-Temp Sense.SchDoc
Wolfspeed Inverter Files/CRD25DA12N-FMC_Altium/CRD25DA12N-FMC V2.0 (09-2024) - Altium/08 - Resolver.SchDoc
Wolfspeed Inverter Files/CRD25DA12N-FMC_Altium/CRD25DA12N-FMC V2.0 (09-2024) - Altium/09 - Controlled Power.SchDoc
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
