ultrazohm/uz_per_wolfspeed_25kw_fm3/(commit log)

2025-01-14 I hope this works
    [EthernetPort.SchDoc, FullyDifferentialOpAmps.SchDoc, OvercurrentDetection.SchDoc, PCB_Interface_Inverter_UZ.PrjPcb, Receivers.SchDoc, SamtechConnector.SchDoc, TopSheet.SchDoc, Transmitters.SchDoc]
2025-01-14 Analog signals and Transmitters
    [FullyDifferentialOpAmps.SchDoc, OvercurrentDetection.SchDoc, Receivers.SchDoc, SamtechConnector.SchDoc, TopSheet.SchDoc, Transmitters.SchDoc]
2025-01-15 add gitignore and small changes to transmitter
    [Transmitters.SchDoc]
2025-01-15 fix pcb outline to include J1
    [PCB.PcbLib, PCB_Interface_Inverter_UZ.PrjPcb, PCB_Interface_Inverter_UZ.SCHLIB, SamtechConnector.SchDoc]
2025-01-15 topsheet analog signals
    [EthernetPort.SchDoc, TopSheet.SchDoc]
2025-01-15 Test after renaming repository
    [FullyDifferentialOpAmps.SchDoc]
2025-01-15 cleaning up file heirarchy
    [EthernetPort.SchDoc, FullyDifferentialOpAmps.SchDoc, OvercurrentDetection.SchDoc, PCB.PcbLib, PCB_Interface_Inverter_UZ.PrjPcb, PCB_Interface_Inverter_UZ.SCHLIB, Receivers.SchDoc, SamtechConnector.SchDoc]
2025-01-15 name changes for schematic
    [AnalogMeasurements.SchDoc, Analog_Measurements.SchDoc, Connector_AnalogSig.SchDoc, Connector_Inverter.SchDoc, EthernetPort.SchDoc, PCB_Interface_Inverter_UZ.PrjPcb, SamtechConnector.SchDoc, TopSheet.SchDoc]
2025-01-16 Schematic Changes from Feedback
    [AnalogMeasurements.SchDoc, Connector_AnalogSig.SchDoc, Connector_Inverter.SchDoc, OvercurrentDetection.SchDoc, PCB_Interface_Inverter_UZ.PrjPcb, Power.SchDoc, Receivers.SchDoc, TopSheet.SchDoc]
2025-01-16 minor changes
    [Connector_Inverter.SchDoc, PCB_Interface_Inverter_UZ.PrjPcb, Power.SchDoc, TopSheet.SchDoc]
2025-01-16 Overcurrent Detection new AND Gates
    [AnalogMeasurements.SchDoc, Connector_Inverter.SchDoc, OvercurrentDetection.SchDoc, PCB_Interface_Inverter_UZ.PrjPcb, Power.SchDoc, Receivers.SchDoc]
2025-01-21 DCVConditioning Schematic added and Schematic Sheet names changed
    [AnalogMeasurements.SchDoc, CurrentConditioning.SchDoc, DCVoltageConditioning.SchDoc, PCB_Interface_Inverter_UZ.PrjPcb, TopSheet.SchDoc]
2025-01-21 PCB and project names changed
    [uz_per_wolfspeed_25kw_FM3.PrjPcb]
2025-01-21 small changes to schematic & excel with current pull of all components
    [Connector_AnalogSig.SchDoc, CurrentConditioning.SchDoc, DCVoltageConditioning.SchDoc, InterfacePowerDesign.xlsx, OvercurrentDetection.SchDoc, Receivers.SchDoc, Transmitters.SchDoc]
2025-01-22 Power Schematic of pcb interface (work in progress)
    [CurrentConditioning.SchDoc, DCVoltageConditioning.SchDoc, Power.SchDoc]
2025-01-30 Schematic & LTspice changes - changes made recorded in onenote
    [CurrentConditioning.SchDoc, DCVoltageConditioning.SchDoc, InterfacePowerDesign.xlsx, OvercurrentDetection.SchDoc, Power.SchDoc, Transmitters.SchDoc]
2025-01-30 trying something because it is taking ages for the components to load on pcb file
    [Receivers.SchDoc, Transmitters.SchDoc, uz_per_wolfspeed_25kw_FM3.PrjPcb, uz_per_wolfspeed_25kw_FM3.SCHLIB]
2025-01-30 Capacitors, cleaning up, resistors 0.1%, everything discussed during 30.01.25 meeting changed
    [Connector_AnalogSig.SchDoc, Connector_Inverter.SchDoc, CurrentConditioning.SchDoc, DCVoltageConditioning.SchDoc, OvercurrentDetection.SchDoc, PCB1.PcbDoc, Power.SchDoc, Receivers.SchDoc]
2025-02-01 diode resistors - is this correct?
    [Power.SchDoc]
2025-02-03 test layout initial pcb
    [PCB1.PcbDoc, PCB_BoardShape.DXF, PCB_BoardShape.SLDASM, Receivers.SchDoc, Transmitters.SchDoc, uz_per_wolfspeed_25kw_FM3.PrjPcb]
2025-02-04 more mature initial layout for review
    [uz_per_wolfspeed_25kw_FM3.PrjPcb]
2025-02-05 small changes to pcb layout power/analog
2025-02-06 top sheet changes, differential signalling added, now moving to sourcetree gui
    [Connector_AnalogSig.SchDoc, CurrentConditioning.SchDoc, DCVoltageConditioning.SchDoc, Power.SchDoc, Receivers.SchDoc, TopSheet.SchDoc, Transmitters.SchDoc, uz_per_wolfspeed_25kw_FM3.PrjPcb]
2025-02-06 test with
    [TopSheet.SchDoc]
2025-02-06 All Component Designators changed - automated pcb layout of op amps - analog signals completed
    [Connector_Inverter.SchDoc, CurrentConditioning.SchDoc, DCVoltageConditioning.SchDoc, OvercurrentDetection.SchDoc, Power.SchDoc, Receivers.SchDoc, TopSheet.SchDoc, Transmitters.SchDoc]
2025-02-08 LED Resistors Changed in Power Schematics - Confirm with Eyke that this is correct
    [Power.SchDoc]
2025-02-08 Board Shape made smaller. Ready for Review
    [DCVoltageConditioning.SchDoc, PCB_BoardShape.SLDASM, PCB_BoardShape_smaller15mm.DXF, PCB_BoardShape_smaller20mm.DXF]
2025-02-11 many little changes towards routing: add polyongs, UZ logo, replace X2, etc
    [Connector_Inverter.SchDoc, CurrentConditioning.SchDoc, DCVoltageConditioning.SchDoc, OvercurrentDetection.SchDoc, Power.SchDoc, Receivers.SchDoc, TopSheet.SchDoc, Transmitters.SchDoc]
2025-02-11 forgot to commit changes :)
    [uz_per_wolfspeed_25kw_FM3.PrjPcb]
2025-02-12 All components moved to the top of the board - Ready for Review
    [uz_per_wolfspeed_25kw_FM3.PrjPcb]
2025-02-12 Polygons VCC & GND repoured
2025-02-12 improve layout, small schematic changes
    [Connector_Inverter.SchDoc, Power.SchDoc, Receivers.SchDoc, Transmitters.SchDoc]
2025-02-12 smaller PCB board, layout changes, everything made more compact
    [PCB_BoardShape.SLDASM, PCB_BoardShape_smaller15mm.DXF, PCB_BoardShape_smaller20mm.DXF, Power.SchDoc, Receivers.SchDoc, Transmitters.SchDoc]
2025-02-13 R8,R11,Capacitor changed
    [CurrentConditioning.SchDoc, DCVoltageConditioning.SchDoc, Receivers.SchDoc, Transmitters.SchDoc]
2025-02-13 deleted double capacitor
    [Power.SchDoc]
2025-02-13 Meeting with Eyke - changes made
    [CurrentConditioning.SchDoc, Power.SchDoc, Receivers.SchDoc, Transmitters.SchDoc, uz_per_wolfspeed_25kw_FM3.PrjPcb]
2025-02-13 Silkscreen placed, ethernet jack changed
    [TopSheet.SchDoc]
2025-02-18 PCB Board overlay designators changed, Ethernet port orientation changed, signals have been labelled for digital optical
    [TopSheet.SchDoc, uz_per_wolfspeed_25kw_FM3.PrjPcb]
2025-02-18 BOM Consolidated
    [Connector_Inverter.SchDoc, DCVoltageConditioning.SchDoc, Power.SchDoc, Receivers.SchDoc, Transmitters.SchDoc]
2025-02-18 Through hole added for Befestigung - Ready for Review b4 routing
    [Connector_Inverter.SchDoc, Power.SchDoc, uz_per_wolfspeed_25kw_FM3.PrjPcb]
2025-02-19 First attempts at routing 1.7V bias
2025-02-25 Tx/Rx distance modified to 2.54mm
2025-02-27 capacitors placed on 5V, Tx/Rx locations changed to optimize routing, continued changes
    [Connector_Inverter.SchDoc, Power.SchDoc, uz_per_wolfspeed_25kw_FM3.PrjPcb]
2025-02-27 small changes, tidying up
    [Receivers.SchDoc]
2025-02-27 Changes made during review meeting + additional needed changes
    [Connector_Inverter.SchDoc, OvercurrentDetection.SchDoc, Power.SchDoc, Receivers.SchDoc, Transmitters.SchDoc]
2025-02-28 GND connections for everything, BOM consolidation, LCSC numbers, space signal tracks, change op amp input resistor orientation
    [Connector_Inverter.SchDoc, CurrentConditioning.SchDoc, DCVoltageConditioning.SchDoc, OvercurrentDetection.SchDoc, Power.SchDoc, Receivers.SchDoc, TopSheet.SchDoc, Transmitters.SchDoc]
2025-02-28 3DBodies on M3, 10uF footprint change, 1uF caps in bom, LCSC part numbers for Tx/Ferrite Bead/1.7V reference, Design Rule check
    [Connector_Inverter.SchDoc, Power.SchDoc, Transmitters.SchDoc]
2025-02-28 added variants for assembly at jlc
    [uz_per_wolfspeed_25kw_FM3.PrjPcb]
2025-03-11 Project was moved to the native VCS repository (Versioned Storage) in your Altium Server. Your local project (local repository) now needs to be switched to point to this new remote repository. Please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
    [uz_per_wolfspeed_25kw_FM3.PrjPcb]
2025-03-15 changing footprint and schematics to the edge card connector
    [Connector_Inverter.SchDoc, PCB.PcbLib, uz_per_wolfspeed_25kw_FM3.SCHLIB]
2025-03-19 saving status
    [uz_per_wolfspeed_25kw_FM3.SCHLIB]
2025-03-19 5V LED added, zugehörige resistors added, etc.
    [Connector_Inverter.SchDoc, Power.SchDoc, TopSheet.SchDoc, uz_per_wolfspeed_25kw_FM3.SCHLIB]
2025-03-19 adding rev01 production files
    [BOM_JLC_uz_per_wolfspeed_25kw_FM3_jlc_Rev01_mod28Feb2025.xlsx, Pick_and_Place_uz_per_wolfspeed_25kw_FM3_jlc_Rev01.csv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]
2025-03-19 change back folder structure
    move text field on pcb
    change some part numbers for jlc assembly
    [CurrentConditioning.SchDoc, DCVoltageConditioning.SchDoc, OvercurrentDetection.SchDoc, Power.SchDoc, Receivers.SchDoc, Transmitters.SchDoc, uz_per_wolfspeed_25kw_FM3.PrjPcb]
2025-03-19 Final polygon changes - 3.3V/5V - more vias added for 3.3V/5V ready for ordering
2025-03-19 ready to order
    [uz_per_wolfspeed_25kw_FM3.PrjPcb]
2025-03-19 production files rev02
    [BOM_JLC_uz_per_wolfspeed_25kw_FM3_jlc_Rev02.xlsx, Pick_and_Place_uz_per_wolfspeed_25kw_FM3_jlc_Rev02.csv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]
2025-04-03 Trying to change the connector but pcb file from library not being read by the project
    [Connector_Inverter.SchDoc, PCB.PcbLib]
2025-04-03 connector changed
    [Connector_Inverter.SchDoc]
2025-04-06 mounting hole, ethernet connector position change, lables made larger, Resistor for 1.7V line changed
    [Power.SchDoc]
2025-04-13 final check done! Ready for ordering
    [OvercurrentDetection.SchDoc]
2025-04-14 edge connector check printout
2025-04-14 changed revision numbering -> Rev03
    [uz_per_wolfspeed_25kw_FM3.PrjPcb]
2025-09-29 production files Rev03
    [BOM_JLC_uz_per_wolfspeed_25kw_FM3_jlc_Rev03.xlsx, Pick_and_Place_uz_per_wolfspeed_25kw_FM3_jlc_Rev03.csv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]
2025-09-29 generate schematic for Rev03
2025-09-29 gathered wolfspeed and TI files
    [01 - Notes.SchDoc, 02 - Power Stage.SchDoc, 03 - Controller.SchDoc, 04 - Auxiliary Power.SchDoc, 05 - Gate Drivers.SchDoc, 06 - Voltage Sense.SchDoc, 07 - Current Sense.SchDoc, 08 - Resolver.SchDoc]
2026-01-27 pcb mounting support files
    [PCB_Mounting.STEP, PCB_Mounting.step.STL, PCB_Mounting_TEST.SLDPRT]
2026-01-27 PCB_Mounting: added 2mm Material to the base of the part. Changes were made in FreeCAD, not in the SolidWorks part.
    [PCB_Mounting_plus2mm.FCStd, PCB_Mounting_plus2mm.STL, PCB_Mounting_plus2mm.step]
2026-03-10 add wolfspeed files for new revisions
    [01 - Notes.SchDoc, 02 - Power Stage.SchDoc, 03 - Controller.SchDoc, 04 - Auxiliary Power.SchDoc, 05 - Gate Drivers.SchDoc, 06 - Voltage Sense.SchDoc, 07 - Current Sense.SchDoc, 07 - Current-Temp Sense.SchDoc]
2026-06-09 Inverted optical receive signal 7 for Gate disable in order to have intuitive behavior: opt signal high is gate enable. Wired original Receive Signal 7 to FANx_OUT in order to have fans enabled when 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
    [Connector_Inverter.SchDoc, GateAndFanControl.SchDoc, TopSheet.SchDoc, uz_per_wolfspeed_25kw_FM3.PrjPcb]
2026-06-09 fixed wiring of v_dc_meas. Was Connector Pin 21, is now Pin 27. Updated Project Params
    [Connector_Inverter.SchDoc, GateAndFanControl.SchDoc, uz_per_wolfspeed_25kw_FM3.PrjPcb]
2026-06-09 connected Pins 21 and 27 at main connector to be compatible to Inverter Rev1.1 and Rev2.0 for the v_dc_meas
    [Connector_Inverter.SchDoc]
2026-06-09 Added comparator circuitry for OC detection
    [Connector_Inverter.SchDoc, GateAndFanControl.SchDoc, OvercurrentDetection.SchDoc, OvercurrentDetectionLogic.SchDoc, TopSheet.SchDoc, uz_per_wolfspeed_25kw_FM3.PrjPcb]
2026-06-09 changed ref voltages for OC detection from two dividers to resistive ladder approach.
    [Connector_Inverter.SchDoc, GateAndFanControl.SchDoc, OvercurrentDetection.SchDoc, OvercurrentDetectionLogic.SchDoc]
2026-06-09 first thoughts on OC latch part. Added box for TempSense conditioning with no circuitry for now
    [Connector_Inverter.SchDoc, OvercurrentDetectionLogic.SchDoc, TempSenseConditioning.SchDoc, TopSheet.SchDoc, uz_per_wolfspeed_25kw_FM3.PrjPcb]
2026-06-11 finished OC detection with LED indicator, latch and reset function, and automated gate disable when OC latched.
    [GateAndFanControl.SchDoc, OvercurrentDetection.SchDoc, OvercurrentDetectionLogic.SchDoc, TopSheet.SchDoc, uz_per_wolfspeed_25kw_FM3.PrjPcb]
2026-06-11 added NTC temperature to PWM conversion
    [TempSenseConditioning.SchDoc]
2026-06-11 assigned designators, last save before first d+u
    [Connector_Inverter.SchDoc, CurrentConditioning.SchDoc, DCVoltageConditioning.SchDoc, GateAndFanControl.SchDoc, OvercurrentDetection.SchDoc, OvercurrentDetectionLogic.SchDoc, Power.SchDoc, Receivers.SchDoc]
2026-06-11 hacky fix of local library issues. started layout
    [Connector_Inverter.SchDoc, OvercurrentDetectionLogic.SchDoc, SN74HCS08DR.SchLib, SOIC127P600X175-14N.PcbLib, Transmitters.SchDoc, uz_per_wolfspeed_25kw_FM3.PrjPcb]
2026-06-12 placed parts to PCB and routed signals
    [OvercurrentDetection.SchDoc, OvercurrentDetectionLogic.SchDoc]
2026-06-15 finalized pcb design. DRC ok. updated ltspice limulation for overcurrent latch and reset. generated output job files for Rev04
    [BOM_JLC_uz_per_wolfspeed_25kw_FM3_jlc_Rev04.xlsx, BOM_uz_per_wolfspeed_25kw_FM3_jlc_Rev04.xlsx, Connector_Inverter.SchDoc, DCVoltageConditioning.SchDoc, OvercurrentDetection.SchDoc, OvercurrentDetectionLogic.SchDoc, Pick_and_Place_uz_per_wolfspeed_25kw_FM3_jlc_Rev04.csv, Power.SchDoc]
2026-06-23 updated SN74HCS08DR from library und reconnected the two parts. recreated outputjob files, but production was done with the zipped sources
    [BOM_JLC_uz_per_wolfspeed_25kw_FM3_jlc_Rev04.xlsx, BOM_uz_per_wolfspeed_25kw_FM3_jlc_Rev04.xlsx, OvercurrentDetectionLogic.SchDoc, PCB.PcbLib, Pick_and_Place_uz_per_wolfspeed_25kw_FM3_jlc_Rev04.csv, SOIC127P600X175-14N.PcbLib, TopSheet.SchDoc, uz_per_wolfspeed_25kw_FM3.PrjPcb]
2026-07-08 added commissioning protocol for Rev04
    [uz_per_wolfspeed_25kw_FM3_Rev04_Inbetriebnahme.xlsx]
2026-07-08 updated note to commissioning excel -> NTC duty to Temperature does not match Wolfspeed docs
    [uz_per_wolfspeed_25kw_FM3_Rev04_Inbetriebnahme.xlsx]
2026-07-08 added cad files for mounting clamps
    [BothClamps.3mf, Clamp.SLDPRT, Clamp.STL, Clamp_long - Kopie.SLDPRT, Clamp_long - Kopie.STL]
2026-07-23 updated Inbetriebnahme sheet with assumed Temperature to PWM dutycycle function
    [uz_per_wolfspeed_25kw_FM3_Rev04_Inbetriebnahme.xlsx]
